magikh0e/pueo/assets/social-preview.png

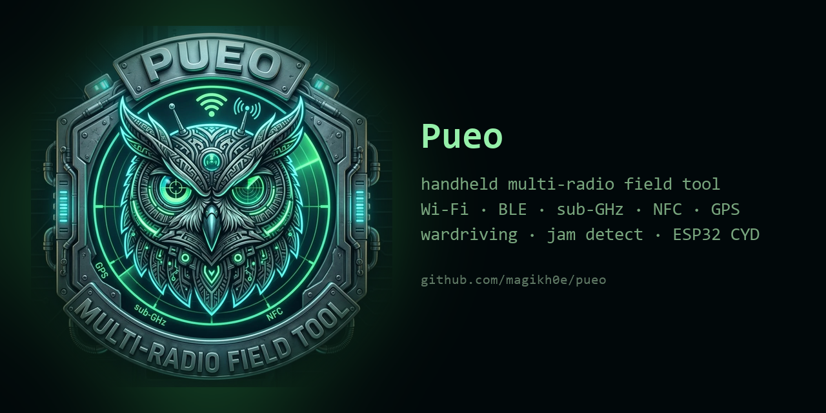
assets/social-preview.png
