magikh0e/pueo/ESP32-DIV/shared.h

#ifndef SHARED_H
#define SHARED_H
#include <stdint.h>
#include "BoardConfig.h"

/*──────────────────── Colors ────────────────────*/
const uint16_t GRAY = 0x8410, BLUE = 0x001F, RED = 0xF800,
               GREEN  = 0xB721, BLACK = 0x0000, WHITE = 0xFFFF,
               LIGHT_GRAY = 0xC618, DARK_GRAY = 0x4208;

uint16_t uiUniversalColor();
#define ORANGE uiUniversalColor()
               
#define TFT_DARKBLUE   0x3166
#define TFT_LIGHTBLUE  0x051F
#define TFTWHITE       0xFFFF
#define TFT_GRAY       0x8410

#ifdef TFT_GREEN
#undef TFT_GREEN
#endif
#define TFT_GREEN GREEN
#ifdef TFT_GREENYELLOW
#undef TFT_GREENYELLOW
#endif
#define TFT_GREENYELLOW GREEN

#define BG_Dark        0x20e4
#define BG_Light       0xf7de
#define FG_Dark        0x3166
#define FG_Light       0xe73c
#define LINE_Dark      0x8410  
#define LINE_Light     0x8410  
#define ICON_Dark      0xFBE4 
#define ICON_Light     0xFBE4
#define TEXT_Dark      0xFFFF
#define TEXT_Light     0x0000   
#define UI_ACCENT      0x3166

#define L_Dark        0x4208
#define L_Light       0xC618

// Default background for feature screens (separate from main menu background).
// Currently black, but you can change this one define to restyle all features.
#ifndef FEATURE_BG
#define FEATURE_BG BLACK
#endif

/*──────────────────── UI Defaults ────────────────────*/
#ifndef UI_BG
#define UI_BG UI.bg
#endif
#ifndef UI_FG
#define UI_FG UI.fg
#endif
#ifndef UI_ICON
#define UI_ICON UI.icon
#endif
#ifndef UI_TEXT
#define UI_TEXT UI.text
#endif
#ifndef UI_LINE
#define UI_LINE UI.line
#endif
#ifndef UI_LABLE
#define UI_LABLE UI.lable
#endif
#ifndef UI_ACCENT
#define UI_ACCENT UI.accent
#endif
#ifndef UI_WARN
#define UI_WARN UI.warn
#endif
#ifndef UI_OK
#define UI_OK GREEN
#endif

/*──────────────────── Project Info ────────────────────*/
/* What the board calls itself over BLE, which is what a phone shows when it
 * asks to pair. It said ESP32-DIV, which is upstream's name and not this
 * one, and it is the name that turned up on a phone minutes after Sour Apple
 * had been closed. Nothing compares against it; it is only announced. */
#ifndef PUEO_BLE_NAME
#define PUEO_BLE_NAME "Pueo"
#endif
#ifndef ESP32DIV_VERSION
#define ESP32DIV_VERSION "v1.7.2"
#endif


static inline constexpr uint8_t k0() { return (uint8_t)('h' - '`'); }

static const uint8_t OBF_PN[]   = {77, 91, 88, 59, 58, 37, 76, 65, 94};                              
static const uint8_t OBF_DN[]   = {75, 97, 110, 109, 122, 92, 109, 107, 96};                           
static const uint8_t OBF_EM[]   = {107, 97, 110, 109, 122, 124, 109, 107, 96, 72, 111, 101, 105, 97, 100, 38, 107, 103, 101};  
static const uint8_t OBF_GH[]   = {111, 97, 124, 96, 125, 106, 38, 107, 103, 101, 39, 107, 97, 110, 109, 122, 124, 109, 107, 96}; 
static const uint8_t OBF_WB[]   = {75, 97, 110, 109, 122, 92, 109, 107, 96, 38, 102, 109, 124};       

/*──────────────────── Board Selection ────────────────────*/
// Default is selected in BoardConfig.h. You can also pass a BOARD_* define
// from your build flags to target a board without editing source.
#if !defined(BOARD_ESP32_DIV_V2) && !defined(BOARD_CYD) && !defined(BOARD_ESP32_DIV_V1)
#define BOARD_ESP32_DIV_V2
#endif

#if (defined(BOARD_ESP32_DIV_V2) + defined(BOARD_CYD) + defined(BOARD_ESP32_DIV_V1)) > 1
#error "Select only one board: BOARD_ESP32_DIV_V2, BOARD_ESP32_DIV_V1, or BOARD_CYD"
#endif

#if defined(BOARD_CYD)
#ifndef ESP32DIV_BOARD_NAME
#define ESP32DIV_BOARD_NAME "CYD ESP32-2432S028R"
#endif
#ifndef HAS_PCF8574_BUTTONS
#define HAS_PCF8574_BUTTONS 0
#endif
#ifndef BOARD_HAS_ESP32S3
#define BOARD_HAS_ESP32S3 0
#endif
#elif defined(BOARD_ESP32_DIV_V1)
#ifndef ESP32DIV_BOARD_NAME
#define ESP32DIV_BOARD_NAME "ESP32-DIV V1 ESP32U"
#endif
#ifndef HAS_PCF8574_BUTTONS
#define HAS_PCF8574_BUTTONS 1
#endif
#ifndef BOARD_HAS_ESP32S3
#define BOARD_HAS_ESP32S3 0
#endif
#elif defined(BOARD_ESP32_DIV_V2)
#ifndef ESP32DIV_BOARD_NAME
#define ESP32DIV_BOARD_NAME "ESP32-DIV V2"
#endif
#ifndef HAS_PCF8574_BUTTONS
#define HAS_PCF8574_BUTTONS 1
#endif
#ifndef BOARD_HAS_ESP32S3
#define BOARD_HAS_ESP32S3 1
#endif
#else
#error "Unknown board: define BOARD_ESP32_DIV_V2, BOARD_ESP32_DIV_V1, or BOARD_CYD"
#endif

/* v1 ESP32 has less internal DRAM for static buffers; v2/S3 keeps full sizes. */
#if BOARD_HAS_ESP32S3
#define ESP32DIV_FFT_SAMPLES       256
#define ESP32DIV_FFT_PALETTE_SIZE  128
#define ESP32DIV_PKT_GRAPH_WIDTH   PUEO_SCREEN_W
#define ESP32DIV_JD_WAVE_WIDTH     (PUEO_SCREEN_W - 20)
#define ESP32DIV_JD_RSSI_SAMPLES   128
#define ESP32DIV_BLE_SCANNER_BARS  128
#define ESP32DIV_BLE_SCANNER_CHANS 128
#define ESP32DIV_ESB_RP_CAPTURES   8
#define ESP32DIV_ESB_RP_SEL_LINES  8
#define ESP32DIV_ESB_RP_LOG_LINES  10
#define ESP32DIV_MAX_WIFI_NETWORKS 50
#define ESP32DIV_PCAP_POOL_SIZE    10
#define ESP32DIV_PCAP_SNAP_LEN     2324
#define ESP32DIV_RFID_SRC_PAGES    256
#else
#define ESP32DIV_FFT_SAMPLES       256
#define ESP32DIV_FFT_PALETTE_SIZE  128
#define ESP32DIV_PKT_GRAPH_WIDTH   PUEO_SCREEN_W
#define ESP32DIV_JD_WAVE_WIDTH     (PUEO_SCREEN_W - 20)
#define ESP32DIV_JD_RSSI_SAMPLES   64
#define ESP32DIV_BLE_SCANNER_BARS  64
#define ESP32DIV_BLE_SCANNER_CHANS 64
#define ESP32DIV_ESB_RP_CAPTURES   4
#define ESP32DIV_ESB_RP_SEL_LINES  4
#define ESP32DIV_ESB_RP_LOG_LINES  6
#define ESP32DIV_MAX_WIFI_NETWORKS 28
/* Was 3, which lost every handshake. The pool is taken a slot at a time in
 * the promiscuous callback and given back after a card write, so its depth
 * is how long a burst can be before frames are dropped. A four-way exchange
 * is four frames in a few milliseconds and it arrives while the channel is
 * busy with the association that caused it. Sixteen slots of 549 bytes is
 * 8.8 KB of heap, held only while Packet Monitor runs. */
#define ESP32DIV_PCAP_POOL_SIZE    16
#define ESP32DIV_PCAP_SNAP_LEN     512
#define ESP32DIV_RFID_SRC_PAGES    128
#endif

/* The one FFT scratch pair, shared by the packet monitor and the sub-GHz
 * spectrum.
 *
 * Both features refill all ESP32DIV_FFT_SAMPLES entries every frame, set the
 * imaginary half to 1, transform in place, read the magnitudes and keep
 * nothing, so there is no state here to preserve across a frame. They also
 * cannot overlap: the dispatcher runs one feature's loop to its exit before
 * returning to the menu.
 *
 * Kept as one pair because static DRAM is what this part runs out of first.
 * Two pairs cost four kilobytes to hold the same numbers twice, while two
 * screens in a row have had to be cut down to find a few dozen bytes.
 */
extern double pueoFftReal[ESP32DIV_FFT_SAMPLES];
extern double pueoFftImag[ESP32DIV_FFT_SAMPLES];


/* Bring-up 2026-09-20: the board in hand is a 3.5" ESP32-3248S035R
 * (ST7796, 320x480, XPT2046 on the display's own SPI bus), not the 2.8"
 * ESP32-2432S028R this profile was written for. Everything the upstream
 * profile gets wrong about it is gathered here.
 * TODO: make this a real board profile rather than a pile of overrides. */

/* From the on-device calibrator, four crosshairs at the 20 px inset,
 * extrapolated out to the screen edges. Both axes run backwards on this
 * panel -- raw falls as the screen coordinate rises -- and that is carried
 * in the numbers rather than in a separate invert flag: the pair is
 * (raw at 0, raw at max), and map() handles a descending range natively.
 * Measured: x 3591/3259 at screen 20 against 514/406 at 300;
 *           y 3675/3673 at screen 20 against 372/457 at 460. */
#define TOUCH_PROFILE_ID "CYD35"
#define TOUCH_X_MIN 3637   /* raw at screen x = 0   */
#define TOUCH_X_MAX 259    /* raw at screen x = 319 */
#define TOUCH_Y_MIN 3822   /* raw at screen y = 0   */
#define TOUCH_Y_MAX 274    /* raw at screen y = 479 */
#define TOUCH_INVERT_Y 0   /* direction lives in the values above */
#define TOUCH_ROTATION 1   /* measured: rotation 0 transposed the axes */

#ifndef TOUCH_INVERT_Y
#define TOUCH_INVERT_Y 0
#endif

/*──────────────────── Touch calibration profiles ────────────────────*/
/* Factory defaults per board (raw XPT2046 range). Override in BoardConfig.h.
 * User-saved calibration in settings.json overrides when board id matches. */
#if defined(BOARD_CYD)
#ifndef TOUCH_PROFILE_ID
#define TOUCH_PROFILE_ID "CYD"
#endif
#ifndef TOUCH_X_MIN
#define TOUCH_X_MIN 200
#endif
#ifndef TOUCH_X_MAX
#define TOUCH_X_MAX 3700
#endif
#ifndef TOUCH_Y_MIN
#define TOUCH_Y_MIN 240
#endif
#ifndef TOUCH_Y_MAX
#define TOUCH_Y_MAX 3800
#endif
#elif defined(BOARD_ESP32_DIV_V1)
#ifndef TOUCH_PROFILE_ID
#define TOUCH_PROFILE_ID "ESP32_DIV_V1"
#endif
#ifndef TOUCH_X_MIN
#define TOUCH_X_MIN 300
#endif
#ifndef TOUCH_X_MAX
#define TOUCH_X_MAX 3800
#endif
#ifndef TOUCH_Y_MIN
#define TOUCH_Y_MIN 300
#endif
#ifndef TOUCH_Y_MAX
#define TOUCH_Y_MAX 3800
#endif
#elif defined(BOARD_ESP32_DIV_V2)
#ifndef TOUCH_PROFILE_ID
#define TOUCH_PROFILE_ID "ESP32_DIV_V2"
#endif
#ifndef TOUCH_X_MIN
#define TOUCH_X_MIN 280
#endif
#ifndef TOUCH_X_MAX
#define TOUCH_X_MAX 3850
#endif
#ifndef TOUCH_Y_MIN
#define TOUCH_Y_MIN 320
#endif
#ifndef TOUCH_Y_MAX
#define TOUCH_Y_MAX 3750
#endif
#endif

#ifndef TOUCH_PROFILE_ID
#define TOUCH_PROFILE_ID "GENERIC"
#endif
#ifndef TOUCH_X_MIN
#define TOUCH_X_MIN 300
#endif
#ifndef TOUCH_X_MAX
#define TOUCH_X_MAX 3800
#endif
#ifndef TOUCH_Y_MIN
#define TOUCH_Y_MIN 300
#endif
#ifndef TOUCH_Y_MAX
#define TOUCH_Y_MAX 3800
#endif

#ifndef TFT_ROTATION
#if defined(BOARD_CYD) || defined(BOARD_ESP32_DIV_V1)
#define TFT_ROTATION 0
#else
#define TFT_ROTATION 2
#endif
#endif

#ifndef TOUCH_SHARES_TFT_SPI
/* The 2.8" CYD uses a dedicated VSPI touch bus (T_CLK/T_DIN/T_OUT on
 * 25/32/39) with the TFT on HSPI. The 3.5" ESP32-3248S035R does not: its
 * XPT2046 sits on the display's own SPI bus behind TOUCH_CS. Bring-up on
 * 2026-09-20 read rails (x=4095 y=0 z=4095, unchanging under a press) on the
 * 25/32/39 trio, which is what an absent device looks like.
 *
 * This panel's XPT2046 hangs off the display's SPI behind TOUCH_CS, so it
 * is 1 here. It was a hand-set 1 for both panels once, which was wrong on
 * the other one, and the only symptom would have been a screen that never
 * reported a press. */
#define TOUCH_SHARES_TFT_SPI 1
#endif

#if defined(BOARD_CYD)
#ifndef TOUCH_ROTATION
/* Match TFT_ROTATION (RNT CYD test uses the same rotation for tft and touch). */
#define TOUCH_ROTATION TFT_ROTATION
#endif
#endif

/*──────────────────── I/O & Pins ────────────────────*/
// PCF8574 I2C address: auto-detect 0x20-0x27 by default.
// To force a fixed address, add to BoardConfig.h: #define pcf_ADDR 0x21
#ifndef pcf_ADDR
#define PCF8574_AUTO_DETECT 1
#define PCF8574_I2C_ADDR  0x20
#else
#define PCF8574_AUTO_DETECT 0
#define PCF8574_I2C_ADDR  pcf_ADDR
#endif
#define PCF8574_ADDR_MIN 0x20
#define PCF8574_ADDR_MAX 0x27
#if defined(BOARD_ESP32_DIV_V1)
#define BTN_UP       6
#define BTN_DOWN     3
#define BTN_LEFT     4
#define BTN_RIGHT    5
#define BTN_SELECT   7
#else
#define BTN_UP       7
#define BTN_DOWN     5
#define BTN_LEFT     3
#define BTN_RIGHT    4
#define BTN_SELECT   6
#endif

/* Buzzer, or on the 3.5" CYD the onboard amplifier -- see board_pueo.h.
 *
 * -1 is the "no buzzer" sentinel, and every use of it was guarded with
 * `#ifdef BUZZER_PIN`, which is true whatever the value is. So a board with
 * no buzzer still ran the beep, and ledcAttachPin(-1, ...) with it. Test
 * the value, not its existence. */
#ifndef BUZZER_PIN
#define BUZZER_PIN -1
#endif
#define PUEO_HAS_BUZZER (BUZZER_PIN >= 0)

/* Backlight / PWM */
#ifndef BACKLIGHT_PIN
#if defined(BOARD_CYD)
#define BACKLIGHT_PIN   21
#elif defined(BOARD_ESP32_DIV_V1)
#define BACKLIGHT_PIN   32
#else
#define BACKLIGHT_PIN   7
#endif
#endif
#define PWM_CHANNEL     0
#define PWM_FREQ        5000
#define PWM_RESOLUTION  8

/* XPT2046 (Touch) SPI */
#ifndef XPT2046_CS
#if defined(BOARD_CYD)
#define XPT2046_CS   33
#elif defined(BOARD_ESP32_DIV_V1)
#define XPT2046_CS   33
#else
#define XPT2046_CS   18
#endif
#endif
#ifndef XPT2046_MOSI
#if defined(BOARD_CYD)
#define XPT2046_MOSI 32
#elif defined(BOARD_ESP32_DIV_V1)
#define XPT2046_MOSI 32
#else
#define XPT2046_MOSI 35
#endif
#endif
#ifndef XPT2046_MISO
#if defined(BOARD_CYD)
#define XPT2046_MISO 39
#elif defined(BOARD_ESP32_DIV_V1)
#define XPT2046_MISO 35
#else
#define XPT2046_MISO 37
#endif
#endif
#ifndef XPT2046_CLK
#if defined(BOARD_CYD)
#define XPT2046_CLK  25
#elif defined(BOARD_ESP32_DIV_V1)
#define XPT2046_CLK  25
#else
#define XPT2046_CLK  36
#endif
#endif
#ifndef XPT2046_IRQ
#if defined(BOARD_CYD)
#define XPT2046_IRQ  36
#elif defined(BOARD_ESP32_DIV_V1)
#define XPT2046_IRQ  34
#else
#define XPT2046_IRQ  255
#endif
#endif

/* SD Card */
#ifndef SD_CS
#if defined(BOARD_CYD)
#define SD_CS    5
#elif defined(BOARD_ESP32_DIV_V1)
#define SD_CS    5
#else
#define SD_CS    10
#endif
#endif
#ifndef SD_MOSI
#if defined(BOARD_CYD)
#define SD_MOSI  23
#elif defined(BOARD_ESP32_DIV_V1)
#define SD_MOSI  23
#else
#define SD_MOSI  11
#endif
#endif
#ifndef SD_MISO
#if defined(BOARD_CYD)
#define SD_MISO  19
#elif defined(BOARD_ESP32_DIV_V1)
#define SD_MISO  19
#else
#define SD_MISO  13
#endif
#endif
#ifndef SD_SCLK
#if defined(BOARD_CYD)
#define SD_SCLK  18
#elif defined(BOARD_ESP32_DIV_V1)
#define SD_SCLK  18
#else
#define SD_SCLK  12
#endif
#endif
#if !defined(BOARD_CYD) && !defined(BOARD_ESP32_DIV_V1) && !defined(SD_CD)
#define SD_CD    38
#endif
#ifndef SD_CS_PIN
#define SD_CS_PIN 5
#endif

/* PN532 RFID/NFC (SPI).
 * CYD has few spare GPIOs; these are suggested external wiring defaults.
 * Override any pin below if your wiring differs. Requires Adafruit PN532 library. */
#ifndef PN532_SCK
#if defined(BOARD_CYD)
#define PN532_SCK  18
#else
#define PN532_SCK  12
#endif
#endif
#ifndef PN532_MISO
#if defined(BOARD_CYD)
#define PN532_MISO 19
#else
#define PN532_MISO 11
#endif
#endif
#ifndef PN532_MOSI
#if defined(BOARD_CYD)
#define PN532_MOSI 23
#else
#define PN532_MOSI 13
#endif
#endif
#ifndef PN532_SS
#if defined(BOARD_CYD)
#define PN532_SS   25
#else
#define PN532_SS   5
#endif
#endif

/* UART (if you use hardware serial on external pins) */
#ifndef RX_PIN
#if defined(BOARD_CYD)
#define RX_PIN 35
#elif defined(BOARD_ESP32_DIV_V1)
#define RX_PIN 16
#else
#define RX_PIN 6
#endif
#endif
#ifndef TX_PIN
#if defined(BOARD_CYD)
#define TX_PIN 22
#elif defined(BOARD_ESP32_DIV_V1)
#define TX_PIN 26
#else
#define TX_PIN 3
#endif
#endif

/* Neo-6M GPS — GPS module TX → ESP RX, GPS RX → ESP TX (optional). Uses UART2 by default. */
#ifndef GPS_UART_RX
#if defined(BOARD_CYD)
#define GPS_UART_RX 35
#elif defined(BOARD_ESP32_DIV_V1)
#define GPS_UART_RX 3
#else
#define GPS_UART_RX 5
#endif
#endif
#ifndef GPS_UART_TX
#if defined(BOARD_CYD)
#define GPS_UART_TX 22
#elif defined(BOARD_ESP32_DIV_V1)
#define GPS_UART_TX 1
#else
#define GPS_UART_TX 6
#endif
#endif

/* CC1101 (Sub-GHz) */
#ifndef CC1101_SCK
#if defined(BOARD_CYD)
#define CC1101_SCK  18
#elif defined(BOARD_ESP32_DIV_V1)
#define CC1101_SCK  18
#else
#define CC1101_SCK  12
#endif
#endif
#ifndef CC1101_MISO
#if defined(BOARD_CYD)
#define CC1101_MISO 19
#elif defined(BOARD_ESP32_DIV_V1)
#define CC1101_MISO 19
#else
#define CC1101_MISO 13
#endif
#endif
#ifndef CC1101_MOSI
#if defined(BOARD_CYD)
#define CC1101_MOSI 23
#elif defined(BOARD_ESP32_DIV_V1)
#define CC1101_MOSI 23
#else
#define CC1101_MOSI 11
#endif
#endif
#ifndef CC1101_CS
#if defined(BOARD_CYD)
#define CC1101_CS   27
#elif defined(BOARD_ESP32_DIV_V1)
#define CC1101_CS   27
#else
#define CC1101_CS   5
#endif
#endif

/* SubGHz (RCSwitch/Replay) data pins (wired to CC1101 GDO pins) */
// Override these in your board config if your wiring differs.
#ifndef SUBGHZ_RX_PIN
#if defined(BOARD_CYD)
#define SUBGHZ_RX_PIN 35
#elif defined(BOARD_ESP32_DIV_V1)
#define SUBGHZ_RX_PIN 16
#else
#define SUBGHZ_RX_PIN 3
#endif
#endif
#ifndef SUBGHZ_TX_PIN
#if defined(BOARD_CYD)
#define SUBGHZ_TX_PIN 22
#elif defined(BOARD_ESP32_DIV_V1)
#define SUBGHZ_TX_PIN 26
#else
#define SUBGHZ_TX_PIN 6
#endif
#endif

// CC1101 GDO mapping (used by ELECHOUSE_cc1101.setGDO).
// Default follows the legacy wiring used in the SubGHz code: setGDO(TX, RX).
#ifndef CC1101_GDO0
#define CC1101_GDO0 SUBGHZ_TX_PIN
#endif
#ifndef CC1101_GDO2
#define CC1101_GDO2 SUBGHZ_RX_PIN
#endif

/* SubGHz debug (0=off, 1=on) */
#ifndef SUBGHZ_DEBUG
#define SUBGHZ_DEBUG 0
#endif

/* NRF24 */
#ifndef CE_PIN_1
#if defined(BOARD_CYD)
#define CE_PIN_1  16
#elif defined(BOARD_ESP32_DIV_V1)
#define CE_PIN_1  4
#else
#define CE_PIN_1  15
#endif
#endif
#ifndef CSN_PIN_1
#if defined(BOARD_CYD)
#define CSN_PIN_1 17
#elif defined(BOARD_ESP32_DIV_V1)
#define CSN_PIN_1 5
#else
#define CSN_PIN_1 4
#endif
#endif
#ifndef CE_PIN_2
#if defined(BOARD_CYD)
#define CE_PIN_2  22
#elif defined(BOARD_ESP32_DIV_V1)
#define CE_PIN_2  26
#else
#define CE_PIN_2  47
#endif
#endif
#ifndef CSN_PIN_2
#if defined(BOARD_CYD)
#define CSN_PIN_2 27
#elif defined(BOARD_ESP32_DIV_V1)
#define CSN_PIN_2 27
#else
#define CSN_PIN_2 48
#endif
#endif
#ifndef CE_PIN_3
#if defined(BOARD_CYD)
#define CE_PIN_3  4
#elif defined(BOARD_ESP32_DIV_V1)
#define CE_PIN_3  16
#else
#define CE_PIN_3  14
#endif
#endif
#ifndef CSN_PIN_3
#if defined(BOARD_CYD)
#define CSN_PIN_3 25
#elif defined(BOARD_ESP32_DIV_V1)
#define CSN_PIN_3 17
#else
#define CSN_PIN_3 21
#endif
#endif

/* nRF24 bit-bang CE/CSN pair used by Scanner / ESB / MouseJack helpers. */
#ifndef NRF24_SCAN_CE
#define NRF24_SCAN_CE  CE_PIN_3
#endif
#ifndef NRF24_SCAN_CSN
#define NRF24_SCAN_CSN CSN_PIN_3
#endif
/* Shared SPI pinout for those nRF features (must match board SD/CC1101 bus on v1). */
#if BOARD_HAS_ESP32S3
#ifndef NRF24_SPI_SCK
#define NRF24_SPI_SCK  12
#endif
#ifndef NRF24_SPI_MISO
#define NRF24_SPI_MISO 13
#endif
#ifndef NRF24_SPI_MOSI
#define NRF24_SPI_MOSI 11
#endif
#ifndef NRF24_SPI_SS
#define NRF24_SPI_SS   4
#endif
#else
#ifndef NRF24_SPI_SCK
#define NRF24_SPI_SCK  SD_SCLK
#endif
#ifndef NRF24_SPI_MISO
#define NRF24_SPI_MISO SD_MISO
#endif
#ifndef NRF24_SPI_MOSI
#define NRF24_SPI_MOSI SD_MOSI
#endif
#ifndef NRF24_SPI_SS
#define NRF24_SPI_SS   CSN_PIN_1
#endif
#endif

/* IR Remote (Record/Replay)
 * NOTE: Default pins overlap with the optional NRF24 #3 wiring above.
 * If you use NRF24 on CE_PIN_3/CSN_PIN_3, override these in your board config.
 */
#ifndef IR_RX_PIN
#if defined(BOARD_CYD)
#define IR_RX_PIN 35
#elif defined(BOARD_ESP32_DIV_V1)
#define IR_RX_PIN 4
#else
#define IR_RX_PIN 21
#endif
#endif
#ifndef IR_TX_PIN
#if defined(BOARD_CYD)
#define IR_TX_PIN 4
#elif defined(BOARD_ESP32_DIV_V1)
#define IR_TX_PIN 5
#else
#define IR_TX_PIN 14
#endif
#endif
#ifndef IR_DEFAULT_KHZ
#define IR_DEFAULT_KHZ 38
#endif

/*──────────────────── Display & Touch ────────────────────*/

/* The panel's dimensions, in one place, for the whole UI.
 *
 * Every feature screen used to carry its own copy of these as literals --
 * 43 of them across four files -- which is why the 3.5" board drew each app
 * into the top-left 240x320 of a 320x480 display and left the rest black.
 *
 * Deliberately not TFT_eSPI's TFT_WIDTH/TFT_HEIGHT: those are only correct
 * once TFT_eSPI.h has been included, and several of these screens compute
 * layout in headers that do not include it. */
#define PUEO_SCREEN_W 320
#define PUEO_SCREEN_H 480

/* The status bar has two heights, and which one is showing is a property of
 * the screen under it rather than of the build.
 *
 * Every feature screen puts a toolbar immediately below the bar -- a survey
 * of the drawing calls finds 74 of them with a literal y between 20 and 48,
 * eleven of those at exactly 20. Those screens cannot give the bar another
 * pixel without something being painted over.
 *
 * The menu grid is the exception. Its first tile is at Y_START, which is 44,
 * so there are 24 px of bar-coloured nothing between the bar and the tiles.
 * That is the space this spends, and it spends it without moving a tile. */
/* Menu tile icon size. A 16 px icon on a 145x92 tile looks like what it is,
 * a leftover from the 240x320 layout the tiles grew out of. 32 fills it.
 * The icons are 16x16 bitmaps; 32 is the 16 doubled. */
/* Body text on the list screens.
 *
 * This panel is dense rather than roomy: 577 px across a 3.5 inch diagonal
 * is 165 ppi, so a glyph in a given number of pixels is physically small.
 * Font 1 at size 1 is a 1.23 mm cap height, about three and a half point.
 *
 * What the pixels bought was rows, not legibility. Surveillance showed
 * thirteen of them at that size, all of it text you cannot read at arm's
 * length. Eight rows you can read is the better trade.
 *
 * Font 2 rather than font 1 at size 2: it is proportional, so it fits about
 * 40% more characters on a line, and these screens are mostly MAC addresses
 * and vendor names.
 *
 * The drone detector deliberately does NOT use this. Four lines per aircraft
 * at this size takes it from ten rows to five against a six-aircraft table,
 * and there the count is the information. */
#define PUEO_BODY_FONT 2
#define PUEO_BODY_H    16
#define PUEO_BODY_LINE 18   /* pitch between consecutive lines */
#define PUEO_BODY_GAP  20   /* pitch across a break between blocks */
#define PUEO_BODY_SIZE 2    /* for drawString's size argument, font 1 */

#define PUEO_TILE_ICON 32

#define PUEO_STATUS_SHORT 20
#define PUEO_STATUS_TALL  34

#ifndef TFT_WIDTH
#define TFT_WIDTH PUEO_SCREEN_W
#endif
#ifndef TFT_HEIGHT
#define TFT_HEIGHT PUEO_SCREEN_H
#endif
#ifndef STATUS_BAR_Y_OFFSET
#define STATUS_BAR_Y_OFFSET 0
#endif

/*──────────────────── Timing ────────────────────*/
#ifndef DEBOUNCE_MS
#define DEBOUNCE_MS 40
#endif
#ifndef LONG_PRESS_MS
#define LONG_PRESS_MS 800
#endif
#ifndef REPEAT_SCROLL_MS
#define REPEAT_SCROLL_MS 120
#endif

/*──────────────────── Backlight Levels ────────────────────*/
#ifndef BKL_LEVEL_MIN
#define BKL_LEVEL_MIN 10
#endif
#ifndef BKL_LEVEL_MED
#define BKL_LEVEL_MED 128
#endif
#ifndef BKL_LEVEL_MAX
#define BKL_LEVEL_MAX 255
#endif

/*──────────────────── Filesystem ────────────────────*/
/* One folder on the card, and everything Pueo writes lives in it.
 *
 * These used to be seven directories and two loose files in the root, which
 * makes the card Pueo's rather than its owner's: somebody who also keeps
 * photographs or a Flipper's dumps on there got /logs, /captures, /config,
 * /esb, /subghz, /captive_portal and a wd_wigle_upload.csv scattered among
 * them, with nothing saying which program they belonged to.
 *
 * Every write path is built from PUEO_DIR so there is one place to change
 * it, and check_sd_paths.py asserts that nothing escapes it -- a bare
 * "/something" passed to SD.open is the whole of what went wrong before.
 *
 * The three paths that are NOT writes are named there as exceptions:
 * ssids.txt, /ducky and firmware.bin are files the owner puts on the card
 * for Pueo to read, and each reads PUEO_DIR first and the old root second,
 * so a card that already works keeps working. */
#ifndef PUEO_DIR
#define PUEO_DIR "/pueo"
#endif
#ifndef FS_MOUNT_OK_MSG
#define FS_MOUNT_OK_MSG "SD OK"
#endif
#ifndef FS_MOUNT_FAIL_MSG
#define FS_MOUNT_FAIL_MSG "SD Fail"
#endif
#ifndef LOG_DIR
#define LOG_DIR PUEO_DIR "/logs"
#endif
#ifndef CAPTURE_DIR
#define CAPTURE_DIR PUEO_DIR "/captures"
#endif
#ifndef CONFIG_DIR
#define CONFIG_DIR PUEO_DIR "/config"
#endif
#ifndef CPORTAL_DIR
#define CPORTAL_DIR PUEO_DIR "/captive_portal"
#endif
#ifndef ESB_DIR
#define ESB_DIR PUEO_DIR "/esb"
#endif
#ifndef SUBGHZ_SD_DIR
#define SUBGHZ_SD_DIR PUEO_DIR "/subghz"
#endif

/*──────────────────── Battery ────────────────────*/
#ifndef BATTERY_ADC_PIN
#if defined(BOARD_ESP32_DIV_V1)
#define BATTERY_ADC_PIN 36
#elif defined(BOARD_CYD)
#define BATTERY_ADC_PIN -1
#else
#define BATTERY_ADC_PIN -1
#endif
#endif
#ifndef BATTERY_VDIV_R1
#define BATTERY_VDIV_R1 200000.0f
#endif
#ifndef BATTERY_VDIV_R2
#define BATTERY_VDIV_R2 100000.0f
#endif
#ifndef BATTERY_LOW_VOLT
#define BATTERY_LOW_VOLT 3.40f
#endif

/*──────────────────── Wi-Fi ────────────────────*/
#ifndef WIFI_SCAN_ACTIVE_MS
#define WIFI_SCAN_ACTIVE_MS  500
#endif
#ifndef WIFI_SCAN_PASSIVE_MS
#define WIFI_SCAN_PASSIVE_MS 0
#endif
#ifndef WIFI_SPECTRUM_FFT_N
#define WIFI_SPECTRUM_FFT_N  256
#endif

/*──────────────────── BLE ────────────────────*/
#ifndef BLE_ADV_INTERVAL_MS
#define BLE_ADV_INTERVAL_MS 100
#endif
#ifndef BLE_JAMMER_SWEEP_MS
#define BLE_JAMMER_SWEEP_MS 80
#endif

/*──────────────────── Sub-GHz / RF ────────────────────*/
#ifndef SUBGHZ_SAMPLE_RATE
#define SUBGHZ_SAMPLE_RATE 38000
#endif
#ifndef SUBGHZ_DEFAULT_FREQ
#define SUBGHZ_DEFAULT_FREQ 433920000UL
#endif
#ifndef NRF24_DATA_RATE
#define NRF24_DATA_RATE    2
#endif
#ifndef NRF24_PA_LEVEL
#define NRF24_PA_LEVEL     3
#endif
#ifndef CC1101_DEFAULT_MOD
#define CC1101_DEFAULT_MOD 2
#endif

/*──────────────────── Feature Flags ────────────────────*/
#ifndef FEATURE_WIFI_TOOLS
#define FEATURE_WIFI_TOOLS   1
#endif
#ifndef FEATURE_BLE_TOOLS
#define FEATURE_BLE_TOOLS    1
#endif
#ifndef FEATURE_BLE_DUCKY
#define FEATURE_BLE_DUCKY    BOARD_HAS_ESP32S3
#endif
#ifndef FEATURE_SUBGHZ_TOOLS
#define FEATURE_SUBGHZ_TOOLS 1
#endif

/*──────────────────── Utilities ────────────────────*/
#ifndef ARRAY_SIZE
#define ARRAY_SIZE(x) (sizeof(x)/sizeof((x)[0]))
#endif
#ifndef UNUSED
#define UNUSED(x) (void)(x)
#endif

/*──────────────────── Settings / Themes ────────────────────*/
enum class Theme : uint8_t { Dark = 0, Light = 1 };

#ifndef SETTINGS_PATH
#define SETTINGS_PATH CONFIG_DIR "/settings.json"
#endif
/* Where settings.json lived before PUEO_DIR. Read when the new one is not
 * there, never written, so the first save after the update migrates it.
 * Without this every setting resets on the first boot after the change --
 * stealth off, logging off, backlight back to default -- and nothing on
 * screen says why. */
#ifndef SETTINGS_LEGACY_PATH
#define SETTINGS_LEGACY_PATH "/config/settings.json"
#endif

void displaySubmenu();

/*──────────────────── Runtime UI Palette ────────────────────*/
struct UiPalette { uint16_t bg, fg, icon, text, accent, line, lable, warn, ok; };
extern UiPalette UI;                   
void applyThemeToPalette(Theme t);
uint16_t uiUniversalColor();

/*──────────────────── UI Text Helpers ────────────────────*/
// Dim label text color (used for *text* only).
// Keep UI_LABLE unchanged because it's also used for fills (e.g., status bar bg).
static inline uint16_t uiDimTextColor() {
  // In Dark theme, UI_LABLE (L_Dark) is intentionally very dark; brighten text a bit.
  return (UI.bg == BG_Dark) ? GRAY : UI_LABLE;
}
#ifndef UI_DIM_TEXT
#define UI_DIM_TEXT uiDimTextColor()
#endif

/*──────────────────── Global State Flags ────────────────────*/
extern bool in_sub_menu;
extern bool feature_active;
extern bool submenu_initialized;
extern bool is_main_menu;
extern bool feature_exit_requested;

#endif
