magikh0e/pueo/ESP32-DIV/gps.cpp

#include "Stealth.h"
#include <Arduino.h>
#include <HardwareSerial.h>
#include "SettingsStore.h"
#include <TFT_eSPI.h>
#include <esp_heap_caps.h>
#include <math.h>
#include <stdint.h>
#include <ctype.h>
#include <stdarg.h>
#include <stdlib.h>
#include <string.h>
#include <string>

#include <WiFi.h>
#include <WiFiClientSecure.h>
#include "mbedtls/base64.h"
#include "freertos/FreeRTOS.h"
#include "freertos/task.h"

#include "BleCompat.h"
#include "Branding.h"

#include "gps.h"
#include "icon.h"
#include "KeyboardUI.h"
#include "shared.h"
#include "Spotter.h"
#include "Touchscreen.h"
#include "utils.h"

#ifndef GPS_UART_NUM
#define GPS_UART_NUM 2
#endif
#ifndef GPS_UART_BAUD
#define GPS_UART_BAUD 9600
#endif

#ifndef M_PI
#define M_PI 3.14159265358979323846
#endif

static HardwareSerial gpsSerial(GPS_UART_NUM);

/* ── GPS port bracket, incl. UART0 handover ──────────────────────────────────
 * On Pueo the GPS module's TX lands on GPIO 1, which is UART0's TX. That
 * pin is picked on purpose (GPIO 3 is driven by the USB-UART bridge and would
 * fight the GPS), but UART0 holds GPIO 1 as a push-pull output, so the console
 * has to let go of the pad before UART2 can read it.
 *
 * Every gpsSerial begin/end goes through gpsPortOpen/gpsPortClose so the
 * handover can never be skipped at one call site. USB serial is dead while the
 * GPS is open; it comes back on close. */
#if defined(PUEO_GPS_STEALS_UART0) && PUEO_GPS_STEALS_UART0

#include "driver/gpio.h"

#ifndef PUEO_CONSOLE_BAUD
#define PUEO_CONSOLE_BAUD 115200
#endif

static bool s_uart0Parked = false;

static void gpsUart0Release() {
  if (s_uart0Parked) {
    return;
  }
  Serial.flush();
  Serial.end();
  /* Drop the UART0 matrix routing and leave the pad as a plain input so the
   * GPS is the only driver on the net. */
  gpio_reset_pin((gpio_num_t)GPS_UART_RX);
  pinMode(GPS_UART_RX, INPUT);
  s_uart0Parked = true;
}

static void gpsUart0Restore() {
  if (!s_uart0Parked) {
    return;
  }
  gpio_reset_pin((gpio_num_t)GPS_UART_RX);
  Serial.begin(PUEO_CONSOLE_BAUD);
  s_uart0Parked = false;
}

#else
static void gpsUart0Release() {}
static void gpsUart0Restore() {}
#endif

/* Whether the module is talking at all, which is a different question from
 * whether it has a fix.
 *
 * lastGpsByteMs is any byte on the UART, not a parsed sentence and not a
 * valid checksum: a module at the wrong baud rate is present and should not
 * be reported as missing, and one emitting GSV with nothing in view is
 * working exactly as it should.
 *
 * gpsPortOpenMs is the grace period. GPIO 1 is shared with the console, so
 * the port is opened and closed around each session and there is always a
 * moment after opening when silence means nothing yet.
 *
 * Declared up here rather than beside the rest of the NMEA state because
 * gpsPortOpen() below stamps the second one. */
uint32_t lastGpsByteMs = 0;
uint32_t gpsPortOpenMs = 0;

static void gpsPortOpen() {
  gpsSerial.end();
  gpsUart0Release();
  gpsSerial.begin(GPS_UART_BAUD, SERIAL_8N1, GPS_UART_RX, GPS_UART_TX);
  /* A fresh session starts with nothing heard, so a module unplugged
   * between sessions is reported rather than remembered as working. */
  gpsPortOpenMs = millis();
  lastGpsByteMs = 0;
}

static void gpsPortClose() {
  gpsSerial.end();
  gpsUart0Restore();
}
static TFT_eSprite gScanPanel(&tft);
static bool gScanPanelReady = false;
static int gScanPanelAllocW = 0;
static int gScanPanelAllocH = 0;

/* 96 rows is still a readable sky view on either panel. The old floor was
 * 200, which at 320 px wide is 64,000 bytes of contiguous heap, so it gave
 * up while still asking for a lot. */
static constexpr int kScanSpriteHMin = 96;

/* Kept for the failure screen. USB serial is dead while a GPS feature holds
 * GPIO 1, so the only place a diagnostic can go is the display. */
static size_t gScanLargestBlock = 0;

static bool ensureScanPanelSprite(int panelW, int panelH) {
  if (panelW <= 0 || panelH <= 32) {
    return false;
  }
  if (gScanPanelReady && panelW == gScanPanelAllocW && gScanPanelAllocH <= panelH &&
      gScanPanelAllocH >= kScanSpriteHMin) {
    return true;
  }

  if (gScanPanelReady) {
    gScanPanel.deleteSprite();
    gScanPanelReady = false;
    gScanPanelAllocW = gScanPanelAllocH = 0;
  }

  /* Ask rather than probe. Descending blindly from the full height in steps
   * of 18 meant about thirty failed allocations and 600 ms of delays before
   * the message appeared, all to discover something the allocator knew. */
  gScanLargestBlock = heap_caps_get_largest_free_block(MALLOC_CAP_8BIT);
  const size_t headroom = 2048;         // sprite object, and room to breathe
  int hFit = 0;
  if (gScanLargestBlock > headroom) {
    hFit = (int)((gScanLargestBlock - headroom) / (size_t)panelW);
  }
  if (hFit > panelH) {
    hFit = panelH;
  }

  /* 8bpp only. Each height used to be tried at 8 and then at 16, and 16
   * needs twice the memory, so the second attempt could never succeed after
   * the first had just failed. */
  gScanPanel.setColorDepth(8);
  for (int h = hFit; h >= kScanSpriteHMin; h -= 18) {
    if (gScanPanel.createSprite(panelW, h)) {
      gScanPanelReady = true;
      gScanPanelAllocW = panelW;
      gScanPanelAllocH = h;
      return true;
    }
  }

  gScanPanel.setColorDepth(16);
  gScanPanelAllocW = gScanPanelAllocH = 0;
  return false;
}

static bool gWardSuppressBottomTouchExit = false;

namespace {

constexpr size_t kLineCap = 128;
constexpr uint32_t kRedrawMs = 450;

constexpr int kGfxTop = 22;
constexpr int kMaxSatRows = 48;
constexpr int kSnrBarMax = 50;

constexpr int kSkyRDefault = 52;
constexpr int kSkyCyDefault = 110;
constexpr int kSkyCyBig = 118;
constexpr int kSkyRBig = 70;
constexpr int kListRowsVisible = 9;

constexpr int kUiPad = 5;
constexpr int kUiGap = 3;
constexpr int kHeaderY = 2;
constexpr int kTabsY = 24;
constexpr int kCardsY = 46;
/* 32, not 29: the value inside is font 2 at 16 px rather than font 1
 * at 8. Label 8 px at y+2, value at y+13, 3 px below. The card ends
 * at 78 against kBodyTop 82, inside slack that was already there. */
constexpr int kCardH = 32;
constexpr int kBodyTop = 82;

constexpr uint32_t kNavCooldownMs = 520;

char lineBuf[kLineCap];
size_t lineLen = 0;

enum : uint8_t {
  SYS_GPS = 0,
  SYS_GLO,
  SYS_GAL,
  SYS_BDS,
  SYS_QZS,
  SYS_UNK,
};

struct SatRow {
  uint8_t prn;
  uint8_t system;
  int16_t elev;
  int16_t azim;
  int16_t snr;
  bool inSolution;
};

SatRow rows[kMaxSatRows];
int rowCount = 0;
uint32_t lastGsvMs = 0;

enum class ViewMode : uint8_t { Combined = 0, SkyOnly, ListOnly };
ViewMode viewMode = ViewMode::Combined;
int listScroll = 0;
uint32_t lastViewBtnMs = 0;

static bool prevHwLeft = false;
static bool prevHwRight = false;
static bool prevHwUp = false;
static bool prevHwDown = false;
static bool touchNavArm = true;

char utcStr[12] = "--:--:--";
char dateStr[12] = "--/--/--";
float hdopLive = -1.f;
float pdopLive = -1.f;
uint8_t fixQuality = 0;
uint8_t gsaFixMode = 1;
uint8_t satsUsedGga = 0;
double navLat = NAN;
double navLon = NAN;
float navAltM = NAN;
bool rmcNavValid = false;
uint32_t lastNavMs = 0;

/* 5 s of silence from a freshly opened port is a module that is not there.
 * A GPS emits its first sentence within about a second of power, long
 * before it can fix. 8 s for one that was talking and stopped, which is the
 * figure the Satellites screen already used for GSV.
 *
 * Silent is confirmed with no module fitted: the Satellites screen shows
 * "no GPS" and Wardrive's card shows NONE with the GPIO 1 line. Those are
 * separate paths sharing only gpsLinkState(), so that is two results.
 *
 * The 5000 itself is not confirmed by that, and should not be read as
 * though it were. No module has been timed from power to first sentence.
 * One slower than five seconds would show NONE at startup and look exactly
 * like a wiring fault, which is the failure this number can still cause. */
constexpr uint32_t kGpsSilentMs = 5000;
constexpr uint32_t kGpsStaleMs = 8000;

enum class GpsLink : uint8_t { Opening, Silent, Stale, Live };

static GpsLink gpsLinkState() {
  const uint32_t now = millis();
  if (lastGpsByteMs != 0) {
    return ((uint32_t)(now - lastGpsByteMs) > kGpsStaleMs) ? GpsLink::Stale
                                                           : GpsLink::Live;
  }
  if (gpsPortOpenMs == 0) {
    return GpsLink::Opening;
  }
  return ((uint32_t)(now - gpsPortOpenMs) > kGpsSilentMs) ? GpsLink::Silent
                                                          : GpsLink::Opening;
}

void stripChecksum(char* s) {
  char* star = strchr(s, '*');
  if (star) {
    *star = '\0';
  }
  char* cr = strchr(s, '\r');
  if (cr) {
    *cr = '\0';
  }
}

int splitCommaFields(char* s, const char** fields, int maxFields) {
  int nf = 0;
  fields[nf++] = s;
  for (; *s && nf < maxFields; ++s) {
    if (*s == ',') {
      *s = '\0';
      fields[nf++] = s + 1;
    }
  }
  return nf;
}

uint8_t talkerSystem(char c1, char c2) {
  if (c1 == 'G' && c2 == 'P') {
    return SYS_GPS;
  }
  if (c1 == 'G' && c2 == 'L') {
    return SYS_GLO;
  }
  if (c1 == 'G' && c2 == 'A') {
    return SYS_GAL;
  }
  if (c1 == 'G' && c2 == 'B') {
    return SYS_BDS;
  }
  if (c1 == 'G' && c2 == 'Q') {
    return SYS_QZS;
  }
  if (c1 == 'G' && c2 == 'N') {
    return SYS_GPS;
  }
  return SYS_UNK;
}

const char* systemShortTag(uint8_t sys) {
  switch (sys) {
    case SYS_GPS:
      return "GPS";
    case SYS_GLO:
      return "GLO";
    case SYS_GAL:
      return "GAL";
    case SYS_BDS:
      return "BDS";
    case SYS_QZS:
      return "QZS";
    default:
      return "?";
  }
}

uint16_t baseColorForSystem(uint8_t sys) {
  switch (sys) {
    case SYS_GPS:
      return 0x07FF;
    case SYS_GLO:
      return 0xFA20;
    case SYS_GAL:
      return 0xAFE5;
    case SYS_BDS:
      return ORANGE;
    case SYS_QZS:
      return 0xFC9F;
    default:
      return LIGHT_GRAY;
  }
}

static uint16_t scaleRgb565(uint16_t c, int num, int den) {
  if (den <= 0) {
    return c;
  }
  uint16_t r = ((c >> 11) & 0x1F);
  uint16_t g = ((c >> 5) & 0x3F);
  uint16_t b = (c & 0x1F);
  r = (uint16_t)((r * num) / den);
  g = (uint16_t)((g * num) / den);
  b = (uint16_t)((b * num) / den);
  return (uint16_t)((r << 11) | (g << 5) | b);
}

uint16_t snrTint(uint16_t base, int16_t snr) {
  if (snr < 0) {
    return scaleRgb565(base, 10, 16);
  }
  int k = snr;
  if (k > 45) {
    k = 45;
  }
  uint8_t bump = (uint8_t)(k * 3 / 2);
  uint16_t r = ((base >> 11) & 0x1F);
  uint16_t g = ((base >> 5) & 0x3F);
  uint16_t b = (base & 0x1F);
  r = (uint16_t)min(31, (int)r + (bump >> 3));
  g = (uint16_t)min(63, (int)g + (bump >> 2));
  b = (uint16_t)min(31, (int)b + (bump >> 3));
  return (uint16_t)((r << 11) | (g << 5) | b);
}

void parseOptionalInt16(const char* p, int16_t& out) {
  if (!p || !*p) {
    out = -1;
    return;
  }
  out = (int16_t)strtol(p, nullptr, 10);
}

double dmToDeg(const char* dm, char dir) {
  if (!dm || !*dm || (dir != 'N' && dir != 'S' && dir != 'E' && dir != 'W')) {
    return NAN;
  }
  double v = strtod(dm, nullptr);
  int deg = (int)(v / 100.0);
  double minutes = v - (double)deg * 100.0;
  double dec = (double)deg + minutes / 60.0;
  if (dir == 'S' || dir == 'W') {
    dec = -dec;
  }
  return dec;
}

void formatUtcFromField(const char* field) {
  if (!field || strlen(field) < 6) {
    strncpy(utcStr, "--:--:--", sizeof(utcStr));
    return;
  }
  // This is a raw NMEA field off the serial line and the length check
  // above is the only thing it has passed. On non-digit bytes the arithmetic
  // below produces values well outside 0-99, and the formatted result runs
  // past utcStr. Reject anything that is not six digits.
  for (int i = 0; i < 6; i++) {
    if (field[i] < '0' || field[i] > '9') {
      strncpy(utcStr, "--:--:--", sizeof(utcStr));
      return;
    }
  }
  const int h = (field[0] - '0') * 10 + (field[1] - '0');
  const int m = (field[2] - '0') * 10 + (field[3] - '0');
  const int s = (field[4] - '0') * 10 + (field[5] - '0');
  // Six digits still permit impossible times, e.g. "99:99:99". Rejecting
  // them keeps garbage off the display, and it is also the only form of the
  // bound gcc 8 can follow here -- it does not carry the digit loop above
  // through to these reads, so without this it still sees %02d as unbounded.
  if (h < 0 || h > 23 || m < 0 || m > 59 || s < 0 || s > 59) {
    strncpy(utcStr, "--:--:--", sizeof(utcStr));
    return;
  }
  snprintf(utcStr, sizeof(utcStr), "%02d:%02d:%02d", h, m, s);
}

void formatDateFromRmc(const char* field) {
  if (!field || strlen(field) < 6) {
    strncpy(dateStr, "--/--/--", sizeof(dateStr));
    return;
  }
  char dd[3] = {field[0], field[1], '\0'};
  char mm[3] = {field[2], field[3], '\0'};
  char yy[3] = {field[4], field[5], '\0'};
  snprintf(dateStr, sizeof(dateStr), "%s/%s/%s", dd, mm, yy);
}

void purgeConstellation(uint8_t sys) {
  int w = 0;
  for (int i = 0; i < rowCount; ++i) {
    if (rows[i].system != sys) {
      rows[w++] = rows[i];
    }
  }
  rowCount = w;
}

void clearSolutionFlags(uint8_t sys) {
  for (int i = 0; i < rowCount; ++i) {
    if (rows[i].system == sys) {
      rows[i].inSolution = false;
    }
  }
}

void markSolution(uint8_t sys, int prn) {
  if (prn <= 0 || prn > 255) {
    return;
  }
  for (int i = 0; i < rowCount; ++i) {
    if (rows[i].system == sys && rows[i].prn == (uint8_t)prn) {
      rows[i].inSolution = true;
      break;
    }
  }
}
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
