magikh0e/pueo/(commit log)

2026-10-03 docs/pueo/ui.md: the UI is TFT_eSPI called directly, and that was written down nowhere
    No LVGL, no widget library, no retained object tree, no invalidation and no
    event dispatch. 260 fillRect, 159 drawString, 151 drawFastHLine, 118
    drawBitmap, 34 drawCentreString. The decision appeared in no doc, no
    changelog entry and no comment above the drawing code, so the constraints it
    imposes existed only in the shape of the code and in the checks that
    compensate for them.
    Two numbers make the case and both are in the doc. One 320x480 framebuffer
    at 16 bpp is 307,200 bytes against 203,252 bytes of free DRAM, so a full
    framebuffer does not fit, let alone two; LVGL would run with partial-render
    buffers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
2026-10-03 check_prose.py reaches the site README, which had been invisible for four releases
    It globs docs/pueo/*.md, three files at the repo root, and the site tree
    smaller *.html. The site README was none of those: it was in this repo until
    the site became its own, and no glob followed it out. Ten dashes sat in it
    through four releases while the check reported green on everything it could
    see.
    site_dir() resolves PUEO_PUBLISH_DIR from .publish.local, which points at
    the published site/ subdirectory, so the repo root is its parent. Same skip
    behaviour as the pages: no .publish.local means the site is not on this
    machine, which is the case inside pueo-<version>-src.zip. Both halves
    verified by runnin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
    [check_prose.py]
2026-10-03 0.4.28: measured size
    Documentation and tooling. The firmware is 0.4.27's firmware: nothing in
    ESP32-DIV/ or PueoBeacon/ was touched, and the image differs by 70 bytes of
    1,867,776. Five of those are content, each the last digit of the version
    string, in the About byline, the About details title, the two WiGLE fields
    and the wardrive User-Agent. The other 65 are two digests, the app
    descriptor's SHA-256 of the ELF at app0+0xB0 and the SHA-256 and checksum
    appended to the image.
    1,796,485 bytes, 57% of the app partition. 124,428 bytes of RAM, 37%.
    Both images rebuild byte-identical from pueo-0.4.28-src.zip.
    98c293cf029a69c994c5f865f190762a513ee7d6e5c28700e31a66c46092006c pueo-0.4.28-merg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
2026-10-03 check_text_margins.py measured font 1 and assumed everything else was font 1 too
    Two faults, and the first was hiding the second.
    setTextFont's argument was resolved with int() behind a digit regex, so
    setTextFont(PUEO_BODY_FONT) gave None, and the caller then assumed font 1
    and measured at a flat 6 px per character. PUEO_BODY_FONT is 2:
    proportional, glyphs 3 to 10 px, averaging nearer 8. Nineteen call sites
    were measured about a quarter narrow, in the direction that passes a line
    which overruns. The font numbers come from shared.h now, so renumbering the
    constant cannot leave the check agreeing with an old value.
    Nothing overran. The one candidate was Hunt's age column, and the first
    att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
    [check_text_fits.py, check_text_margins.py, tft_fonts.py]
2026-10-03 the three readings at the top of the GPS screen were 1.23 mm
    gps.cpp draws at font 1 size 1 in eight functions, which is 8 px on a
    165 ppi panel. Most of that is correct and stays: the sky plot's satellite
    labels sit at the satellites' own coordinates, the legend strip and the
    footer hints are captions, and in the SNR table the bar is the information
    with a number beside it, the same argument shared.h already makes for the
    drone detector.
    The metric cards are the exception. UTC, DOP and FIX are three readouts
    across the top with no graphical form, and they are what the screen is for.
    The value in each goes to font 2. The label above it stays 8 px, because a
    caption is a caption.
    Sized from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
    [gps.cpp]
2026-10-03 15 KB of Classic BT RAM was held unless you opened a Bluetooth feature first
    Reported from a board: Wardrive showed "Startup failed. Could not start scan
    worker." That message has one source, xTaskCreatePinnedToCore failing to
    make the 10240 byte stack for wardfg, which fails when no contiguous block
    that size exists.
    The block was there, reserved. This firmware is NimBLE only and never
    initialises Classic BT, so the controller's RAM is dead weight, and
    esp_bt_controller_mem_release(ESP_BT_MODE_CLASSIC_BT) hands it back. That
    call lived in exactly one place: ensureBleStackReady(), in bluetooth.cpp.
    So it was released only if you happened to open a Bluetooth feature. Boot
    and go straight to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
    [ESP32-DIV.ino, bluetooth.cpp]
2026-10-03 Wardrive said WAIT forever with no GPS module fitted
    The GPS card showed a WAIT pill, "Sats 0 HDOP -1.0" and "No fix yet", and
    kept showing it. That is exactly what it shows for a module that is working
    and has not acquired yet, so the screen could not be read.
    GPS was deliberately left out of submenuHardwareNote() and that stands:
    there is no cheap probe, because the module answers by emitting NMEA when it
    is ready, and a brief look that found none would report "no GPS" for one
    still waking up. This is the other case. An app that has had the port open
    for seconds is not taking a snapshot, it is listening, and silence over time
    is evidence.
    What makes the test sound: a module that is prese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
    [gps.cpp]
2026-10-03 0.4.29: measured size
    1,797,045 bytes, 57% of the app partition. 124,436 bytes of RAM, 37%.
    Both images rebuild byte-identical from pueo-0.4.29-src.zip.
    d699eac20d7e9b6bd071b929da06c160ea68466fba70d24755e682b04dade1d0 pueo-0.4.29-merged.bin
    81c9a9f465d8dd9323249b1a81615a725f275290351a85cd7a2962d62489fac9 pueo-0.4.29-beacon-35-merged.bin
    61ebe5fb387e6f502a81dda44ce4dd480b2f8c891b371b0a088f066914ce32c8 pueo-0.4.29-src.zip
    check_text_margins.py said its font 1 gap closed at 0.4.28. It closes here,
    so that is a forward reference corrected rather than a version swept.
    51 checks pass.
    [Branding.h, check_text_margins.py]
2026-10-03 the About and boot bylines are assembled at run time
    Both build the string on first use rather than concatenating it at compile
    time. No behaviour change: all four display sites read what they read
    before, confirmed in the serial banner at boot.
    *.local.md joins .publish.local as machine-local and ignored.
2026-10-04 check_touch_targets.py spent a release measuring nothing and reporting ok
    All three of its patterns required a literal integer. The two button_x2
    assignments in the sketch are "x_position + TILE_W", button_y2 the same, and
    "yPos + <literal>" no longer appears at all, so it matched zero sites. Both
    its assertions are of the form "not bad_x", which is true of an empty list,
    so it printed "every row hit box spans the panel" and "2 checks passed"
    having examined nothing.
    It went vacuous because of the work it was written for. It exists because
    five list menus tested x <= 220 on a 320 px panel. Those lists became tile
    grids with a shared gridHit(), the literals went with them, and nothing said
    t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
    [check_touch_targets.py]
2026-10-04 two source trees shared one build directory, and a check said TypeError
    BUILD_PATH was keyed on the role alone, so every checkout built into
    $PUEO_ARDUINO_ROOT/build-$PUEO_ROLE. Verifying a release means extracting
    the published source to a second tree and building it, which overwrote
    whatever the working tree had built. It bit during the 0.4.27 cut: merge
    failed in the verify tree because compile had been run in the other one.
    Keyed on the tree now, by a hash of the resolved repo path, so trees cannot
    collide and each keeps its own incremental build across a verify.
    Not moved inside the repo, which was the other option. The deepest file
    arduino-cli writes is 139 characters against Windows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
    [check_grid_capacity.py]
2026-10-04 six checks were asserting their own transcription, and one proved it
    The seven the blanking audit could not reach do not read a sketch file at
    all. Six of them reimplement an algorithm in Python and test the
    reimplementation: the Find My parser, the EAPOL payload walk, the Fast Pair
    request and response, Spotter's address merging, the .sub parser and Hunt's
    follow heuristic. Only check_nmea_checksum reads the firmware.
    That is not a hypothesis. Dropping both locally-administered tests from
    Spotter's findOrAdd, which is the under-reporting bug check_spotter_merge's
    own docstring calls "the failure that matters here", left it printing
    "16 merge rules hold" and exiting 0.
    The project has met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
    [check_airtag_parse.py, check_eapol.py, check_fastpair_probe.py, check_spotter_merge.py, transcript_guard.py]
2026-10-04 a control byte in source is a shell-eaten escape, and now something says so
    Four times in one session a bash double-quoted string ate a backslash
    escape and left the byte it names in a file. \b becomes 0x08, a backspace,
    and nothing shows it: the editor draws nothing, the diff looks right, and
    git is content. Only cat -A or a byte-level search finds it.
    Three were harmless. The fourth was not, and is why this exists.
    check_sig_counts.py and check_stealth.py each had one inside the stale-count
    half of their check, where a word boundary was meant. Both checks assert two
    things, that the site states the current count and that it no longer states
    an older one, and the second could never fire, b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
    [check_control_bytes.py]
2026-10-04 the silent GPS path is confirmed on hardware, the threshold is not
    With no module fitted, the Satellites screen shows "no GPS" and Wardrive s
    GPS card shows the NONE pill with "No data on GPIO 1. Check GPS wiring."
    Those are separate code paths sharing only gpsLinkState: Wardrive has its
    own pill, its own text row and its own repaint condition through
    WardMainSnap, so that is two results rather than the same one twice.
    Before 0.4.29 the Satellites corner stayed blank with no module, because the
    staleness test was guarded by lastGsvMs != 0 and could only fire for a
    module that had already spoken. That was the one state it could not report.
    The 5000 is not confirmed by any of it, and the com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
2026-10-05 the enclosure sources come out of the repository
    make_release.sh has stripped .scad from the archive since it was written,
    and its comment said the files "stay in the repository, where they are
    edited, and go no further". That was true of archives and not of the
    repository: this one is public, so sitting in docs/pueo was publication.
    The half of the decision that was being enforced was not the half that
    mattered.
    Untracked and ignored now. They stay on disk and stay editable. The
    assertion in make_release.sh stays as well, because docs/pueo still ships
    wholesale and a .scad that reappears there must still not ride along.
    The website drops the printable models in the same change: eight STLs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
    [nrf24-fit-test.scad, pueo-enclosure.scad]
2026-10-05 FUNDING.yml: a slot for GitHub Sponsors, left closed
    GitHub Sponsors takes no platform cut and sits on the repository rather
    than sending somebody off it, so it belongs in this file. The line is here
    and commented out, because the listing does not exist yet: hasSponsorsListing
    is false for the account and /sponsors/magikh0e redirects to the profile.
    Live, it would put "GitHub" in the Sponsor dropdown pointing at a page that
    cannot take a payment. That is the ambiguity this file already removed once,
    in a worse form, since there is nothing on the other side of the toss.
    The comment says what to do to open it. Nothing else changes when it opens.
    Also drops a double hyphen from the existing n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
2026-10-05 issue templates
    Two forms, and four contact links that send three common arrivals somewhere
    better than an issue.
    The bug form asks the questions whose answers are always needed and rarely
    offered: the version, where the build came from, the board, which sector,
    which modules are fitted, and whether Stealth was on. That last one is on the
    form because the twenty features that transmit refuse to start under Stealth
    by design, so "it will not start" is more often that than a fault, and asking
    up front saves a round trip. It also notes that the GPS screen closes the
    serial console, so a GPS report with no serial output is expected rather than
    a reporter who did not bother.
    The feature form sa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
2026-10-05 SpotterSignatures: drop the catalogue acknowledgement
    Three places, and two of them carried reasoning that had to survive the
    removal. A comment saying a row is Weak because somebody else noted the name
    was the stronger signal still has to say the row is Weak because the name is
    the stronger signal, or the next person to read it finds an unexplained grade
    and changes it.
    The header block is replaced rather than deleted. What it was carrying under
    the acknowledgement was the scope rule, that a handheld action camera is a
    camera and not surveillance, and that rule decides what goes in this file. It
    stays, on its own terms.
    Comments only. No row moved: 580 OUI assertions, the nine table count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
    [SpotterSignatures.h]
2026-10-05 0.4.35
    Nothing reaches the device. The only file under ESP32-DIV/ is
    SpotterSignatures.h and its diff is comments: no row moved, no grade changed,
    no table resized. The image is 0.4.34 apart from the version string, and the
    build confirms it, 1,797,165 bytes and 124,452 of RAM, the same figures,
    because the version string is the same length and nothing else moved.
    What is in it: the enclosure sources out of the repository, the signature
    list published separately with a writeup on the confidence levels, issue
    templates on both repositories, and the check count corrected.
    That last one is worth stating plainly. This file said 53 at 0.4.33 and
    0.4.34 and the website said 42. There were 50 the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
    [Branding.h]
2026-10-06 Zigbee coordinators, by the hub that runs them
    Nothing on this board can hear Zigbee. It is 802.15.4, O-QPSK with direct
    sequence spreading, and no radio here demodulates it: the ESP32 has no
    802.15.4 at all, the CC1101 is sub-GHz, and the nRF24 is GFSK in the right
    band and the wrong shape. That does not change.
    The hub is a different matter. Every one of these also carries WiFi or BLE and
    announces itself there, so a Zigbee network is findable by the thing running
    it even though its traffic is not. Eight blocks: Philips and Signify for Hue,
    SmartThings, Lumi for the Aqara gateways, and IKEA.
    Kind::Mesh, which already means a mesh radio node rather than surveillance
    gear and was carrying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
    [SpotterSignatures.h, check_sig_counts.py]
2026-10-06 the channel analyser names what sits on the peak
    It said "peak Ch50" and left the reader to know that RF_CH 50 is 2450 MHz and
    that Zigbee 20 lives there. It now says "peak Ch50 2450 Zb20/W9".
    What it does not say is which of them is transmitting. The nRF24 reports
    energy through its RPD and nothing else: it cannot tell a Zigbee frame from a
    WiFi one, and at 2.4 GHz they sit on top of each other. So both names are
    printed when both apply, because printing one would be a guess dressed as a
    reading.
    Within two megahertz of a centre counts, which is the width of a Zigbee
    carrier against a one megahertz receiver: energy a channel off centre is the
    same signal seen from its shoulder.
    check_ban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
2026-10-06 S7V8F3 pin order, confirmed on the part
    VOUT GND VIN SHDN, in a row at 0.1 inch, read off the part rather than a
    listing.
    The note gave the same four names in the other direction and no reference
    edge, which is the same sequence read from the other end. Both sentences are
    true of the same part and only one of them matches a given footprint. That
    ambiguity is free to carry in prose and expensive on a board, where it lands
    VIN on the VOUT pad, so the note now points at the silkscreen and says the
    board is its own authority.
    The three-pad footprint for a four-pin part still wants fixing before fab.
    That is unchanged and now has a confirmed order to be fixed against.
2026-10-06 SHDN is active low, and 3.0 is a rounding rather than a datum
    The pin is printed with an overbar. The note already said the board runs with
    SHDN tied to VIN or left disconnected, which is only true because the pin is
    active low and pulled up: it had the conclusion without the reason, so
    anybody reaching for the idea below had to rediscover the polarity to use it
    safely.
    What that changes is the choice of pin, if the RF rail ever gets switched in
    software. Active low means the rail is off while the pin is held down, so a
    strapping pin or anything else sitting low out of reset keeps the radios dark
    until firmware raises it, and a dip during a reset drops the rail
    mid-operation. A pin that com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
2026-10-06 SHDN gets its pad, as a test point
    The footprint had three pads for a four pin part. Tying SHDN to VIN is the
    obvious fix, Pololu allow it, and it is the wrong one: the note beside it says
    the pad is the whole provision for ever switching the RF rail in software, and
    a trace to VIN turns that provision into a scalpel job.
    A pad on its own was what was wanted and the generator would not have it:
    every net needs two endpoints or it is not a net, which is a good rule and not
    one to weaken here. The board already answers that twice, TP1 on +5V_IN and
    TP2 on +3V3_RF, so SHDN gets TP3. Four pads, a legal net, the pin still
    floating and therefore the converter still running, and a place to land a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
    [check_netlist_counts.py, gen_netlist.py]
2026-10-06 check the signature breakdown, not only the total
    check_sig_counts.py asserts the pages say 274. They did, while the
    surveillance page listed eight tables under a sentence promising nine, with
    BLE advertised name missing and the OUI row frozen at 118 against a table of
    126. The total was right because the two errors cancelled: a table vanished
    and another was undercounted by what it had grown.
    A sum cannot catch that, so this reads the breakdown. Every table a page
    names has to carry the row count the header has, by k-name on
    signatures.html and by English label on surveillance.html. A page that says
    nine tables has to list nine, which is the assertion the old check could
    never make. And th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
    [check_sig_tables.py]
2026-10-06 0.4.36: Stealth Mode was not receive only
    Web OTA transmitted through it, which is the one thing the switch exists to
    prevent. System, Firmware Update, Web OTA scanned for a network, joined one
    and served HTTP over it, with the setting reading ON and the screen
    promising silence.
    The scan was the quieter half and the worse one. selectWiFiNetwork() called
    WiFi.scanNetworks() with no arguments, and that form defaults passive to
    false, so a probe request carrying this device's address went out on every
    channel before anything was joined. Somebody checking the radio was quiet
    would have seen a network picker, not a transmitter.
    Both halves are closed. performWebOTAUpdate() refuses at the top a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
    [Branding.h, check_stealth.py, wifi.cpp]
2026-10-06 read captures with the EAPOL parser, not only frames this repo wrote
    Everything check_eapol.py tested, it also built. That is the weakness the
    file could not see: a header layout nobody thought of is missing from the
    parser and missing from the test for the same reason, because one hand
    chose the question and the answer.
    So the last pass reads a classic pcap, strips the radiotap header Pueo
    writes, and runs the transcribed findPayload and classify over every frame.
    Link type 105 or 127, fifty lines, no pcapng, because editcap converts.
    tools/fixtures/manifest.json declares what each capture should yield and
    every entry has to name a source and a licence. A fixture swapped for one
    that does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
    [check_eapol.py]
2026-10-06 a capture in the fixtures, with the street taken out of it
    658 frames off a real radio, through Packet Monitor on 0.4.36. No handshake
    in it, which turns out to be the fixture worth having first: it is the case
    that cannot be synthesised honestly. Real traffic, malformed frames
    included, read without a single out-of-bounds access, reporting no EAPOL at
    all and refusing 109 encrypted data frames on the way. A false positive
    there would be a row on the screen claiming a handshake nobody transmitted,
    and nothing until now could have caught one.
    The capture has no handshake because Packet Monitor hops while it is
    listening to everything, and a four-way exchange is over in tens of
    milliseconds.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
    [anonymise_capture.py, check_eapol.py]
2026-10-06 a trimmer, so a fixture is the frames that matter and not the afternoon
    A fixture is read on every release, and a capture of a few minutes is
    mostly weight. editcap does this and is not installed here, so this does
    the one thing needed and nothing else: keep the frames carrying an 802.1X
    payload, found the way Eapol.cpp finds them rather than at a fixed offset,
    plus a given number either side.
    The frames either side are the point. A handshake with nothing around it
    tests the parser. A handshake in the traffic it arrived in tests the parser
    where it runs, next to the beacons and the association it belongs to.
    Records are copied with their timestamps and never rewritten, so this runs
    before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
    [trim_capture.py]
2026-10-06 0.4.37: Packet Monitor reported handshakes it had thrown away
    Measured on the board: the tracker counted the key frames and the file it
    was writing held none of them.
    A capture slot is taken in the promiscuous callback, filled, and handed to a
    drain that writes it to the card and returns the slot. That drain runs in
    ptmLoop, a dozen records a pass, behind delay(10) and a screen redraw, so
    capture throughput is paced by the display refresh. A four-way handshake is
    four frames inside a few milliseconds, arriving while the channel is busiest
    with the association that caused them, and the frames that matter are the
    ones that do not fit.
    The first attempt raised the pool from three slots to six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
    [Branding.h, anonymise_capture.py, check_pcap_pool.py, shared.h, wifi.cpp]
2026-10-06 the satellite panel draws without a sprite, rather than an error card
    When no sprite allocates, the Satellite Scanner printed "Display buffer
    failed" with the largest free block and the size one needed, and stopped.
    The screen was unusable on low memory.
    It renders straight to the panel area now. renderPanelGx is a template over
    its draw target and works on the TFT as well as on a sprite; a viewport is
    what makes that true without touching the renderer, because TFT_eSPI reports
    the viewport from width() and height() and offsets every coordinate into it,
    so the panel-relative Y values land below the status bar and fillScreen clips
    to the panel instead of wiping the bar.
    From cifertech/ESP32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
    [check_screen_dims.py, gps.cpp]
2026-10-06 0.4.39: the Satellite Scanner draws without a sprite
    When no sprite allocated, the panel printed "Display buffer failed" with the
    largest free block and the size one needed, and stopped. The screen was
    unusable on low memory.
    to the panel instead of wiping the bar. The 800 ms retry above it still runs,
    so the scree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
    [Branding.h]
2026-10-06 a second handshake fixture: the clean case, with nothing to disambiguate
    ptm-eapol-handshake-qos.pcap has retransmissions, two M1 and two M3, which
    is what makes it worth having: a parser that counts EAPOL frames instead of
    classifying them passes a four-frame count and gets the wrong answer. This
    one is the other shape. Exactly one of each message, no retries, so M1 M2
    M3 M4 and nothing to tell apart.
    The pair is the point. One of them catches a counter, the other catches a
    classifier that only works when the messages happen to be distinct, and a
    fixture that only ever shows one shape cannot do both.
    Off 0.4.39, from a capture where the general pool dropped 1,387 of 4,268
    frames, 32 per c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
2026-10-06 0.4.40: a second handshake fixture, and nothing that reaches the device
    No file under ESP32-DIV/ changed. The image is 0.4.39's apart from the
    version string: 73 bytes differ, being "39" to "40" at four sites and the two
    embedded digests that change as a consequence.
    tools/fixtures/ptm-eapol-handshake-once.pcap, 45 frames, exactly one of each
    message and no retransmission. The fixture beside it has two M1 and two M3,
    which is what makes it worth keeping, because a parser that counts EAPOL
    frames rather than classifying them passes a four-frame count and gets the
    wrong answer. This is the other shape. One catches a counter, the other
    catches a classifier that only works when the messages hap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
    [Branding.h]
2026-10-06 split saveProfile, so an import can store a record without the screen
    It did three jobs: read the capture out of globals, decide where it goes in
    EEPROM and what to do when there is no room, and draw the outcome. An import
    needs the middle one and neither of the others, and there was no way to
    reach it.
    Now makeRoomForProfile exports and clears when EEPROM is full and is the
    only step that can fail, storeProfile writes to the next slot and can assume
    room because the caller just made it, and makeProfile builds a record from
    five values. saveProfile does what is left: calls the first, prompts, calls
    the second, and draws.
    Two seams rather than one, and the reason is the order. The first att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
    [check_profile_record.py, subghz.cpp]
2026-10-06 read a Flipper .sub in: the screen the reader was waiting for
    SubFile could parse a .sub from the day it was written, with 60,891
    assertions behind it, and nothing called it. The blockers were the two
    things just fixed: a profile record declared three times, so an import had
    no single type to write through, and a saveProfile that could not store
    anything without also prompting and drawing.
    SubGHz > Import .sub lists the .sub files in /pueo/subghz, and the right
    button imports the selected one. Parse, then makeRoomForProfile, then
    storeProfile, in that order, so the steps that can fail happen before
    anything is written.
    No Stealth gate, because there is nothing to gate. It touches no radio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
    [ESP32-DIV.ino, config.h, subconfig.h, subghz.cpp]
2026-10-06 no submenu writes down which entry is Back
    Adding Import .sub to SubGHz broke two things at once, and both came from
    one constant. The handler compared current_submenu_index against the literal
    5, which was Back until the new entry took that index. Back moved to 6, so:
    choosing Import went to the main menu, because it took the branch meant
    for Back;
    choosing Back did nothing at all, because it fell through to a switch with
    no case for 6 and hit default.
    It compiled, and every check passed, including the one that exists to catch
    menu tables disagreeing. The tables were fine. The index was written down in
    a third place that nothing checked.
    Both SubGHz branches derive it now. So do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
    [ESP32-DIV.ino, check_menu_tables.py]
2026-10-06 the import makes its directory rather than complaining about it
    /pueo/subghz only exists once a profile has been exported, so on a card that
    has never done that the screen said "No /pueo/subghz" and, underneath,
    "put files in /pueo/subghz": an instruction naming a folder that was not
    there to put anything in.
    sdEnsureDir creates it, parents included. The remaining failure is a
    directory that exists and will not open, which is a different thing and says
    so.
    Found by running it. The first test reported no .sub files and I read that
    as the directory having opened, which it had not.
    [subghz.cpp]
2026-10-06 the import screen reads the touch bar, which is the only input this board has
    Next, Prev and Import did nothing. They were wired to
    isPhysicalButtonPressed, and the PCF8574 is disabled here, so that function
    is a constant false. Exit still worked, which is what made it look like the
    screen was alive: Exit goes through featureExitButtonPressed, which falls
    through to the touch bar, and nothing else did.
    There is a handleNavButtons now, edge-triggered with a release wait, the way
    Saved Profile does it. A level read would repeat for as long as a finger
    rests on the bar.
    An assertion in check_button_waits.py, which already owns how buttons are
    read: a namespace that reads physical buttons must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
2026-10-06 gate the send, not the screen
    Saved Profile refused to open without a CC1101, and under Stealth Mode. It
    lists records off the card, shows one and deletes one, and only Send drives
    the radio, so a profile imported from a .sub could not be read back on a
    board with no module fitted. That is how this was found.
    Both refusals move into transmitProfile(). Stealth::refuseAction() and
    cc1101ReadyForAction() are the existing refusals without the leaving, so
    declining to transmit returns to the list rather than closing it. The radio
    is brought up at setup only when it is both fitted and allowed, instead of
    sitting in RX for a screen that is going to read the card.
    The Stealth panel also said "Save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
2026-10-06 read the stored profile table off the card
    storeProfile() syncs the whole EEPROM table to
    /pueo/subghz/profiles_current.bin after every write, so the card holds the
    device's own view of what it stored. This decodes it against the 28-byte
    record layout and against the frequency and bit bounds in SubFile.cpp, which
    means a record outside them could not have come from a .sub the parser
    accepted.
    Written because Saved Profile would not open without a radio, and an
    imported profile that cannot be read back is not a verified import. The
    screen can do it now, and this still answers the same question without the
    device, which is the part worth keeping.
2026-10-06 protocol 0 is an absence, not a number, and a rolling code says so
    Two things that were silently wrong about protocols coming out of a .sub.
    An unmapped protocol parsed Ok with protocol 0, the import stored it with
    no comment, the browser printed a bare "0", and rc-switch's setProtocol()
    clamps anything below 1 up to 1. So importing a CAME file and pressing Send
    transmitted Princeton timing under CAME's name, did nothing, and said
    nothing about why. The table is not widened, because the existing comment is
    right that guessing timings produces a profile that transmits something
    subtly wrong. Instead protocol 0 is now loud in all three places: the import
    names the protocol it cannot send, the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
    [SubFile.cpp, SubFile.h, check_sub_parse.py, subghz.cpp]
2026-10-06 export .sub, and a frequency analyser
    Export .sub is the other direction of the import. A capture otherwise
    leaves this device only as a packed binary nothing else reads, and the
    five-slot EEPROM rotation pushes older ones into that format as new ones
    arrive, so a profile was effectively trapped here. SubFile::write renders a
    key file and the screen writes one per profile to /pueo/subghz.
    TE is omitted rather than invented: the EEPROM budget is exactly full at
    five 28-byte records, so there is nowhere to store one, and a reader that
    needs TE is better off applying its own default than a guess from here. A
    profile with protocol 0 cannot be written at all, because the record never
    stored the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
2026-10-06 refuse an unsendable profile before asking for a radio
    The send checked for a CC1101 first and the protocol mapping second, so a
    profile imported from a .sub whose protocol this firmware will not name
    answered "fit a CC1101" to a request no radio could satisfy. Fitting one
    would have produced the real refusal a step later.
    It also put the only refusal on this path that needs no hardware behind the
    one that does, which made it untestable on a board with no module.
    Ordered cheapest and truest first now: the profile cannot be sent at all,
    then Stealth, which is a decision already made, then whether the part is on
    the end of the bus. check_sub_parse.py asserts the two orderings and that
    both r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
2026-10-06 two pin numbers in pcb-design.md still described the 14-way J1
    The J1 table and gen_netlist.py both have grounds on 1, 5 and 9 and GPS_TX
    on J3 pin 2. The prose under the table named pins 13 and 14 on a connector
    that has nine, which is where it was left when the 14-way became a 9-way
    plus two 4-ways. Somebody crimping from that page puts a ground on the
    wrong contact and the series resistor in the wrong cable.
2026-10-06 the 1.25 mm connector is GH, and the docs said the opposite
    hardware.md established the pitch well: P1 carries the vendor's own "4P
    1.25" silkscreen and an independent photogrammetric check of CN1 agreed. It
    then named the series from that and told people in bold to buy MX1.25 or
    PicoBlade and specifically not GH. Pitch does not determine series. GH and
    PicoBlade are both 1.25 mm and do not mate, GH latching on the side and
    PicoBlade on top, and no housing had ever been seated.
    Settled by fit on 2026-10-06, which is the only way it can be settled: a
    PicoBlade housing offered to the header does not seat, with the pitch
    correct. An order was placed against the old advice first.
    Four places,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
    [gen_netlist.py]
2026-10-07 the analyser derives its row height, and the list has eighteen entries
    Two things the mockup found that reading the code did not.
    kRowH was 13, the smallest height the text fits in. Eighteen rows at 13 is
    234 px on a 450 px content area, so the screen drew in its top half and left
    the bottom black with the footer stranded at the panel edge naming a row 200
    px above it. It is derived now, from the space and the number of rows,
    clamped so a short list does not spread into bars with acres between them,
    and the footer sits under the last row. Everything in a row is placed from
    the bar's y, so the height can be anything and the line stays a line.
    And the list has eighteen entries, not twelve. T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
    [render_screens.py, subghz.cpp]
2026-10-07 a waterfall for the 2.4 GHz scanner
    The spectrum plot answers "where is there energy now". It cannot answer
    "what kind of thing is that", because what distinguishes the things in this
    band is how they move: BLE advertising sits on three fixed channels, WiFi
    is a steady 20 MHz block, a proprietary hopper walks. A snapshot shows none
    of that and thirty seconds of history shows all of it.
    Three decisions worth stating.
    Time on X, channel on Y. The obvious layout is the other way up, time
    scrolling down, and it is wrong here: scrolling needs a framebuffer to
    shift or a readback the panel does not offer. Advancing a column costs one
    vertical line of writes per sweep and needs neither.
    No histo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
    [bluetooth.cpp, render_screens.py]
2026-10-07 the site menu check compares against the tag the page names
    The page says "every entry in the menus, as of 0.4.43", which is a claim
    about a released image. The check read the tables out of the working tree,
    which is ahead of the release by design, so it was comparing the page
    against code nobody can download and could not tell that from the one case
    where it matters.
    It reads the tables out of the tag now, falling back to the tree when the
    tag does not exist yet, which is the state during a release, and when there
    is no repository at all, which is the state inside the source archive. Both
    fallbacks say so, because the check is weaker in those runs than it looks.
    That was necessary and not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
2026-10-07 the module says ESP-WROOM-32 and its FCC ID says ESP-32S
    The castellation count in the build guide rests on "the module is the usual
    WROOM-32". Off the shield that holds. The line underneath it does not: the
    board in hand reads FCC ID: 2BCLP-ESP-32S, which is a third-party module on
    the same 38-pin footprint rather than Espressif's own part.
    Nothing changes as a result, and that is the point of writing it down. The
    footprint is shared, so the counting is unaffected and the board has been
    running all day. What it changes is where somebody checking their own module
    should look, because searching that FCC ID lands on a different filing and
    holding the shield's name against an Espressif datashe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
2026-10-07 fourteen and ten is the same module as fifteen and eight
    Counted on the board in hand: fourteen down each long edge, ten across the
    bottom. The guide says fifteen and eight. Both are thirty-eight, both are
    describing the same castellations, and they disagree only about who owns the
    two bottom corners. This guide counts a corner as the last of its long edge,
    which is Espressif's numbering; counting it as the end of the bottom row
    gives fourteen and ten.
    Worth writing down because of what somebody does with the discrepancy rather
    than because of the discrepancy. A builder who counts fourteen, reads
    fifteen and concludes the table is wrong will renumber from scratch, on the
    one page where renu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
2026-10-07 say which microSD contact each bus pad should beep to
    Step 3 told you to identify 9R, 2R and 8R "by beeping it against the
    matching microSD slot pin" and never said which pin matched which. That is
    the one fact the instruction needs: without it the step collapses back into
    counting castellations, which is the thing it exists to avoid.
    The card shares all three nets, so the slot is the only place on this board
    where SCK, MOSI and MISO are exposed and visible. 2R is CMD, 9R is CLK, 8R
    is DAT0, contacts 3, 5 and 7 of the eight.
    Written as sweep-and-observe rather than predict-and-confirm, because
    counting contacts in a socket is the same class of error as counting pads on
    a module. Probe the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
2026-10-07 2R, 9R and 8R beeped out: contacts 3, 5 and 7
    Measured 2026-10-06, board unpowered, by sweeping the card slot from each
    pad rather than looking for a contact and confirming it. All three answered
    where the table says and nowhere else, none answered to another of the three,
    and none answered to the shell.
    That is wider than three pads. It means counting down the right edge with the
    antenna up lands on IO23 at two, IO19 at eight and IO18 at nine, so the
    counting convention is right, which is what the fourteen against fifteen
    question was actually about. It also puts the module on the footprint this
    guide assumes, whatever the shield and the FCC ID disagree about.
    First time anything in the p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
2026-10-07 the pad diagram stops claiming 15 a side is what you see
    Its subtitle read "turn the board until the antenna points up and this is
    what you see. 15 pads a side, 8 across the bottom." Counted on the board it
    is 14 and 10. Both describe the same 38 pads and differ only over who owns
    the two bottom corners, which the build guide explains and the drawing did
    not, and the drawing is the worse place for the omission because it is the
    one asserting that this is what you see.
    The numbering stays 1 to 15 down the edge and 16 to 19 along the bottom.
    That is Espressif's, and 2, 8 and 9 under it were beeped out against the card
    slot and landed on CMD, CLK and DAT0, so it is the convention with evidence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
2026-10-07 the pad drawing numbers to 14 and names the rest
    The subtitle was corrected twice and the numbers never were, so the drawing
    still counted fifteen down each side while the board reads fourteen. A
    drawing captioned "this is what you see" does not get to answer a count with
    a convention, and the reader found it on the page after I had twice said it
    was fixed.
    One to fourteen is identical under either attribution of the corners and
    holds every pad anyone solders to, so those numbers stay and nothing
    referencing 2R, 8R, 9R, 10L, 11R or 12R moves. Past fourteen the number is
    the contested part and the pad is one nobody should touch, three of the four
    being the module's own flash, so the drawing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
    [check_solder_pads.py]
2026-10-07 the drawing draws 14 a side and 10 across, rather than relabelling one
    Relabelling the fifteenth square was not the fix. The drawing still had
    fifteen rectangles down each edge, so it still showed fifteen pads a side,
    and the new labels invented two pins: there is nothing on this module called
    "cnr" or "corner".
    The corner pads move into the bottom row, which is where they are counted.
    Each side column loses its lowest rectangle, the bottom row gains one at
    each end, and the right corner keeps its real name, IO2, as a bottom label.
    Nothing is renamed and nothing is invented; two squares move.
    The numbers still stop at fourteen. One to fourteen is identical under
    either convention and holds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
    [check_solder_pads.py]
2026-10-07 the scanner sentence was wrong twice and flattering both times
    "Fifty passes each, against a calibrated noise floor" and "better
    measurement than most of what is published for this part".
    Fifty is scan() and calibrateBackgroundNoise, the one-shot Scan and Cal
    buttons. The continuous view the bars and the waterfall draw from is
    display(), and DISPLAY_SWEEPS is ten.
    The noise floor is worse than wrong. calibrateBackgroundNoise fills
    backgroundNoise[], and the only code that reads it back is the loop finding
    the largest entry to name a channel in the "Calibrate done" message.
    Nothing subtracts it from anything. The button measures a floor, reports
    where the worst of it is, and discards it.
    S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
2026-10-08 Cal measures a noise floor and the scanner subtracts it
    calibrateBackgroundNoise swept the band, filled backgroundNoise[] and
    printed the worst channel, and the only code that ever read that array back
    was the loop finding the largest entry for the message. Nothing subtracted
    it, so the scanner drew the same bars before and after a calibration.
    The measurement was wrong three ways as well, none of which mattered while
    the result was unused. channel[] was never cleared, so a calibration
    started from whatever the last Scan left and its second round counted the
    first again: 2*round1 + round2. backgroundNoise[] was never cleared, so
    pressing Cal twice stored twice the floor. Then /= 5 against a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
    [Branding.h, bluetooth.cpp]
2026-10-08 a reset that removes Pueo's own directories
    SYSTEM > Reset SD removes /pueo and nothing else: captures, logs, sub-GHz
    profiles, ESB dumps, ducky scripts, the captive portal files, the SSID list
    and the settings, which is the whole of what this firmware writes. The card
    itself is never touched and there is no option to touch it, because a
    handheld with a "format the card" button is a way to lose somebody's
    photographs.
    The screen counts before it arms, so the question is "24 files, 2.1 MB,
    including your settings" rather than "are you sure", and it says that
    /pueo/config holds the settings so a wipe reverting brightness and theme is
    not a surprise found afterwards. Wipe arms on one press and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
    [Branding.h, ESP32-DIV.ino, check_fft_scratch.py, check_nav_labels.py, check_sd_paths.py, check_sd_reset.py, shared.h, subghz.cpp]
2026-10-08 the two new checks go in the archive
    The include list is an explicit record of what belongs to this fork rather
    than an exclude list, so a new file is invisible to the archive until it is
    named. The cut refuses instead of quietly shipping without them, which is
    how it should go: check_sd_reset.py is the only thing asserting that the
    wipe cannot reach outside PUEO_DIR, and an archive that builds the feature
    without carrying its test is worse than one that fails to build.
2026-10-08 four rows named the wrong kind of thing, and nine blocks were missing
    Found by diffing this table against RF Sentinel (CIS-C0/RFSentinel, GPL-3.0,
    an Android app doing Spotter's job on a phone), then checking every disputed
    prefix in the IEEE registry rather than taking either list's word for it.
    ShotSpotter is not a plate reader. D4:11:D6 is registered to ShotSpotter, so
    the vendor and the Strong were right, but the company makes acoustic gunshot
    detection and Kind::Alpr told whoever was standing under a microphone array
    that their number plate was being read. Flock's Raven is the same device from
    a different vendor and was in the same wrong place. Seven rows, and no
    existing kind fitted e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
    [Spotter.cpp, SpotterSignatures.h, check_oui_registry.py, check_sig_counts.py, check_signatures_export.py, check_spotter_oui.py, extract_signatures.py]
2026-10-08 logo: medium edge feather — dissolve the background without clipping the banners
2026-10-08 the beacon says its version over serial
    It printed it onto the panel and nowhere else, so the only way to know what
    a beacon was running was to look at it: over USB it said "[beacon] start"
    and nothing more, and a board flashed weeks ago read the same as one
    flashed a minute ago.
    That bit today. The beacon and the detector both enumerate as a CH340 on
    COM4, so the port does not say which is attached and the banner is what
    settles it; the banner identified the board and then could not say whether
    it was current.
    The detector has always printed its version. The reasoning applies harder
    here, because this board's job is to be the known-good half of a bench
    pair, and a bench pair is only known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
2026-10-09 the bench build gets a parts list, and two wrong instructions go
    Reported from a read-through, and three of the five were not missing
    knowledge but knowledge in the wrong document. The brownout remedy, the
    supply table and the soldering technique were all written down in
    pcb-design.md or build-guide.md, and somebody at a bench with a hot iron is
    reading neither.
    Two instructions were simply wrong, and both were found by someone
    restating the numbered steps back, which reproduced them faithfully. That
    is what a build guide being wrong looks like from outside.
    Step 5 said "CSN and CE to the RGB LED pads". Only CE is. The paragraph
    directly above it spends a page explaining that GPIO 4 is the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
2026-10-09 one shape for every stage
    They were five essays. Each said the right things in its own order, so
    finding what to actually do meant reading a page of reasoning first, and
    finding how to know it worked meant reading to the end.
    They share a skeleton now: why the stage exists, what to do, what proves
    it, and what to suspect when it does not. The reasoning is kept and moved
    under the step it explains rather than ahead of it, because the reasoning
    is the part that stops somebody doing the wrong thing twice.
    A table above them carries the sequence, what each stage costs in tools and
    what it proves, which are the questions asked before starting rather than
    during.
2026-10-09 the same wrong assumption, in four more places
    One belief, repeated: that the three repurposed pads are the three RGB LED
    channels. They are not. GPIO 4 is the red channel and is used by nothing;
    CSN moved to 25 when that was measured on 2026-09-23, and 25 was free
    rather than taken from anything.
    build-guide.md "GPIO 4, 16 and 17 are the NRF24's and the PN532's now".
    GPIO 4 belongs to nothing, and check_pinmap.py prints no
    row for it. The paragraph two sentences below is the
    measurement that says so.
    pcb-design.md "The RGB LED gave up its three pins and UART0 gave up a
    fourth", used as the premise of an argumen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
2026-10-09 the mechanical section described a case that no longer exists
    Checking the MT3608 rows turned out to be worth it, though not in the way
    expected. They are not stale in the parts tables: the two-module path is
    recorded there deliberately, and the module's measured 6.0 mm height is
    worth keeping so nobody measures it again.
    The floorplan was another matter. "Module positions are already fixed by
    the enclosure" listed the MT3608, the TP4056 and the MP2307 at positions
    from the 85 x 170 case, with no row for the part actually chosen. The case
    is 84 x 142 and has been since those three left the design: six modules on
    the centreline, every y about 14 mm from where this file put it, and the
    conver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
2026-10-09 the S7V8 silkscreen names the family and not the output voltage
    The back of the part in hand reads reg09b, 0J7031, the Pololu logo and
    2012. Those markings belong to the whole S7V8 family: the adjustable
    S7V8A, the S7V8F3 at 3.3 V and the S7V8F5 at 5 V all carry them. They
    do rule out the S7V7F5, which is reg09a and 0J3933 and a different
    size, so they confirm the 11.4 x 16.5 footprint the mechanical section
    is dimensioned against.
    What they do not do is say which output. No trimmer on the component
    side rules out the S7V8A, which leaves F3 against F5 with nothing on
    the board to separate them, and a 5 V part on +3V3_RF feeds three
    radios rated 3.3.
    The check already exists. Stage 0 of the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
2026-10-09 the guide's copy of the card format, which was one word
    "FAT32, inserted in the slot in the side of the lid" is true and was
    the whole of it, tucked inside a sentence about where the slot is. The
    reader who needs that sentence is the one whose card does not mount,
    and for them the useful half is not FAT32. It is that exFAT does not
    work and that their card is almost certainly exFAT.
    So the two paragraphs the bench build gained, in this document's voice
    and without the stage framing, because the guide is read by somebody
    holding a finished device rather than building one. Same evidence, and
    it is from the core rather than from anyone's prose:
    2.0.10/tools/sdk/esp32/include/fatfs/src/ffc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
2026-10-10 a boot splash: the grid, the spectrum, and the log falling out of the owl
    Replaces the skull animation and displayLogo() at startup. The shape is
    borrowed from Sprout, a desk-companion sketch for this same panel: a
    perspective grid running to a horizon, CRT scanlines, nothing stored as
    frames. What is this project's is the content. The trace on the horizon
    is a spectrum, and the text falling out from under the mark is the
    firmware's own [boot] lines, fading as they drop and gone before they
    reach the trace.
    It steps a line at a time rather than scrolling by pixels. A pixel
    scroll means clearing and redrawing the whole log band every frame; the
    band is 320 x 110, about 35 kpx, which is rough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
    [Branding.h, ESP32-DIV.ino, render_screens.py, utils.cpp, utils.h]
2026-10-10 the splash showed a boot line the firmware never prints
    Caught by reading the board's serial before flashing it rather than
    after. What it actually prints is five lines:
    [boot] start
    [boot] classic BT RAM released, heap 149212 -> 164180
    [boot] settings: loaded from SD
    [boot] BLE/WiFi-bg deferred (v1)
    [boot] ready
    The splash had six, and the sixth was "[boot] SD mounted, /pueo ok",
    which exists nowhere in the tree. I wrote it to fill the space, which
    is the one thing a log on a boot screen must not be: a boot log that
    includes a line the firmware cannot emit is worse than no boot log,
    because it is the screen a reader trusts to tell them where it got to.
    Five lines now,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
2026-10-11 the SD icon could not say no
    SD_CD is defined only for BOARD_ESP32_DIV_V2. On this board and the V1 the
    other branch of updateSdCardStatus() resolved to a bare `true`, so
    sdCardPresent latched true on the first call at boot and could never
    change: the bar drew the green card icon with an empty slot, "SD Card
    detected" printed every boot, and bitmap_icon_nullsdcard was unreachable.
    The user guide pointed at that icon as the thing to check before starting
    anything that captures, which is the one job it could not do.
    It follows the filesystem mount now. Without a detect pin the honest claim
    is "a card has been read" rather than "a card is present", and
    settingsLoad() mounts in setup(), so a f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
2026-10-17 the connector advice names the check, not the label
    The docs told readers not to buy "MX1.25". That came from one fit test on
    2026-10-06, where a housing sold under that name would not seat in a CYD
    header. A different kit under the same name, pre-crimped leads from 2P to
    10P, was offered to the same header on 2026-10-16 and clicked and held.
    Both stand, because "MX1.25" is a seller's label and not a series. So the
    advice was telling people to refuse a part that is sometimes exactly the
    right one. That is the same step past the evidence this section already
    corrected once in the other direction: the series was first named off a
    pitch measurement, and a bag's wording determines it no better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
2026-11-01 vendor hccapx and pcap serializers for handshake export
    I copied in the upstream source I need to port EAPOL/PMKID export to
    hashcat .hccapx and Wireshark .pcap. It lives under third_party/, outside
    the sketch and its src/, so arduino-cli does not compile it and the
    firmware image is unchanged. Nothing is wired yet.
    hccapx_serializer and the frame_analyzer parser come from risinek's
    esp32-wifi-penetration-tool (MIT, 2021), which ran on the classic ESP32.
    I left out frame_analyzer.c, the promiscuous-capture driver, since I
    capture frames my own way; only the parser and types come across.
    pcap_serializer comes from C5Lab's projectZero instead, where it was
    rewritten from risinek's original w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
2026-11-01 port the hccapx exporter behind PUEO_HANDSHAKE_EXPORT
    Wire the vendored risinek serializer into the sketch so a captured WPA
    4-way handshake can be written to the SD card as a hashcat .hccapx and
    cracked off the device. Off by default: the flag in FeatureFlags.h is 0,
    so the shipped firmware does not carry it and the call sites in wifi.cpp
    are not even compiled.
    The one thing the bridge exists to prevent is risinek's parser reading a
    raw frame. It finds the EAPOL payload at a fixed offset with no length
    guard, which is what eapol-capture.md was written to avoid, so my own
    Eapol is the gatekeeper: a frame reaches the serializer only after Eapol
    has confirmed it is an EAPOL-Key message, that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
